tachiniererin/glasgow/hardware/boards/glasgow/revD1/glasgow.pdf

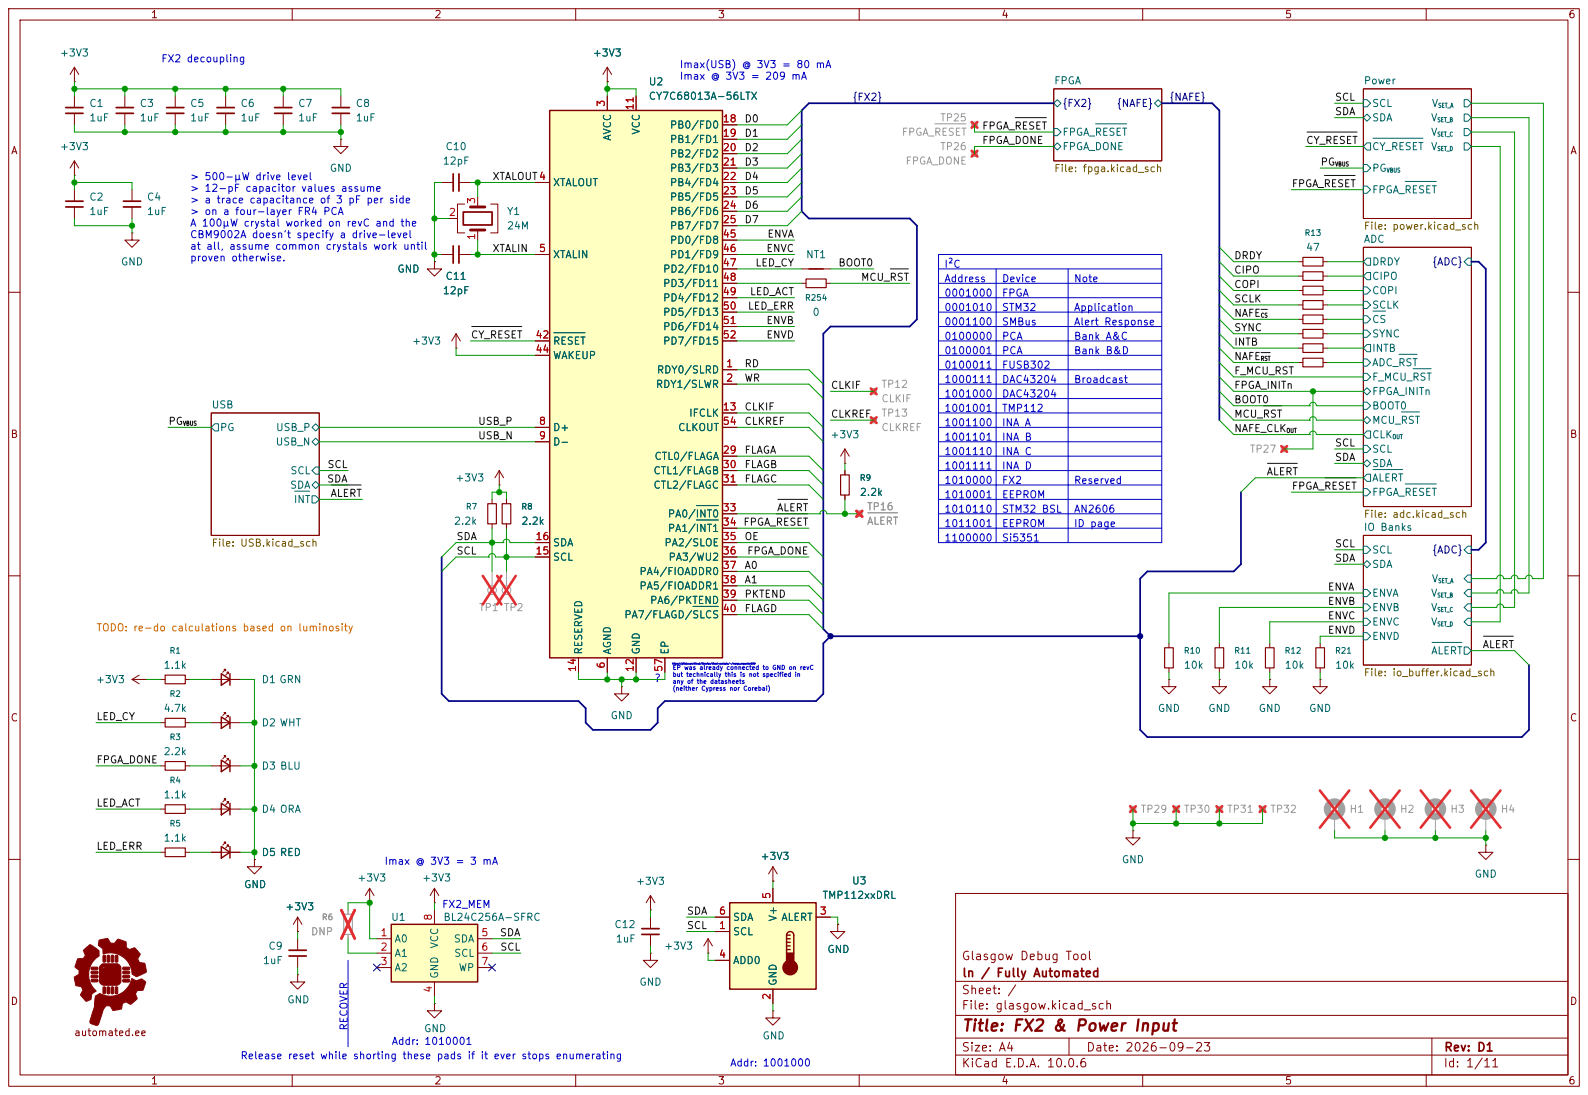
[picture p1: page 1]

FX2 decoupling > 500-µW drive level > 12-pF capacitor values assume > a trace capacitance of 3 pF per side > on a four-layer FR4 PCA

VSET_A VSET_B VSET_C CY_RESET VSET_D PGVBUS FPGA_RESET Power File: power.kicad_sch SYNC
SDA SCL CY_RESET SDA BOOT0

A 100µW crystal worked on revC and the CBM9002A doesn't specify a drive-level at all, assume common crystals work until proven otherwise.

0100011 | FUSB302
1000111 | DAC43204 | Broadcast 1001000

1001001 | TMP112

1010000 | FX2 EEPROM | Reserved 1010001

1010110 | STM32 BSL | AN2606

TODO: re-do calculations based on luminosity

https://gitlab.com/kicad/libraries/kicad-symbols/-/merge_requests/289
EP was already connected to GND on revC
but technically this is not specified in
any of the datasheets

Size: A4 | Rev: D1
KiCad E.D.A. 10.0.6 | Id: 1/11

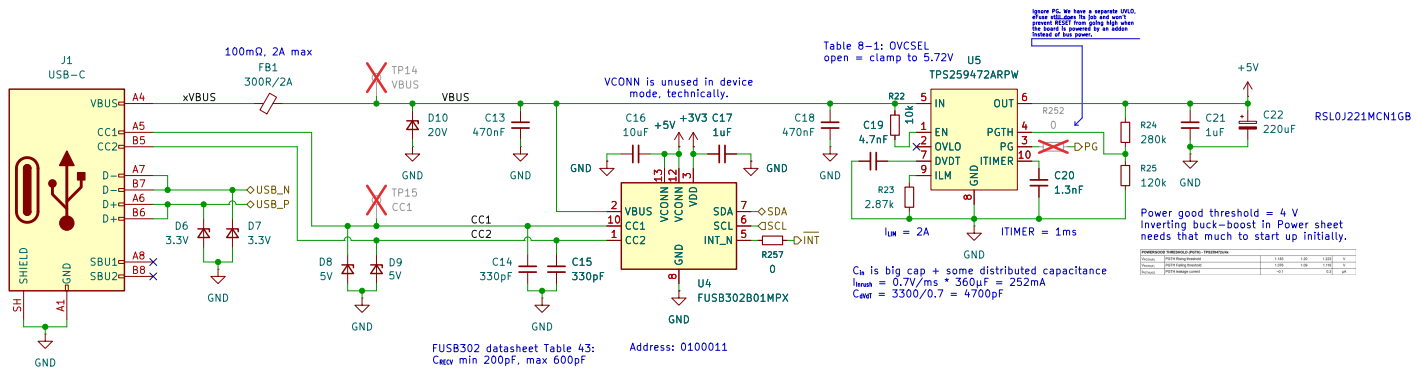
[picture p2: page 2]

Ignore PG. We have a separate UVLO, eFuse still does its job and won't prevent RESET from going high when

instead of bus power. Cin is big cap + some distributed capacitance
Table 8-1: OVCSEL open = clamp to 5.72V U5

the board is powered by an addon

Inverting buck-boost in Power sheet needs that much to start up initially. FUSB302 datasheet Table 43: CRECV min 200pF, max 600pF

Glasgow Debug Tool GND

ln / Fully Automated
Sheet: /USB/
File: USB.kicad_sch
Title: USB input protection

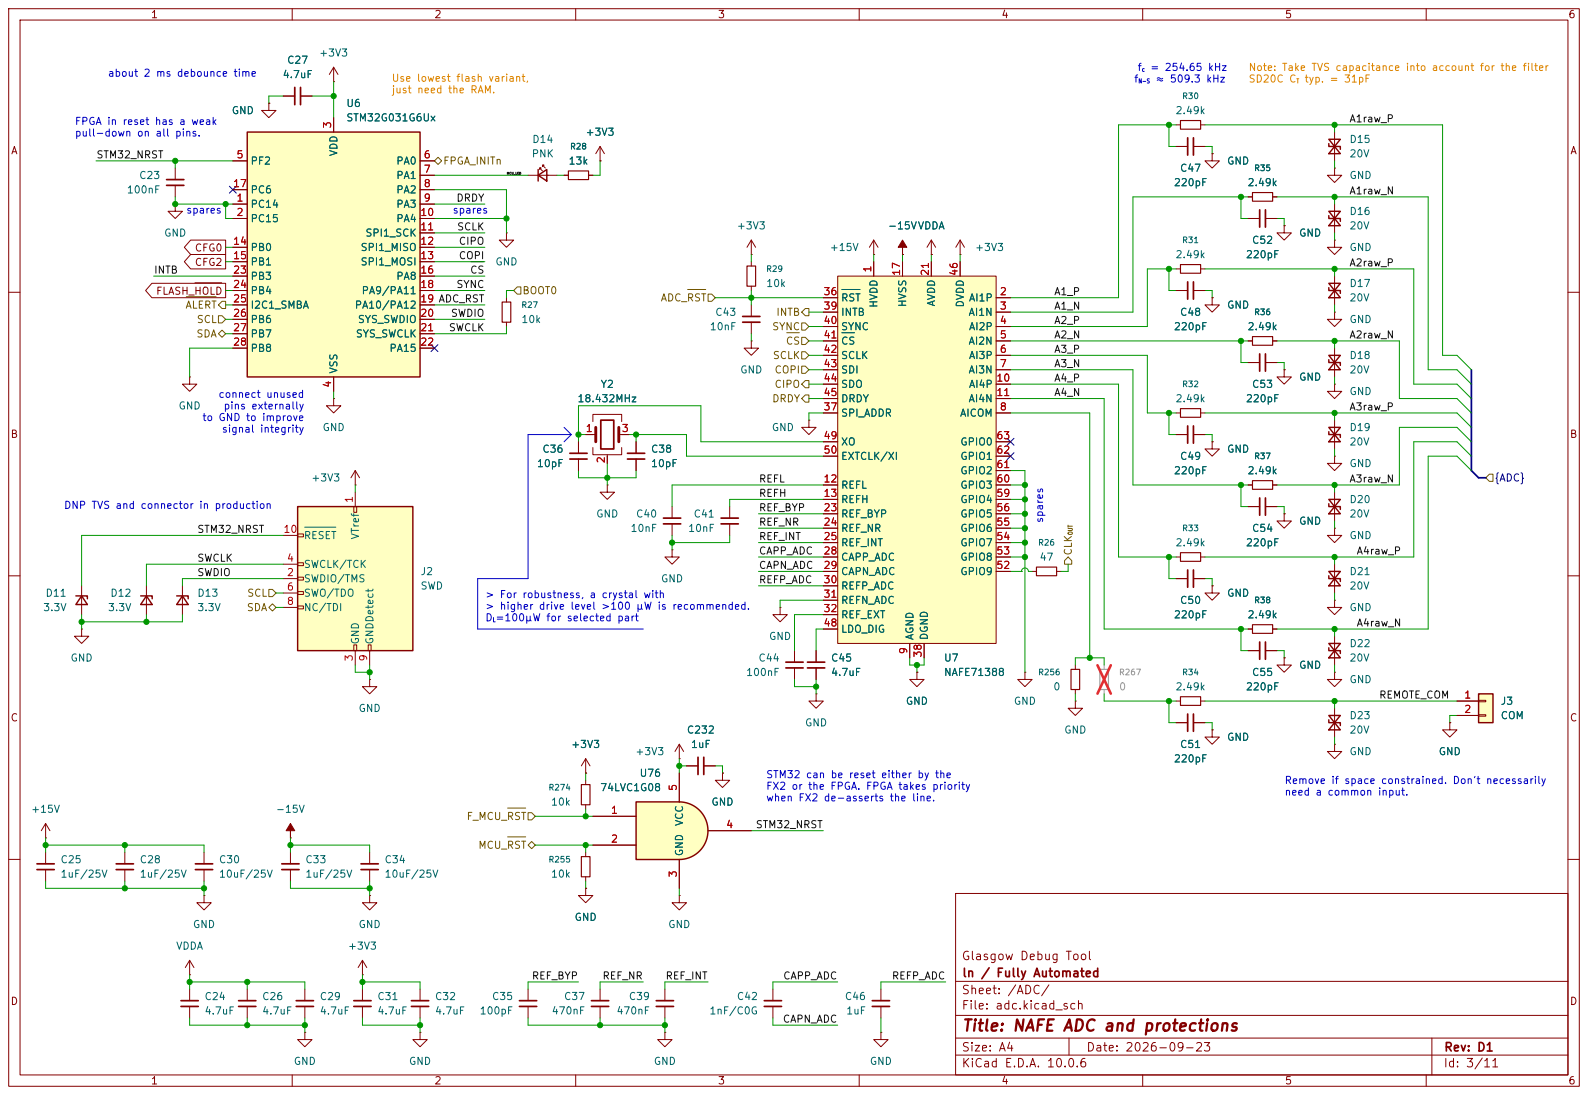
[picture p3: page 3]

just need the RAM. connect unused
GND

spares Use lowest flash variant,

pins externally
to GND to improve

FX2 or the FPGA. FPGA takes priority when FX2 de-asserts the line.

ln / Fully Automated
Sheet: /ADC/
File: adc.kicad_sch
Title: NAFE ADC and protections

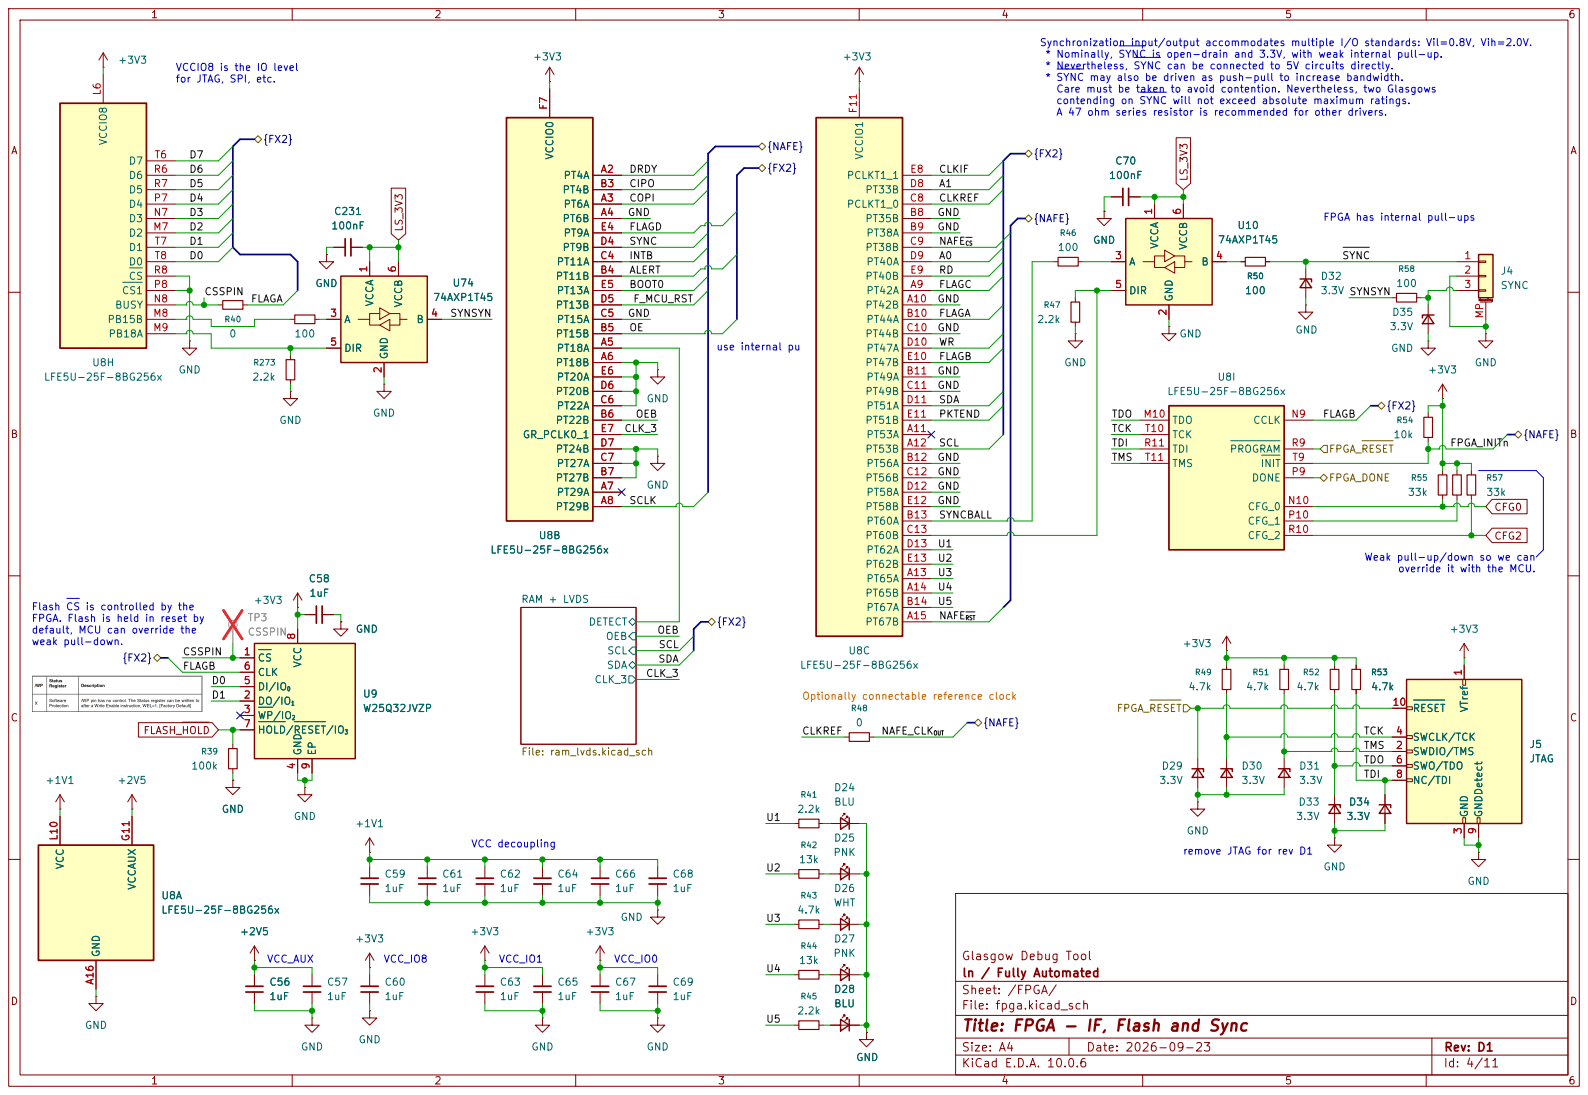
[picture p4: page 4]

Synchronization input/output accommodates multiple I/O standards: Vil=0.8V, Vih=2.0V. * Nominally, SYNC is open-drain and 3.3V, with weak internal pull-up. * Nevertheless, SYNC can be connected to 5V circuits directly. * SYNC may also be driven as push-pull to increase bandwidth. Care must be taken to avoid contention. Nevertheless, two Glasgows

VCCIO8 is the IO level for JTAG, SPI, etc.

contending on SYNC will not exceed absolute maximum ratings. A 47 ohm series resistor is recommended for other drivers.

FPGA has internal pull-ups Weak pull-up/down so we can

override it with the MCU. use internal pu

SCL SDA CLK_3 RAM + LVDS

Flash CS is controlled by the
FPGA. Flash is held in reset by

Glasgow Debug Tool DETECT OEB

4 DI/IO0 5 CLK 6 HOLD/RESET/IO3 7 VCC

remove JTAG for rev D1

ln / Fully Automated
Sheet: /FPGA/
File: fpga.kicad_sch
Title: FPGA - IF, Flash and Sync

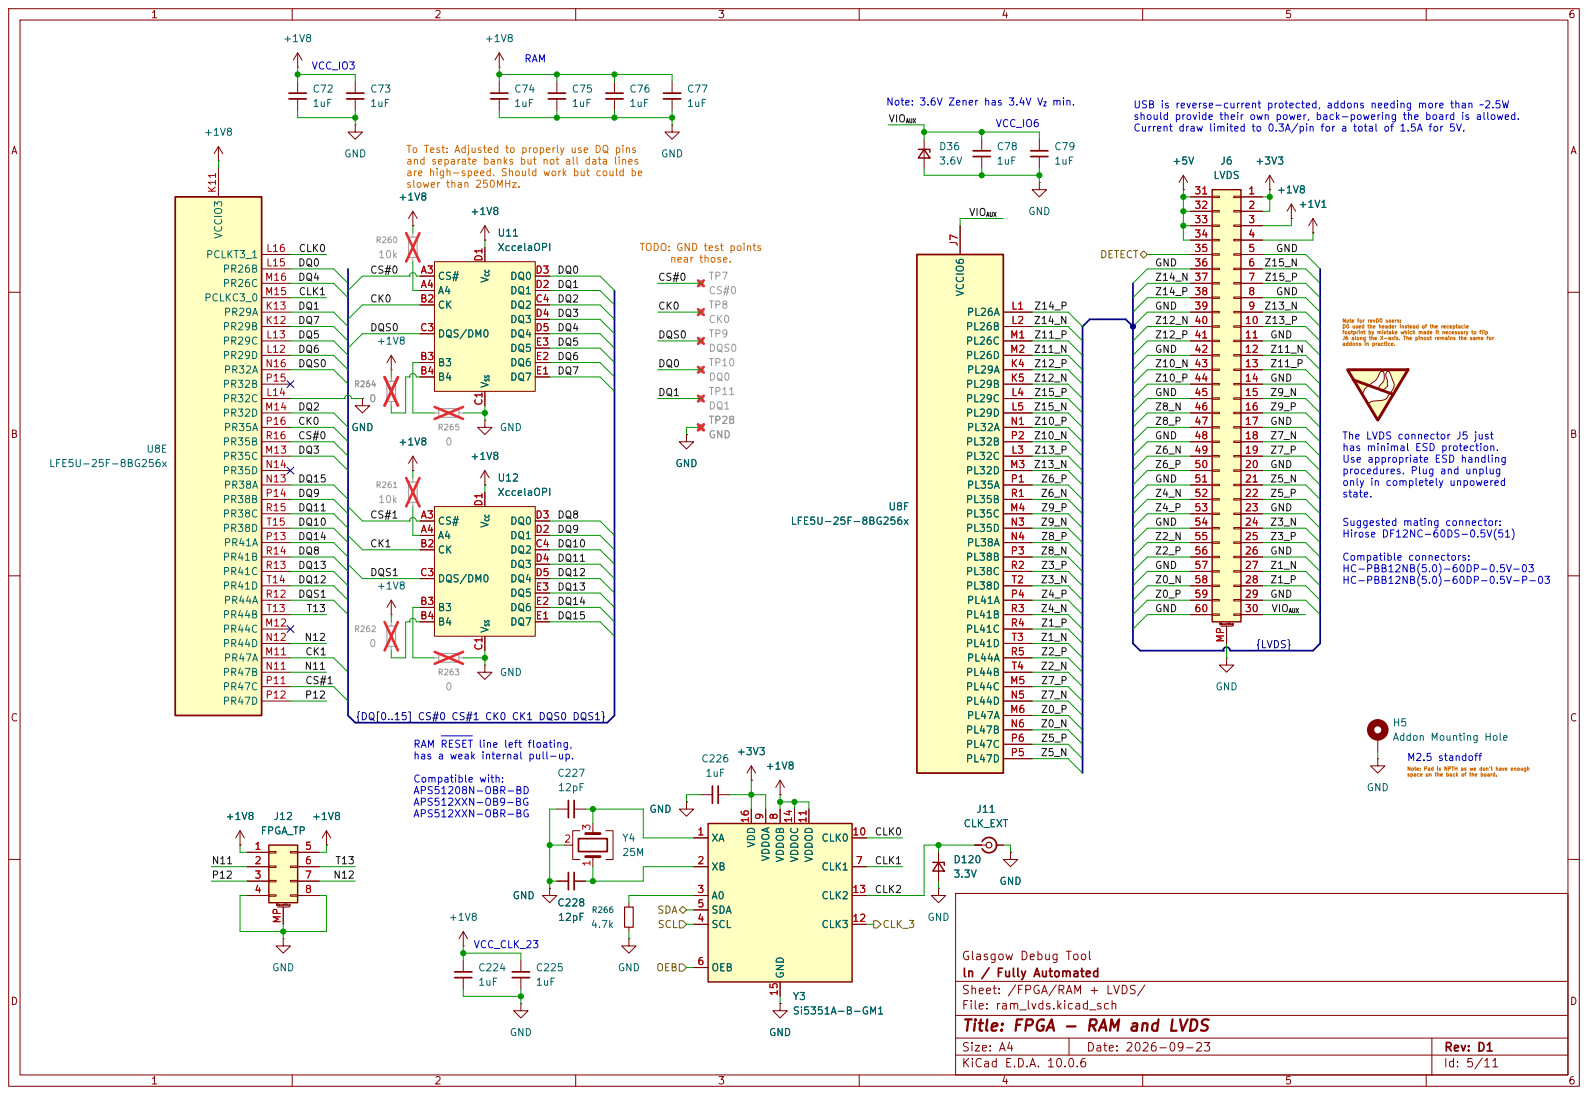
[picture p5: page 5]

J6 along the X-axis. The pinout remains the same for addons in practice. USB is reverse-current protected, addons needing more than ~2.5W

should provide their own power, back-powering the board is allowed. Current draw limited to 0.3A/pin for a total of 1.5A for 5V. VCC_IO6

To Test: Adjusted to properly use DQ pins and separate banks but not all data lines are high-speed. Should work but could be
DQS0 DQ13 DQ8 DQ10

Addon Mounting Hole GND +1V8 +1V8

DETECT SDA SCL OEB

GND
space on the back of the board. M2.5 standoff The LVDS connector J5 just has minimal ESD protection. Use appropriate ESD handling

footprint by mistake which made it necessary to flip

procedures. Plug and unplug

only in completely unpowered state. RAM RESET line left floating, has a weak internal pull-up.

Compatible connectors: HC-PBB12NB(5.0)-60DP-0.5V-03 HC-PBB12NB(5.0)-60DP-0.5V-P-03

Compatible with: APS51208N-OBR-BD

Note: Pad is NPTH as we don't have enough

8 VDDOA 9 CLK0 10 VDDOD 11 CLK3 12 CLK2 13 VDDOC 14 GND 15 VDD 16

8 VDDOA 9 CLK0 10 VDDOD 11 CLK3 12 CLK2 13 VDDOC 14 GND 15 VDD 16 GND

Glasgow Debug Tool GND

ln / Fully Automated
Sheet: /FPGA/RAM + LVDS/
File: ram_lvds.kicad_sch
Title: FPGA - RAM and LVDS

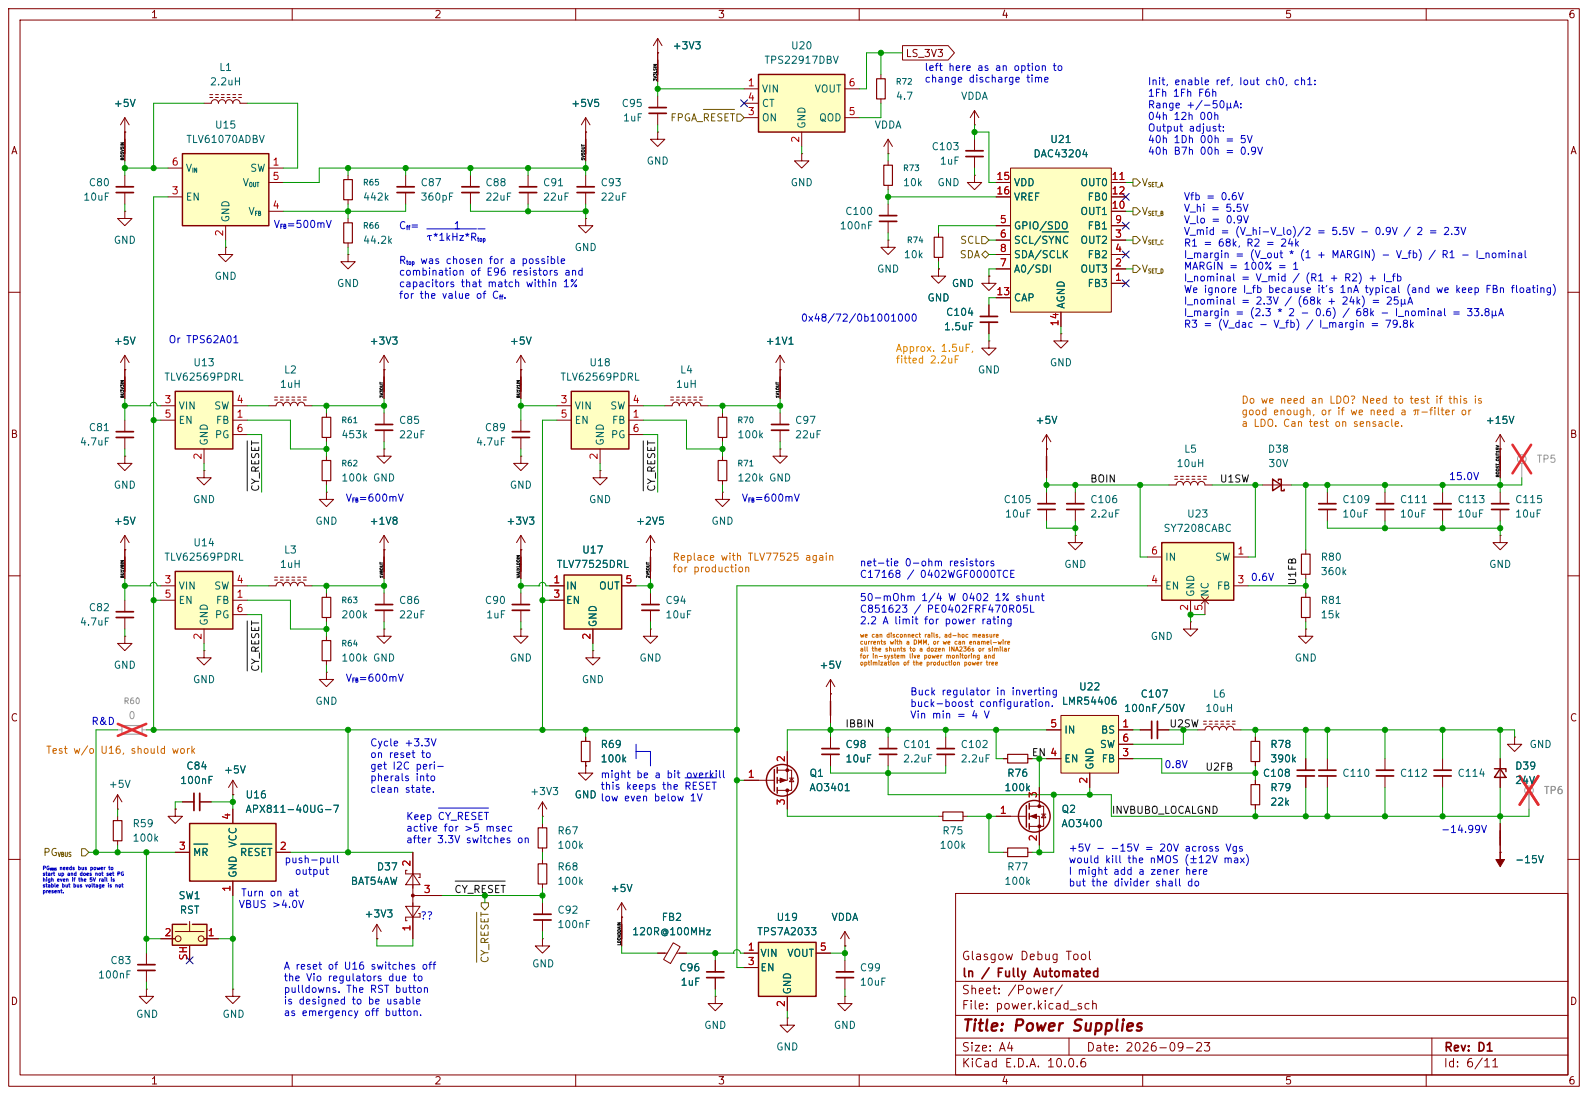
[picture p6: page 6]

left here as an option to

change discharge time Cycle +3.3V on reset to get I2C peri-

Init, enable ref, Iout ch0, ch1: 1Fh 1Fh F6h Range +/-50µA: 04h 12h 00h Output adjust: 40h 1Dh 00h = 5V 40h B7h 00h = 0.9V

τ*1kHz*Rtop Rtop was chosen for a possible

combination of E96 resistors and
capacitors that match within 1%

I_nominal = V_mid / (R1 + R2) + I_fb We ignore I_fb because it's 1nA typical (and we keep FBn floating)

we can disconnect rails, ad-hoc measure
currents with a DMM, or we can enamel-wire all the shunts to a dozen INA236s or similar

for in-system live power monitoring and
optimization of the production power tree Buck regulator in inverting

buck-boost configuration. Vin min = 4 V push-pull

pherals into clean state. ?? Keep CY_RESET active for >5 msec after 3.3V switches on

PGVBUS needs bus power to
start up and does not set PG
high even if the 5V rail is
stable but bus voltage is not present.

Turn on at VBUS >4.0V

A reset of U16 switches off
the Vio regulators due to pulldowns. The RST button

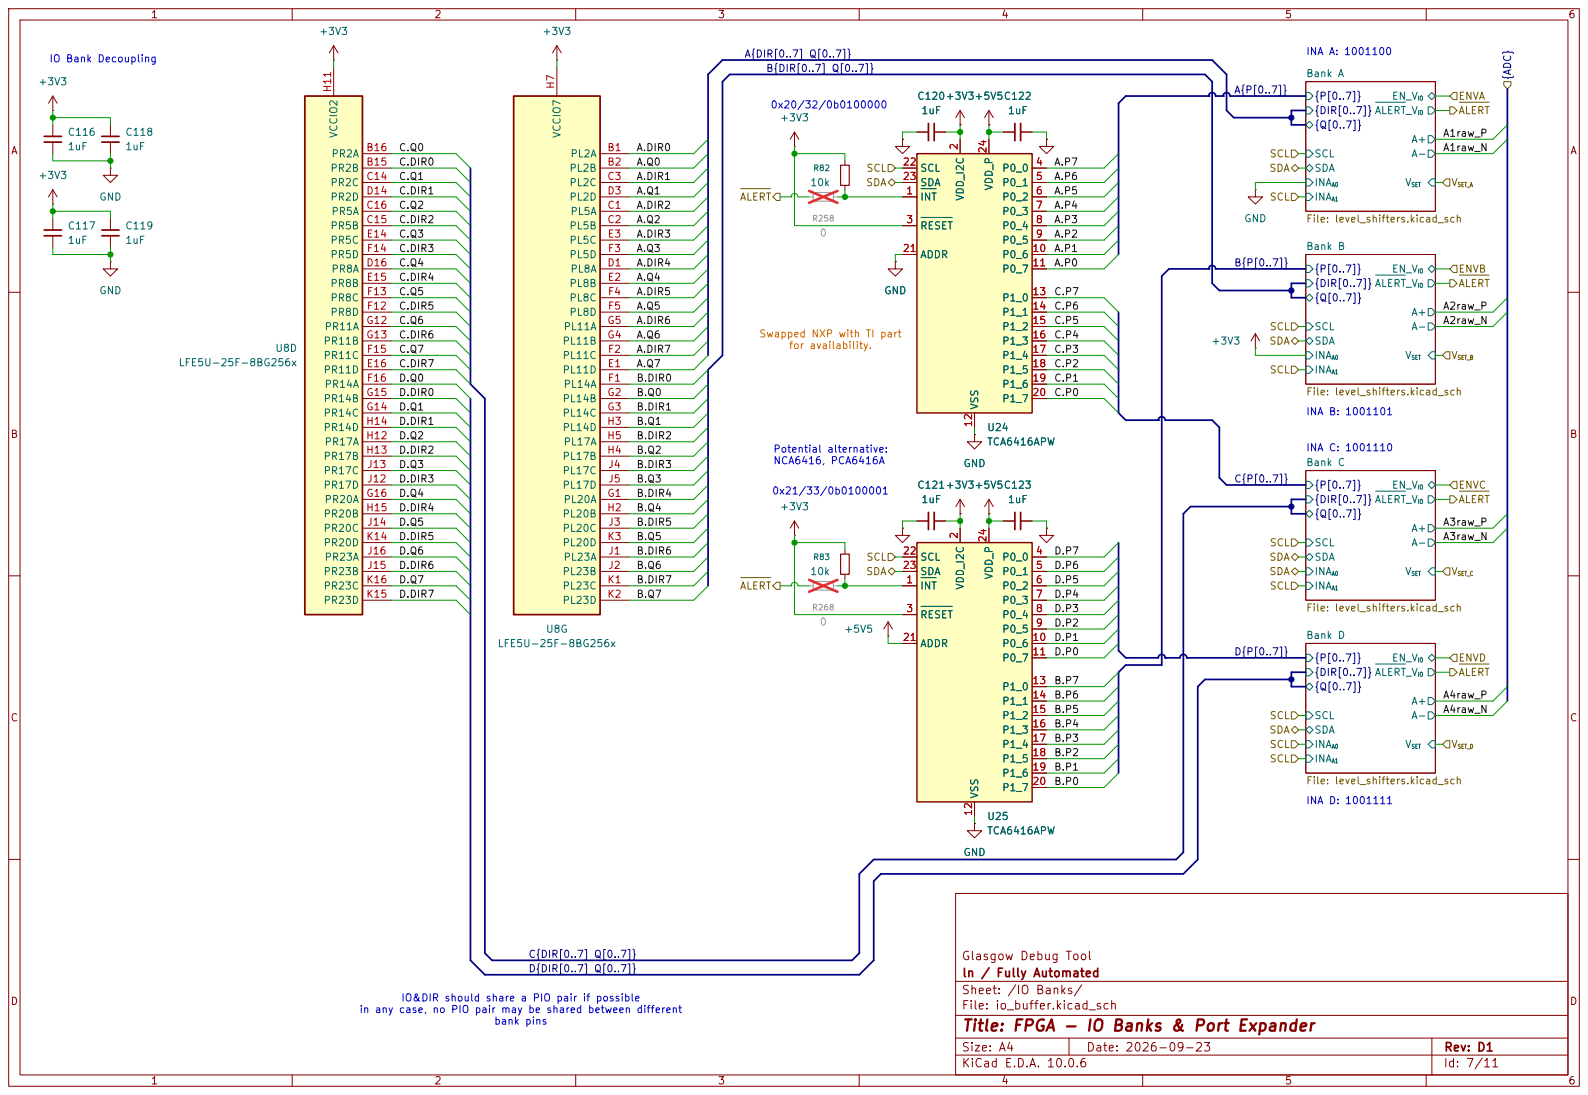
[picture p7: page 7]

Swapped NXP with TI part
for availability.
SCL 22

Glasgow Debug Tool
ln / Fully Automated
Sheet: /IO Banks/
File: io_buffer.kicad_sch
Title: FPGA - IO Banks & Port Expander

IO&DIR should share a PIO pair if possible

in any case, no PIO pair may be shared between different bank pins

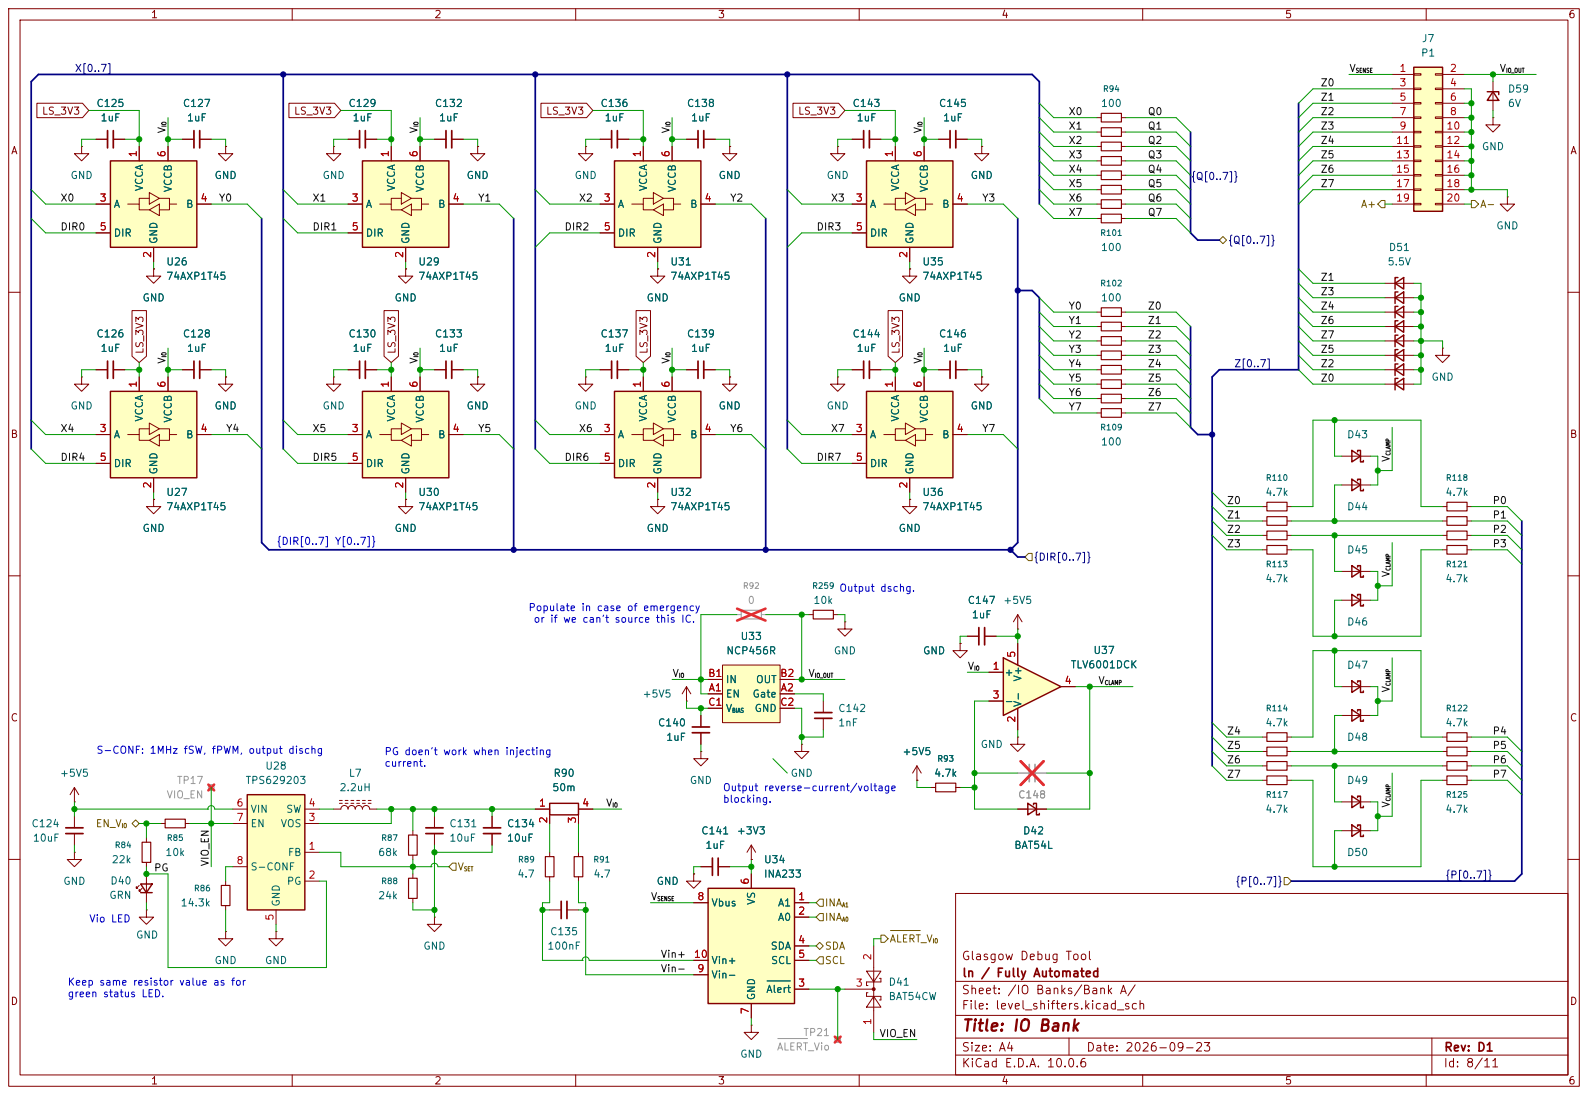
[picture p8: page 8]

{DIR[0..7] Y[0..7]} S-CONF: 1MHz fSW, fPWM, output dischg

Populate in case of emergency or if we can't source this IC. PG doen't work when injecting

Output reverse-current/voltage
blocking.

Keep same resistor value as for green status LED. Vio LED

ln / Fully Automated
Sheet: /IO Banks/Bank A/
File: level_shifters.kicad_sch
Title: IO Bank

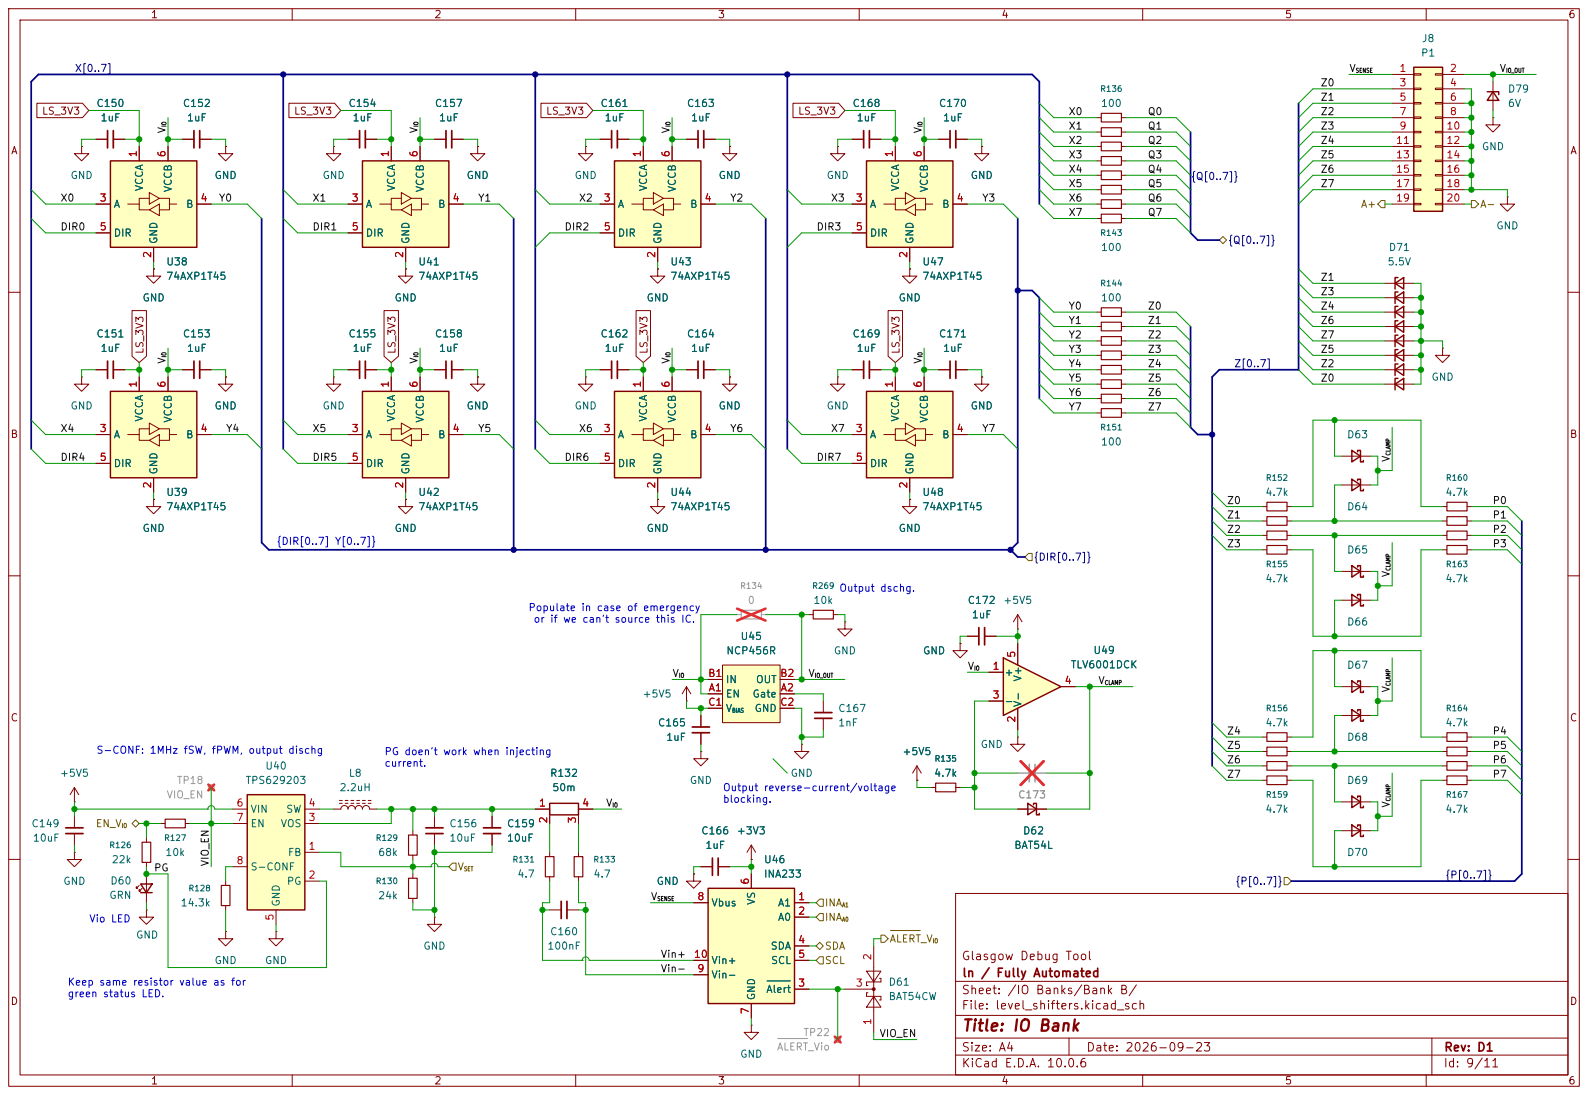
[picture p9: page 9]

{DIR[0..7] Y[0..7]} S-CONF: 1MHz fSW, fPWM, output dischg

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

Keep same resistor value as for green status LED. Vio LED

ln / Fully Automated
Sheet: /IO Banks/Bank B/
File: level_shifters.kicad_sch
Title: IO Bank

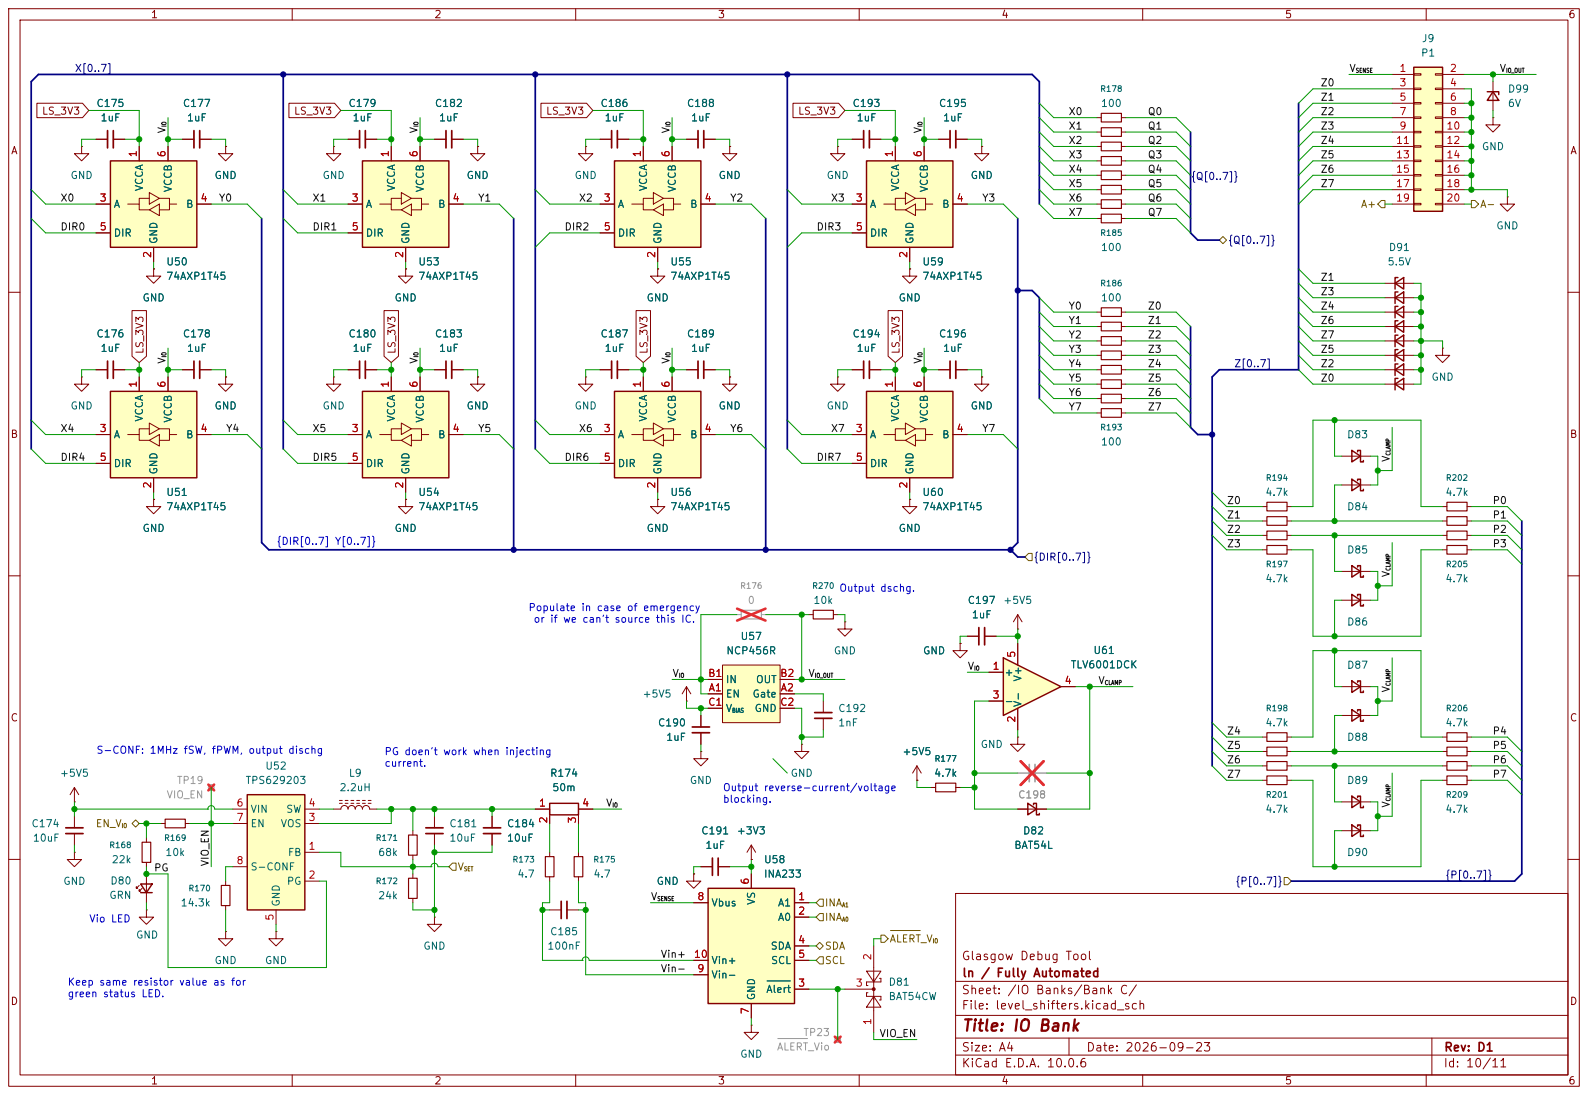
[picture p10: page 10]

{DIR[0..7] Y[0..7]} S-CONF: 1MHz fSW, fPWM, output dischg

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

Output reverse-current/voltage
blocking.

Keep same resistor value as for green status LED. Vio LED

ln / Fully Automated
Sheet: /IO Banks/Bank C/
File: level_shifters.kicad_sch
Title: IO Bank

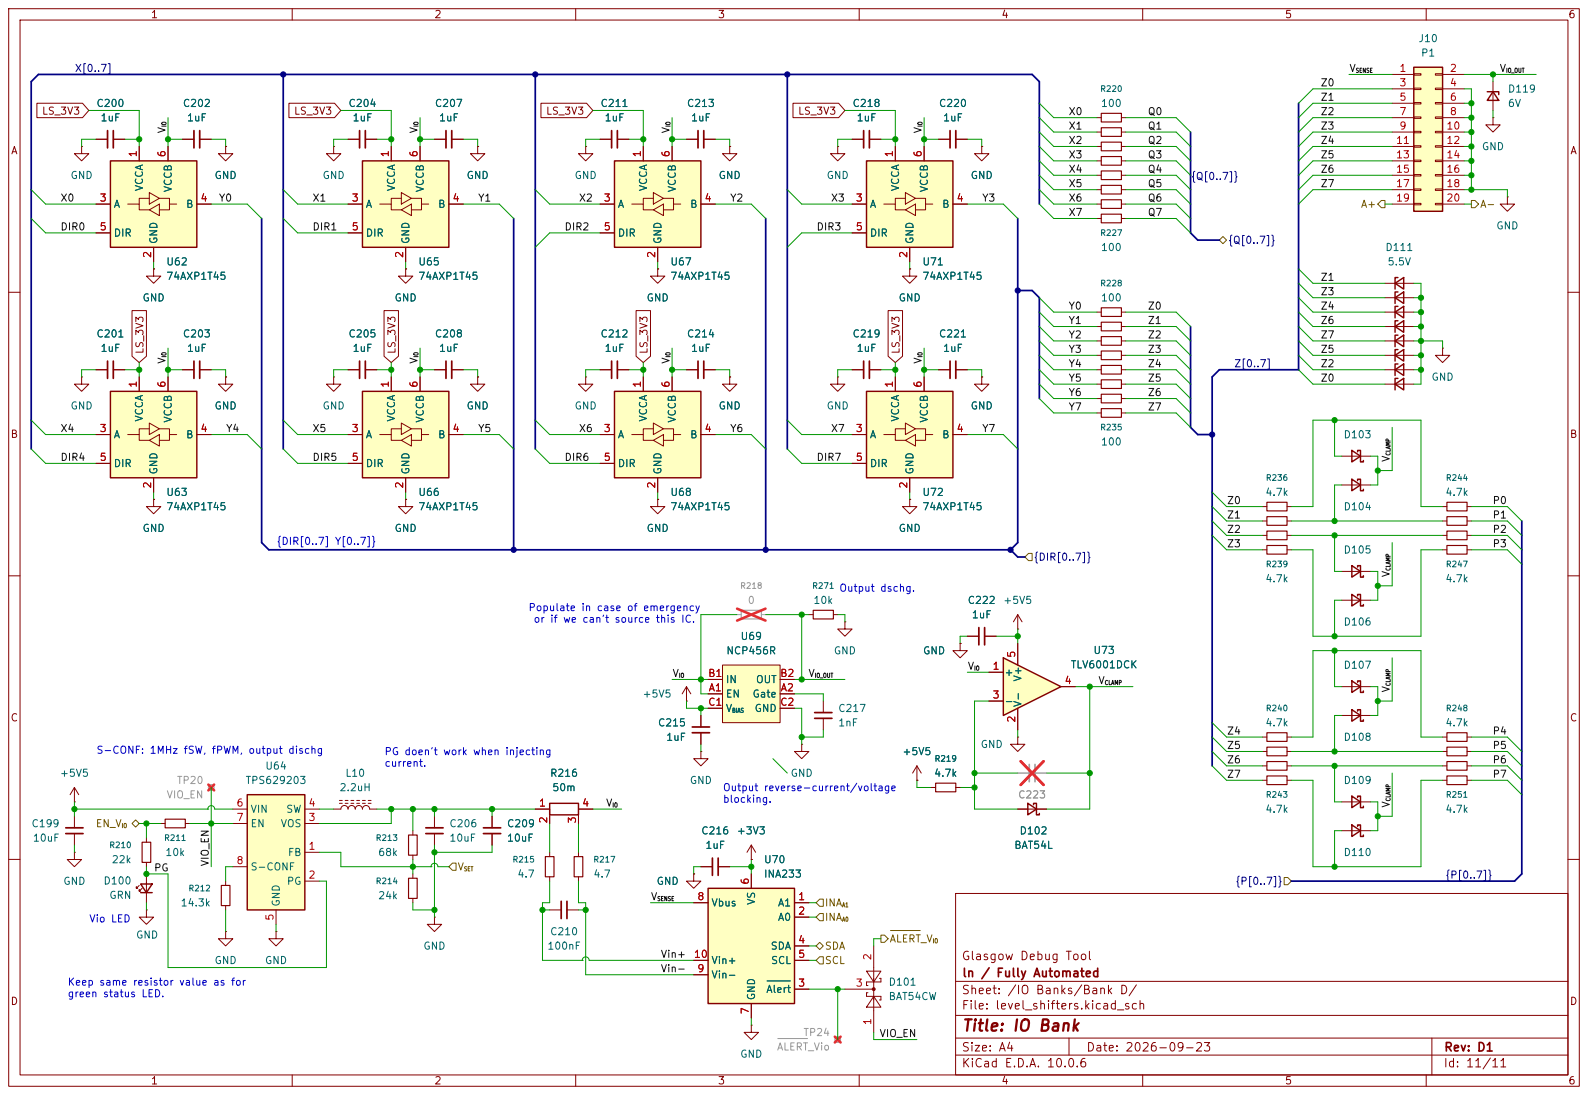
[picture p11: page 11]

{DIR[0..7] Y[0..7]} S-CONF: 1MHz fSW, fPWM, output dischg

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

Output reverse-current/voltage
blocking.

Keep same resistor value as for green status LED. Vio LED

ln / Fully Automated
Sheet: /IO Banks/Bank D/
File: level_shifters.kicad_sch
Title: IO Bank
