tachiniererin/glasgow/(commit log)

2026-06-09 wip rev_d pin mapping
2026-09-01 add wip revD1
    [USB.kicad_sch, adc.kicad_sch, fpga.kicad_sch, glasgow.kicad_pcb, glasgow.kicad_sch, io_buffer.kicad_sch, level_shifters.kicad_sch, power.kicad_sch]
2026-09-01 add clock gen
    [USB.kicad_sch, adc.kicad_sch, fpga.kicad_sch, glasgow.kicad_sch, io_buffer.kicad_sch, level_shifters.kicad_sch, power.kicad_sch, ram_lvds.kicad_sch]
2026-09-03 start from 4 V, new inv bubo, more testpoints, synsyn through LS
    [USB.kicad_sch, adc.kicad_sch, fpga.kicad_sch, glasgow.kicad_sch, io_buffer.kicad_sch, level_shifters.kicad_sch, power.kicad_sch, ram_lvds.kicad_sch]
2026-09-04 add the rest of mandatory testpoints
    [adc.kicad_sch, fpga.kicad_sch, glasgow.kicad_pcb, glasgow.kicad_sch]
2026-09-04 pop bulk for adc
    [adc.kicad_sch]
2026-09-08 make mcu reset logic more robust
    [adc.kicad_sch, fpga.kicad_sch, glasgow.kicad_pcb, glasgow.kicad_sch]
2026-09-17 get routed
    [adc.kicad_sch, fpga.kicad_sch, glasgow.kicad_pcb, glasgow.kicad_sch, io_buffer.kicad_sch, level_shifters.kicad_sch, power.kicad_sch, ram_lvds.kicad_sch]
2026-09-18 some physical changes
    replace sync connector with JST SH
    round corners of the PCB to match the mounting holes
    place io bank LEDs symmetrically and in a way that should make the case work
    [fpga.kicad_sch, glasgow.kicad_pcb]
2026-09-18 plot schematic
2026-09-21 wip pcb changes
    [glasgow.kicad_pcb, ram_lvds.kicad_sch]
2026-09-21 update bom
    [USB.kicad_sch, adc.kicad_sch, fpga.kicad_sch, glasgow.kicad_pcb, glasgow.kicad_sch, io_buffer.kicad_sch, level_shifters.kicad_sch, power.kicad_sch]
2026-09-21 fix some more silk issues
    [glasgow.kicad_pcb]
2026-09-22 improve LED clearance, add heatsink area below -15V, improve gnd connection for STM32
    [glasgow.kicad_pcb]
2026-09-22 misc review changes
    disconnect eFuse PG and add comments in schematic as to why
    add slew-rate limiting resistor to NAFE clock
    add esd diode to external clock output
    fix USB D+/D- diff-pairs
    update schematic to current date and set revision to D1
    fix RAM balls B3/B4 assignment
    [USB.kicad_sch, adc.kicad_sch, fpga.kicad_sch, glasgow.kicad_pcb, glasgow.kicad_sch, io_buffer.kicad_sch, level_shifters.kicad_sch, power.kicad_sch]
2026-09-23 update LVDS connector
    add more ground test points on the back
    [USB.kicad_sch, adc.kicad_sch, fpga.kicad_sch, glasgow.kicad_pcb, glasgow.kicad_sch, io_buffer.kicad_sch, level_shifters.kicad_sch, power.kicad_sch]
2026-09-23 add LED datasheets and re-do brightness calculations
    [fpga.kicad_sch, glasgow.kicad_sch]
2026-09-23 new artwork
    [glasgow.kicad_pcb]
