tachiniererin/glasgow/hardware/boards/glasgow/revD1/glasgow.kicad_pcb

## KiCad design hardware/boards/glasgow/revD1/glasgow.kicad_pcb (2026-09-23)

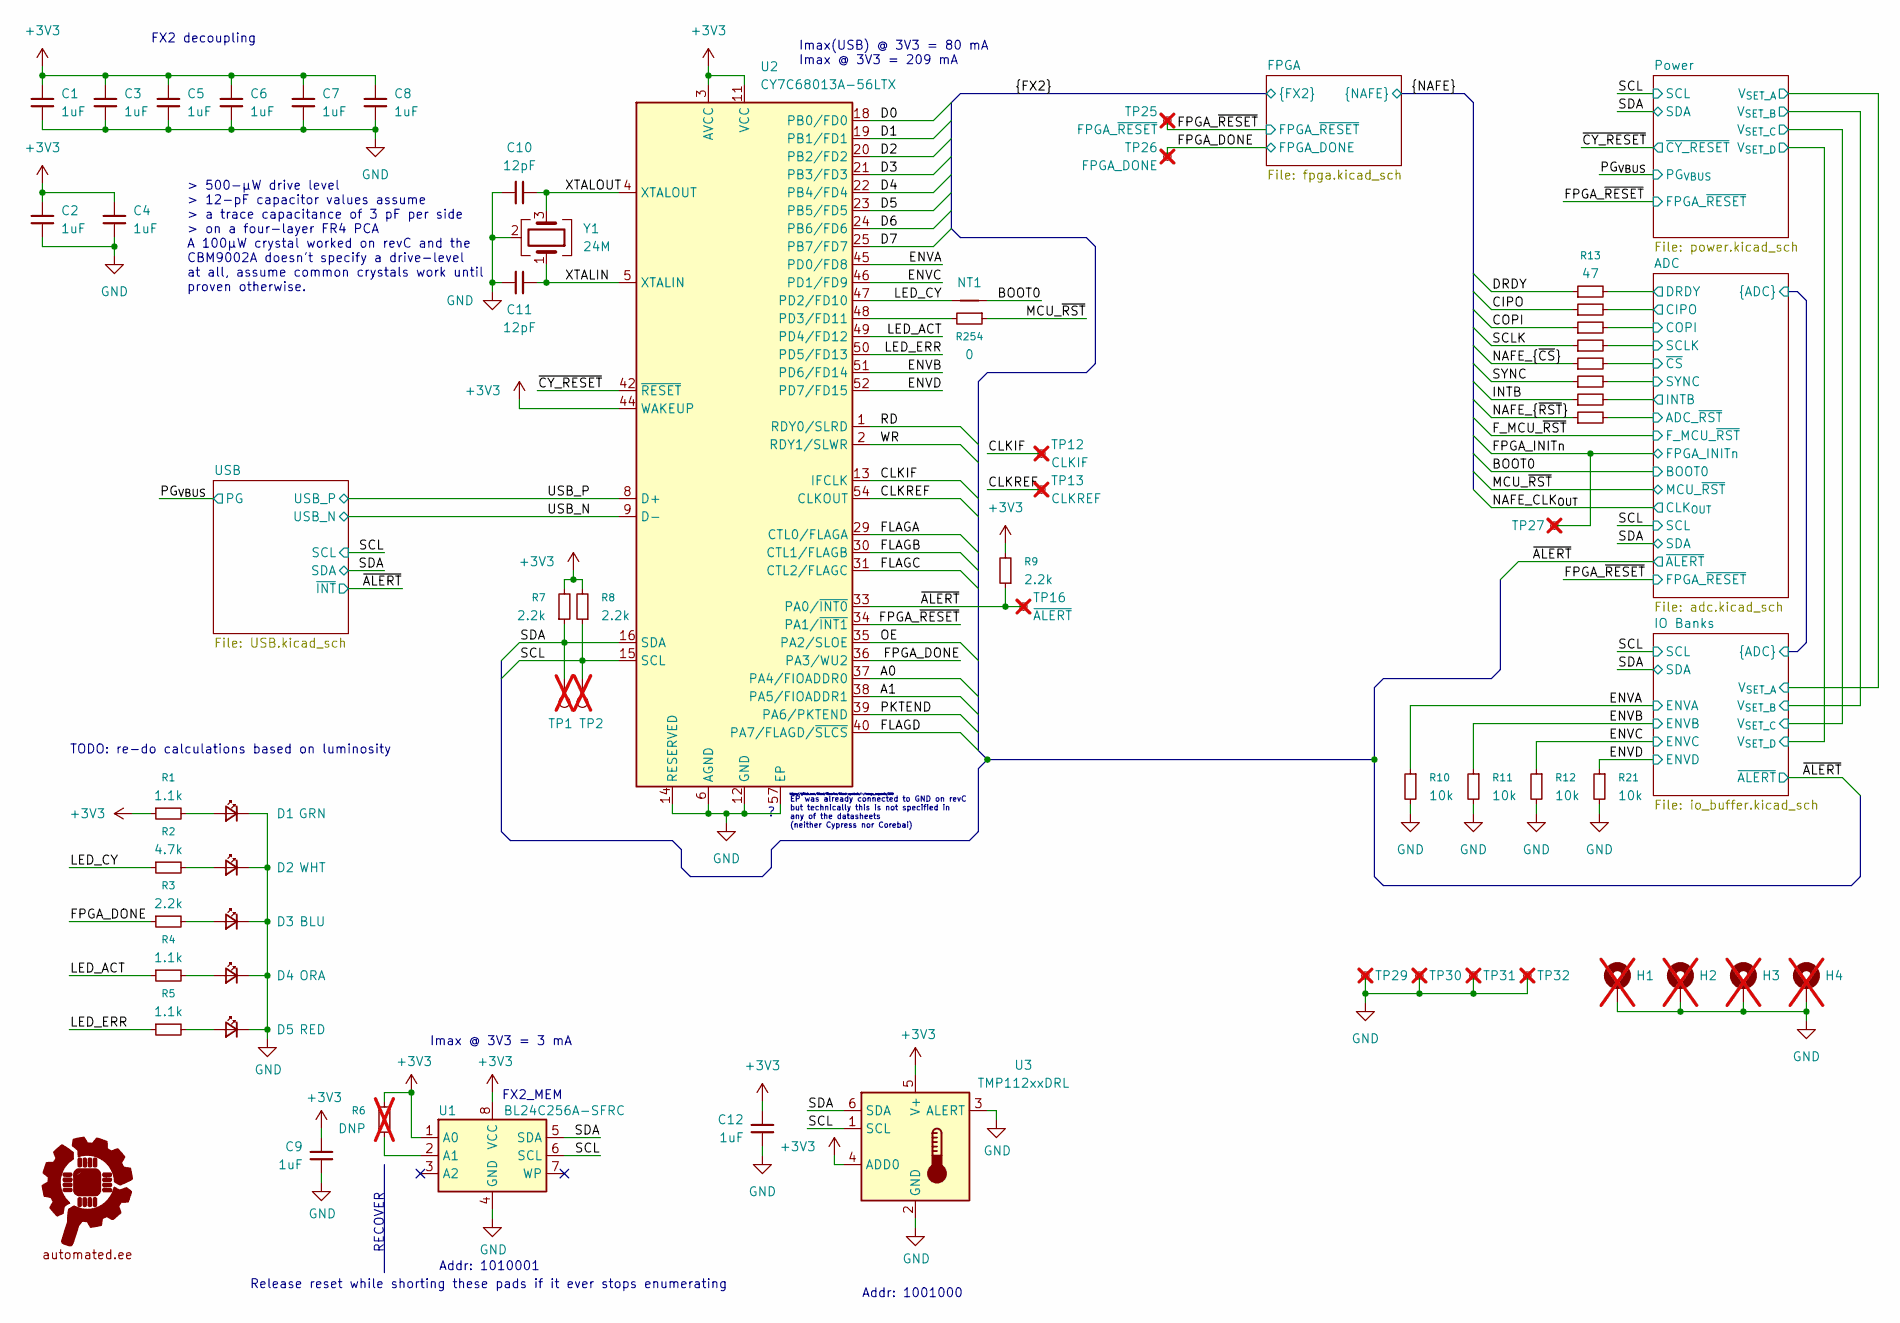
[picture p1: schematic glasgow.kicad_sch, FX2 & Power Input]

Parts:
C1, C2, C3, C4, C5, C6, C7, C8, C9, C12: 1uF; C_0402_1005Metric; MPN CL05A105KA5NQNC; LCSC C52923
C10, C11: 12pF; C_0402_1005Metric; MPN 0402CG120J500NT; LCSC C1547
D1: GRN; LED_0603_1608Metric; MPN NCD0603G1; LCSC C2986048
D2: WHT; LED_0603_1608Metric; MPN NCD0603W1; LCSC C2290
D3: BLU; LED_0603_1608Metric; MPN ORH-B36G; LCSC C2986058
D4: ORA; LED_0603_1608Metric; MPN NCD0603O1; LCSC C84269
D5: RED; LED_0603_1608Metric; MPN NCD0603R1; LCSC C2986060
G1: Fully_Automated_Logo; fully_automated_logo_silkscreen
H1, H2, H3, H4: MountingHole_Pad; MountingHole_3.2mm_M3_Pad; not fitted
NT1: ACT_BOOT; NetTie-2_SMD_Pad0.5mm
R1, R4, R5: 1.1k; R_0402_1005Metric; MPN 0402WGF1101TCE; LCSC C25860
R2: 4.7k; R_0402_1005Metric; MPN 0402WGF4701TCE; LCSC C25900
R3, R7, R8, R9: 2.2k; R_0402_1005Metric; MPN RC0402FR-132K2L; LCSC C25879
R6: DNP; R_0402_1005Metric; not fitted
R10, R11, R12, R21: 10k; R_0402_1005Metric; MPN 0402WGF1002TCE; LCSC C25744
R13, R14, R15, R16, R17, R18, R19, R20: 47; R_0201_0603Metric; MPN 0201WMF470JTEE; LCSC C620443
R254: 0; R_0402_1005Metric; MPN PE0402FRF470R05L; LCSC C851623
TP1: SDA; TestPoint_Pad_D1.0mm; not fitted
TP2: SCL; TestPoint_Pad_D1.0mm; not fitted
TP12: CLKIF; TestPoint_Pad_D0.5mm; not fitted
TP13: CLKREF; TestPoint_Pad_D0.5mm; not fitted
TP16: ~{ALERT}; TestPoint_Pad_D0.5mm; not fitted
TP25: FPGA_~{RESET}; TestPoint_Pad_D0.5mm; not fitted
TP26: FPGA_DONE; TestPoint_Pad_D0.5mm; not fitted
TP27: FPGA_INITn; TestPoint_Pad_D0.5mm; not fitted
TP29, TP30, TP31, TP32: GND; TestPoint_Pad_D0.5mm; not fitted
U1: BL24C256A-SFRC; TSSOP-8_4.4x3mm_P0.65mm; MPN BL24C256A-SFRC; LCSC C110276
U2: CY7C68013A-56LTX; QFN-56-1EP_8x8mm_P0.5mm_EP4.5x5.2mm; MPN CBM9002A-56ILG; LCSC C476253
U3: TMP112xxDRL; SOT-563; MPN TMP112AIDRLR; LCSC C28927
Y1: 24M; Crystal_SMD_3225-4Pin_3.2x2.5mm; MPN TSX-3225 24.0000MF20G-AC3; LCSC C2650460

Connections:
+3V3: C1.1, C2.1, C3.1, C4.1, C5.1, C6.1, C7.1, C8.1, C9.1, C12.1, R1.1, R6.2, R7.2, R8.2, R9.2, U1.1 (A0), U1.8 (VCC), U2.3 (AVCC), U2.7 (AVCC), U2.11 (VCC), U2.17 (VCC), U2.27 (VCC), U2.32 (VCC), U2.43 (VCC), U2.44 (WAKEUP), U2.55 (VCC), U3.4 (ADD0), U3.5 (V+); also elsewhere on the board
/A0: U2.37 (PA4/FIOADDR0); also elsewhere on the board
/A1: U2.38 (PA5/FIOADDR1); also elsewhere on the board
/ADC/ADC_~RST: R20.2; also elsewhere on the board
/ADC/CIPO: R14.2; also elsewhere on the board
/ADC/COPI: R15.2; also elsewhere on the board
/ADC/DRDY: R13.2; also elsewhere on the board
/ADC/INTB: R19.2; also elsewhere on the board
/ADC/SCLK: R16.2; also elsewhere on the board
/ADC/SYNC: R18.2; also elsewhere on the board
/ADC/~CS: R17.2; also elsewhere on the board
/BOOT0: NT1.2; also elsewhere on the board
/CIPO: R14.1; also elsewhere on the board
/CLKIF: TP12.1 (1_1), U2.13 (IFCLK); also elsewhere on the board
/CLKREF: TP13.1 (1_1), U2.54 (CLKOUT); also elsewhere on the board
/COPI: R15.1; also elsewhere on the board
/D0: U2.18 (PB0/FD0); also elsewhere on the board
/D1: U2.19 (PB1/FD1); also elsewhere on the board
/D2: U2.20 (PB2/FD2); also elsewhere on the board
/D3: U2.21 (PB3/FD3); also elsewhere on the board
/D4: U2.22 (PB4/FD4); also elsewhere on the board
/D5: U2.23 (PB5/FD5); also elsewhere on the board
/D6: U2.24 (PB6/FD6); also elsewhere on the board
/D7: U2.25 (PB7/FD7); also elsewhere on the board
/DRDY: R13.1; also elsewhere on the board
/ENVA: R10.1, U2.45 (PD0/FD8); also elsewhere on the board
/ENVB: R11.1, U2.51 (PD6/FD14); also elsewhere on the board
/ENVC: R12.1, U2.46 (PD1/FD9); also elsewhere on the board
/ENVD: R21.1, U2.52 (PD7/FD15); also elsewhere on the board
/FLAGA: U2.29 (CTL0/FLAGA); also elsewhere on the board
/FLAGB: U2.30 (CTL1/FLAGB); also elsewhere on the board
/FLAGC: U2.31 (CTL2/FLAGC); also elsewhere on the board
/FLAGD: U2.40 (PA7/FLAGD/~SLCS); also elsewhere on the board
/FPGA_DONE: R3.1, TP26.1 (1_1), U2.36 (PA3/WU2); also elsewhere on the board
/FPGA_INITn: TP27.1 (1_1); also elsewhere on the board
/FPGA_~RESET: TP25.1 (1_1), U2.34 (PA1/~INT1); also elsewhere on the board
/INTB: R19.1; also elsewhere on the board
/LED_ACT: R4.1, U2.49 (PD4/FD12)
/LED_CY: NT1.1, R2.1, U2.47 (PD2/FD10)
/LED_ERR: R5.1, U2.50 (PD5/FD13)
/MCU_~RST: R254.1; also elsewhere on the board
/NAFE_{~CS}: R17.1; also elsewhere on the board
/NAFE_{~RST}: R20.1; also elsewhere on the board
/OE: U2.35 (PA2/SLOE); also elsewhere on the board
/PKTEND: U2.39 (PA6/PKTEND); also elsewhere on the board
/RD: U2.1 (RDY0/SLRD); also elsewhere on the board
/SCL: R8.1, TP2.1 (1_1), U1.6 (SCL), U2.15 (SCL), U3.1 (SCL); also elsewhere on the board
/SCLK: R16.1; also elsewhere on the board
/SDA: R7.1, TP1.1 (1_1), U1.5 (SDA), U2.16 (SDA), U3.6 (SDA); also elsewhere on the board
/SYNC: R18.1; also elsewhere on the board
/USB_N: U2.9 (D-); also elsewhere on the board
/USB_P: U2.8 (D+); also elsewhere on the board
/WR: U2.2 (RDY1/SLWR); also elsewhere on the board
/XTALIN: C11.2, U2.5 (XTALIN), Y1.1
/XTALOUT: C10.2, U2.4 (XTALOUT), Y1.3
/~ALERT: R9.1, TP16.1 (1_1), U2.33 (PA0/~INT0); also elsewhere on the board
/~CY_RESET: U2.42 (~RESET); also elsewhere on the board
GND: C1.2, C2.2, C3.2, C4.2, C5.2, C6.2, C7.2, C8.2, C9.2, C10.1, C11.1, C12.2, D1.1 (K), D2.1 (K), D3.1 (K), D4.1 (K), D5.1 (K), H1.1 (1_1), H2.1 (1_1), H3.1 (1_1), H4.1 (1_1), R10.2, R11.2, R12.2, R21.2, TP29.1 (1_1), TP30.1 (1_1), TP31.1 (1_1), TP32.1 (1_1), U1.4 (GND), U2.6 (AGND), U2.10 (AGND), U2.12 (GND), U2.14 (RESERVED), U2.26 (GND), U2.28 (GND), U2.41 (GND), U2.53 (GND), U2.56 (GND), U2.57 (EP), U3.2 (GND), U3.3 (ALERT), Y1.2 (G), Y1.4 (G); also elsewhere on the board
unnamed: D1.2 (A), R1.2
unnamed: D2.2 (A), R2.2
unnamed: D3.2 (A), R3.2
unnamed: D4.2 (A), R4.2
unnamed: D5.2 (A), R5.2
unnamed: R6.1, U1.2 (A1)
unnamed: R254.2, U2.48 (PD3/FD11)

Notes on the sheet:
FX2_MEM
TODO: re-do calculations based on luminosity
Imax(USB) @ 3V3 = 80 mA Imax @ 3V3 = 209 mA
Addr: 1010001
> 500-µW drive level > 12-pF capacitor values assume > a trace capacitance of 3 pF per side > on a four-layer FR4 PCA A 100µW crystal worked on revC and the CBM9002A doesn't specify a drive-level at all, assume common crystals work until proven otherwise.
EP was already connected to GND on revC but technically this is not specified in any of the datasheets (neither Cypress nor Corebai)
https://gitlab.com/kicad/libraries/kicad-symbols/-/merge_requests/289
FX2 decoupling
RECOVER
Imax @ 3V3 = 3 mA
Release reset while shorting these pads if it ever stops enumerating
Addr: 1001000

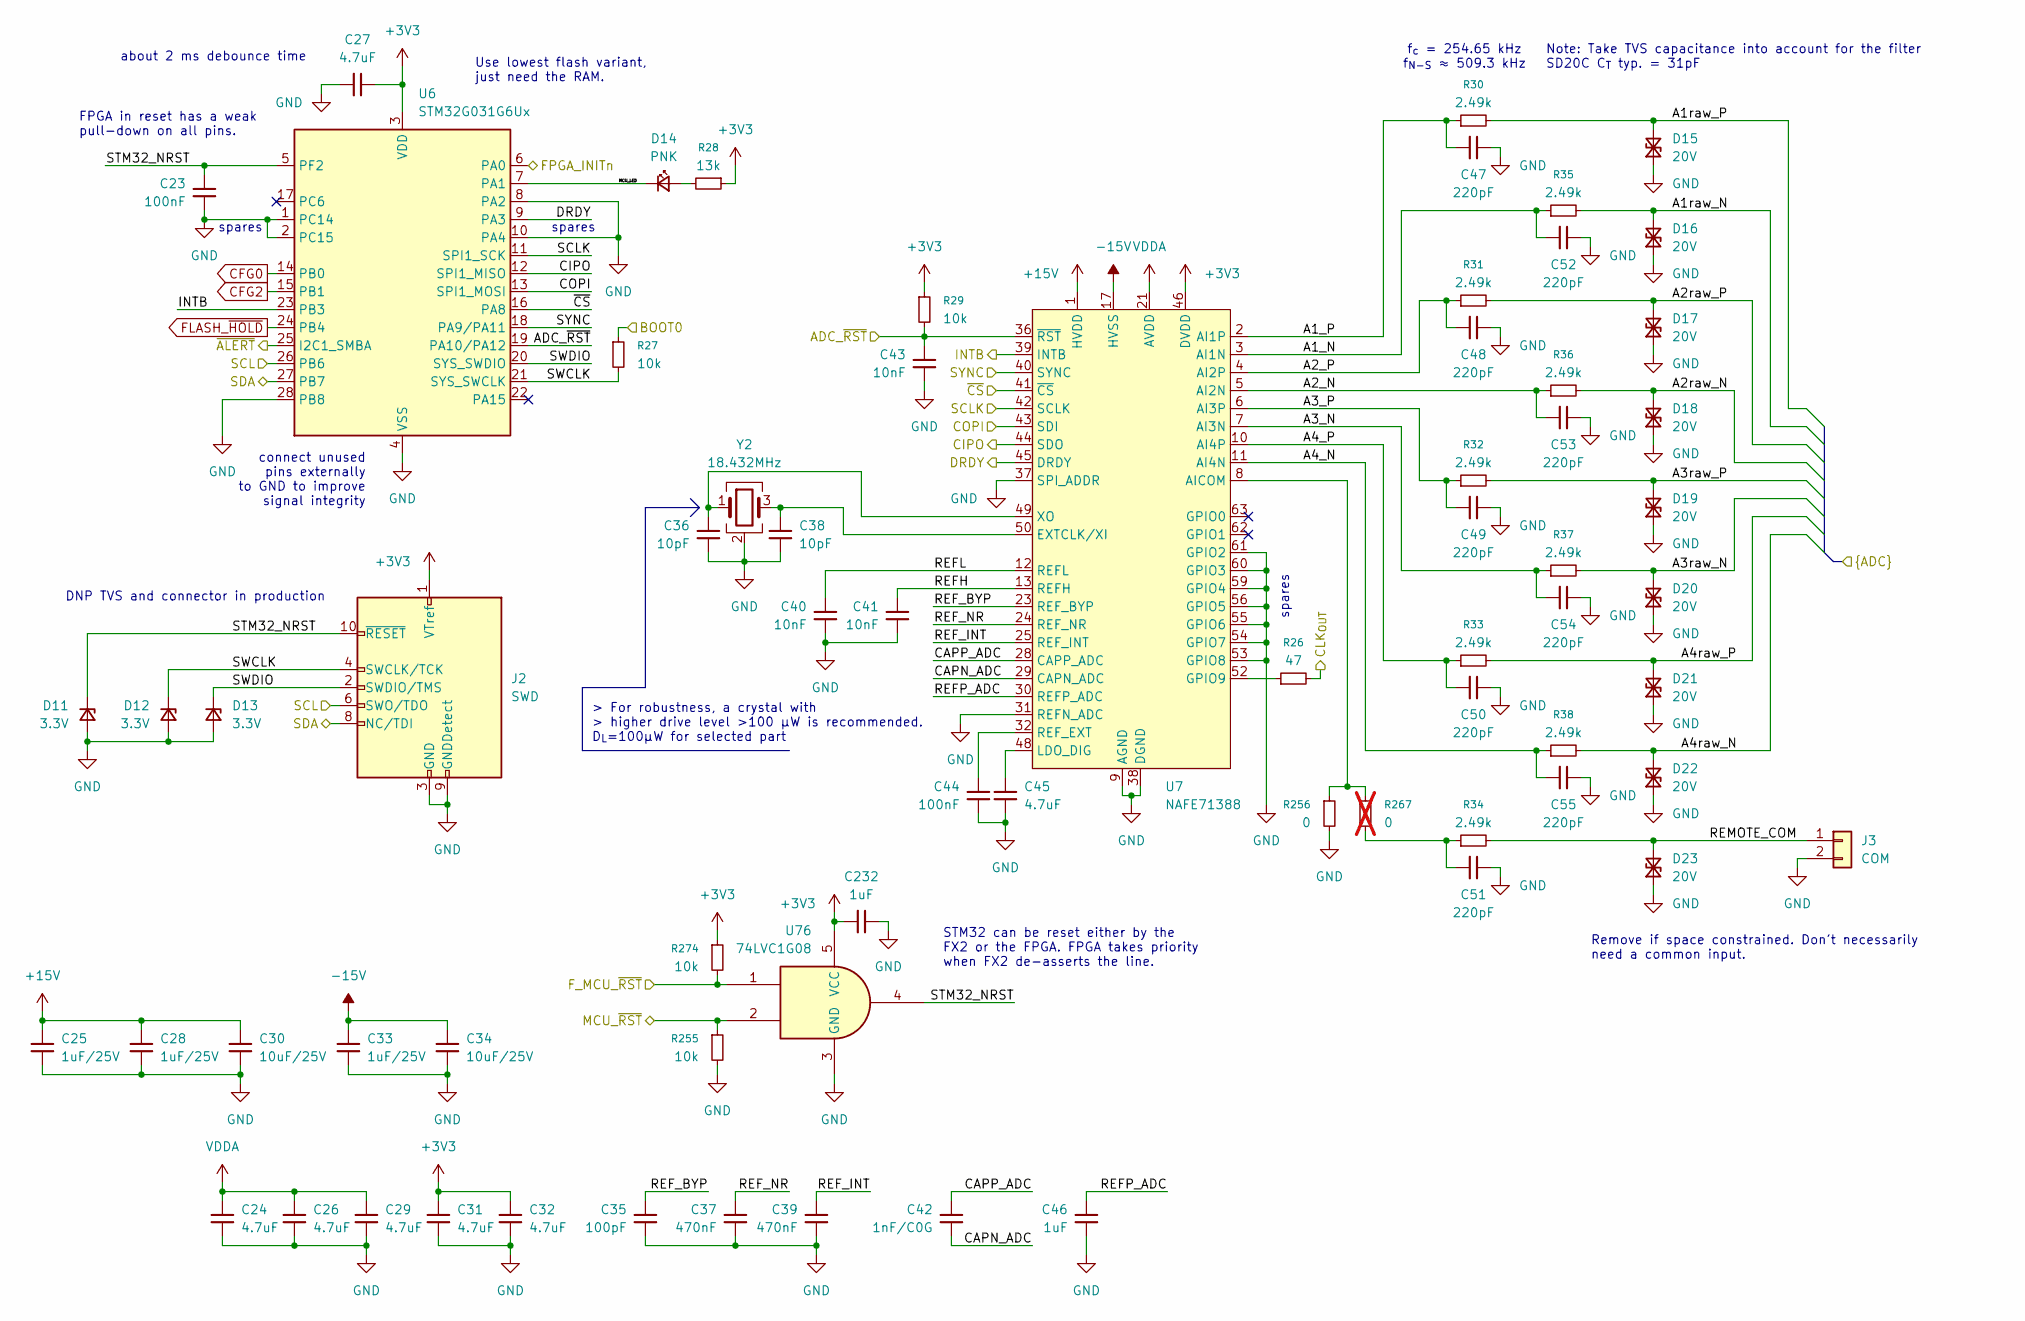
[picture p2: schematic adc.kicad_sch, NAFE ADC and protections]

Parts:
C23, C44: 100nF; C_0402_1005Metric; MPN CL05B104KB54PNC; LCSC C307331
C24, C26, C27, C29, C31, C32, C45: 4.7uF; C_0402_1005Metric; MPN CL05A475MP5NRNC; LCSC C23733
C25, C28, C33: 1uF/25V; C_0402_1005Metric; MPN CL05A105KA5NQNC; LCSC C52923
C30, C34: 10uF/25V; C_0603_1608Metric; MPN CL10A106MA8NRNC; LCSC C96446
C35: 100pF; C_0402_1005Metric; MPN 0402CG101J500NT; LCSC C1546
C36, C38: 10pF; C_0402_1005Metric; MPN CL05C100JB5NNNC; LCSC C32949
C37, C39: 470nF; C_0402_1005Metric; MPN GRM155R71C474KE01D; LCSC C471404
C40, C41, C43: 10nF; C_0402_1005Metric; MPN CL05B103KB5NNNC; LCSC C15195
C42: 1nF/C0G; C_0402_1005Metric; MPN GCM1555C1H102FA16D; LCSC C126493
C46, C232: 1uF; C_0402_1005Metric; MPN CL05A105KA5NQNC; LCSC C52923
C47, C48, C49, C50, C51, C52, C53, C54, C55: 220pF; C_0402_1005Metric; MPN GRM1555C2A221JE01D; LCSC C1518203
D11, D12, D13: 3.3V; D_0201_0603Metric; MPN TPD1E04U04DPLR-TP; LCSC C41408060
D14: PNK; LED_0603_1608Metric; MPN OSK40603C1E; LCSC C51933299
D15, D16, D17, D18, D19, D20, D21, D22, D23: 20V; D_SOD-323; MPN SD20C; LCSC C1977978
J2: SWD; PinHeader_2x05_P1.27mm_Vertical_SMD; MPN FTSH-105-01-L-DV-K-P; LCSC C2932107
J3: COM; PinHeader_1x02_P2.54mm_Vertical
R26: 47; R_0201_0603Metric; MPN 0201WMF470JTEE; LCSC C620443
R27, R29, R255, R274: 10k; R_0402_1005Metric; MPN 0402WGF1002TCE; LCSC C25744
R28: 13k; R_0402_1005Metric; MPN 0402WGF1302TCE; LCSC C25754
R30, R31, R32, R33, R34, R35, R36, R37, R38: 2.49k; R_MiniMELF_MMA-0204; MPN CSR0204FTDV2491; LCSC C316473
R256: 0; R_0402_1005Metric; MPN PE0402FRF470R05L; LCSC C851623
R267: 0; R_0402_1005Metric; MPN 0402WGF0000TCE; LCSC C17168; not fitted
U6: STM32G031G6Ux; QFN-28_4x4mm_P0.5mm; MPN STM32G031G6U6TR; LCSC C724053
U7: NAFE71388; VQFN-64-1EP_9x9mm_P0.5mm_EP7.15x7.15mm; MPN NAFE71388B40BS
U76: 74LVC1G08; SOT-553; MPN 74LVC1G08Z-7; LCSC C842517
Y2: 18.432MHz; Crystal_SMD_3225-4Pin_3.2x2.5mm; MPN TZ1572A; LCSC C501796

Connections:
+3V3: C27.2, C31.1, C32.1, C232.2, J2.1 (VTref), R28.1, R29.1, R274.1, U6.3 (VDD), U7.46 (DVDD), U7.57 (DVDD), U76.5 (VCC); also elsewhere on the board
+15V: C25.1, C28.1, C30.1, U7.1 (HVDD), U7.15 (HVDD); also elsewhere on the board
-15V: C33.1, C34.1, U7.17 (HVSS), U7.65 (EP); also elsewhere on the board
/ADC/A1_N: C52.1, R35.1, U7.3 (AI1N)
/ADC/A1_P: C47.1, R30.1, U7.2 (AI1P)
/ADC/A1raw_N: D16.2 (A2), R35.2; also elsewhere on the board
/ADC/A1raw_P: D15.2 (A2), R30.2; also elsewhere on the board
/ADC/A2_N: C53.1, R36.1, U7.5 (AI2N)
/ADC/A2_P: C48.1, R31.1, U7.4 (AI2P)
/ADC/A2raw_N: D18.2 (A2), R36.2; also elsewhere on the board
/ADC/A2raw_P: D17.2 (A2), R31.2; also elsewhere on the board
/ADC/A3_N: C54.1, R37.1, U7.7 (AI3N)
/ADC/A3_P: C49.1, R32.1, U7.6 (AI3P)
/ADC/A3raw_N: D20.2 (A2), R37.2; also elsewhere on the board
/ADC/A3raw_P: D19.2 (A2), R32.2; also elsewhere on the board
/ADC/A4_N: C55.1, R38.1, U7.11 (AI4N)
/ADC/A4_P: C50.1, R33.1, U7.10 (AI4P)
/ADC/A4raw_N: D22.2 (A2), R38.2; also elsewhere on the board
/ADC/A4raw_P: D21.2 (A2), R33.2; also elsewhere on the board
/ADC/ADC_~RST: C43.1, R29.2, U6.19 (PA10/PA12), U7.36 (~RST); also elsewhere on the board
/ADC/CAPN_ADC: C42.1, U7.29 (CAPN_ADC)
/ADC/CAPP_ADC: C42.2, U7.28 (CAPP_ADC)
/ADC/CIPO: U6.12 (SPI1_MISO), U7.44 (SDO); also elsewhere on the board
/ADC/COPI: U6.13 (SPI1_MOSI), U7.43 (SDI); also elsewhere on the board
/ADC/DRDY: U6.9 (PA3), U7.45 (DRDY); also elsewhere on the board
/ADC/INTB: U6.23 (PB3), U7.39 (INTB); also elsewhere on the board
/ADC/MCU_LED: D14.1 (K), U6.7 (PA1)
/ADC/REFH: C41.1, U7.13 (REFH)
/ADC/REFL: C40.1, U7.12 (REFL)
/ADC/REFP_ADC: C46.2, U7.30 (REFP_ADC)
/ADC/REF_BYP: C35.2, U7.23 (REF_BYP)
/ADC/REF_INT: C39.2, U7.25 (REF_INT)
/ADC/REF_NR: C37.2, U7.24 (REF_NR)
/ADC/REMOTE_COM: D23.2 (A2), J3.1, R34.2
/ADC/SCLK: U6.11 (SPI1_SCK), U7.42 (SCLK); also elsewhere on the board
/ADC/STM32_NRST: C23.1, D11.1 (K), J2.10 (~RESET), U6.5 (PF2), U76.4
/ADC/SWCLK: D12.1 (K), J2.4 (SWCLK/TCK), R27.2, U6.21 (SYS_SWCLK)
/ADC/SWDIO: D13.1 (K), J2.2 (SWDIO/TMS), U6.20 (SYS_SWDIO)
/ADC/SYNC: U6.18 (PA9/PA11), U7.40 (SYNC); also elsewhere on the board
/ADC/~CS: U6.16 (PA8), U7.41 (~CS); also elsewhere on the board
/BOOT0: R27.1; also elsewhere on the board
/FPGA_INITn: U6.6 (PA0); also elsewhere on the board
/F_MCU_~RST: R274.2, U76.1; also elsewhere on the board
/MCU_~RST: R255.1, U76.2; also elsewhere on the board
/NAFE_CLK_{OUT}: R26.2; also elsewhere on the board
/SCL: J2.6 (SWO/TDO), U6.26 (PB6); also elsewhere on the board
/SDA: J2.8 (NC/TDI), U6.27 (PB7); also elsewhere on the board
/~ALERT: U6.25 (I2C1_SMBA); also elsewhere on the board
CFG0: U6.14 (PB0); also elsewhere on the board
CFG2: U6.15 (PB1); also elsewhere on the board
FLASH_~HOLD: U6.24 (PB4); also elsewhere on the board
GND: C23.2, C24.2, C25.2, C26.2, C27.1, C28.2, C29.2, C30.2, C31.2, C32.2, C33.2, C34.2, C35.1, C36.2, C37.1, C38.2, C39.1, C40.2, C41.2, C43.2, C44.2, C45.2, C46.1, C47.2, C48.2, C49.2, C50.2, C51.2, C52.2, C53.2, C54.2, C55.2, C232.1, D11.2 (A), D12.2 (A), D13.2 (A), D15.1 (A1), D16.1 (A1), D17.1 (A1), D18.1 (A1), D19.1 (A1), D20.1 (A1), D21.1 (A1), D22.1 (A1), D23.1 (A1), J2.3 (GND), J2.5 (GND), J2.9 (GNDDetect), J3.2, R255.2, R256.2, U6.1 (PC14), U6.2 (PC15), U6.4 (VSS), U6.8 (PA2), U6.10 (PA4), U6.28 (PB8), U7.9 (AGND), U7.14 (AGND), U7.16 (AGND), U7.18 (AGND), U7.19 (AGND), U7.20 (AGND), U7.22 (AGND), U7.27 (AGND), U7.31 (REFN_ADC), U7.33 (AGND), U7.34 (AGND), U7.37 (SPI_ADDR), U7.38 (DGND), U7.47 (DGND), U7.51 (DGND), U7.53 (GPIO8), U7.54 (GPIO7), U7.55 (GPIO6), U7.56 (GPIO5), U7.58 (DGND), U7.59 (GPIO4), U7.60 (GPIO3), U7.61 (GPIO2), U7.64 (AGND), U76.3 (GND), Y2.2 (G), Y2.4 (G); also elsewhere on the board
unnamed: C51.1, R34.1, R267.2
unnamed: D14.2 (A), R28.2
unnamed: R256.1, R267.1, U7.8 (AICOM)
unnamed: C38.1, U7.50 (EXTCLK/XI), Y2.3
unnamed: R26.1, U7.52 (GPIO9)
unnamed: C45.1, U7.48 (LDO_DIG)
unnamed: C44.1, U7.32 (REF_EXT)
unnamed: C36.1, U7.49 (XO), Y2.1
VDDA: C24.1, C26.1, C29.1, U7.21 (AVDD), U7.26 (AVDD), U7.35 (AVDD); also elsewhere on the board

Notes on the sheet:
spares
Note: Take TVS capacitance into account for the filter SD20C C_{T} typ. = 31pF
Use lowest flash variant, just need the RAM.
connect unused pins externally to GND to improve signal integrity
Remove if space constrained. Don't necessarily need a common input.
FPGA in reset has a weak pull-down on all pins.
> For robustness, a crystal with > higher drive level >100 μW is recommended. D_{L}=100µW for selected part
DNP TVS and connector in production
f_{c} = 254.65 kHz f_{N-S} ≈ 509.3 kHz
STM32 can be reset either by the FX2 or the FPGA. FPGA takes priority when FX2 de-asserts the line.
about 2 ms debounce time

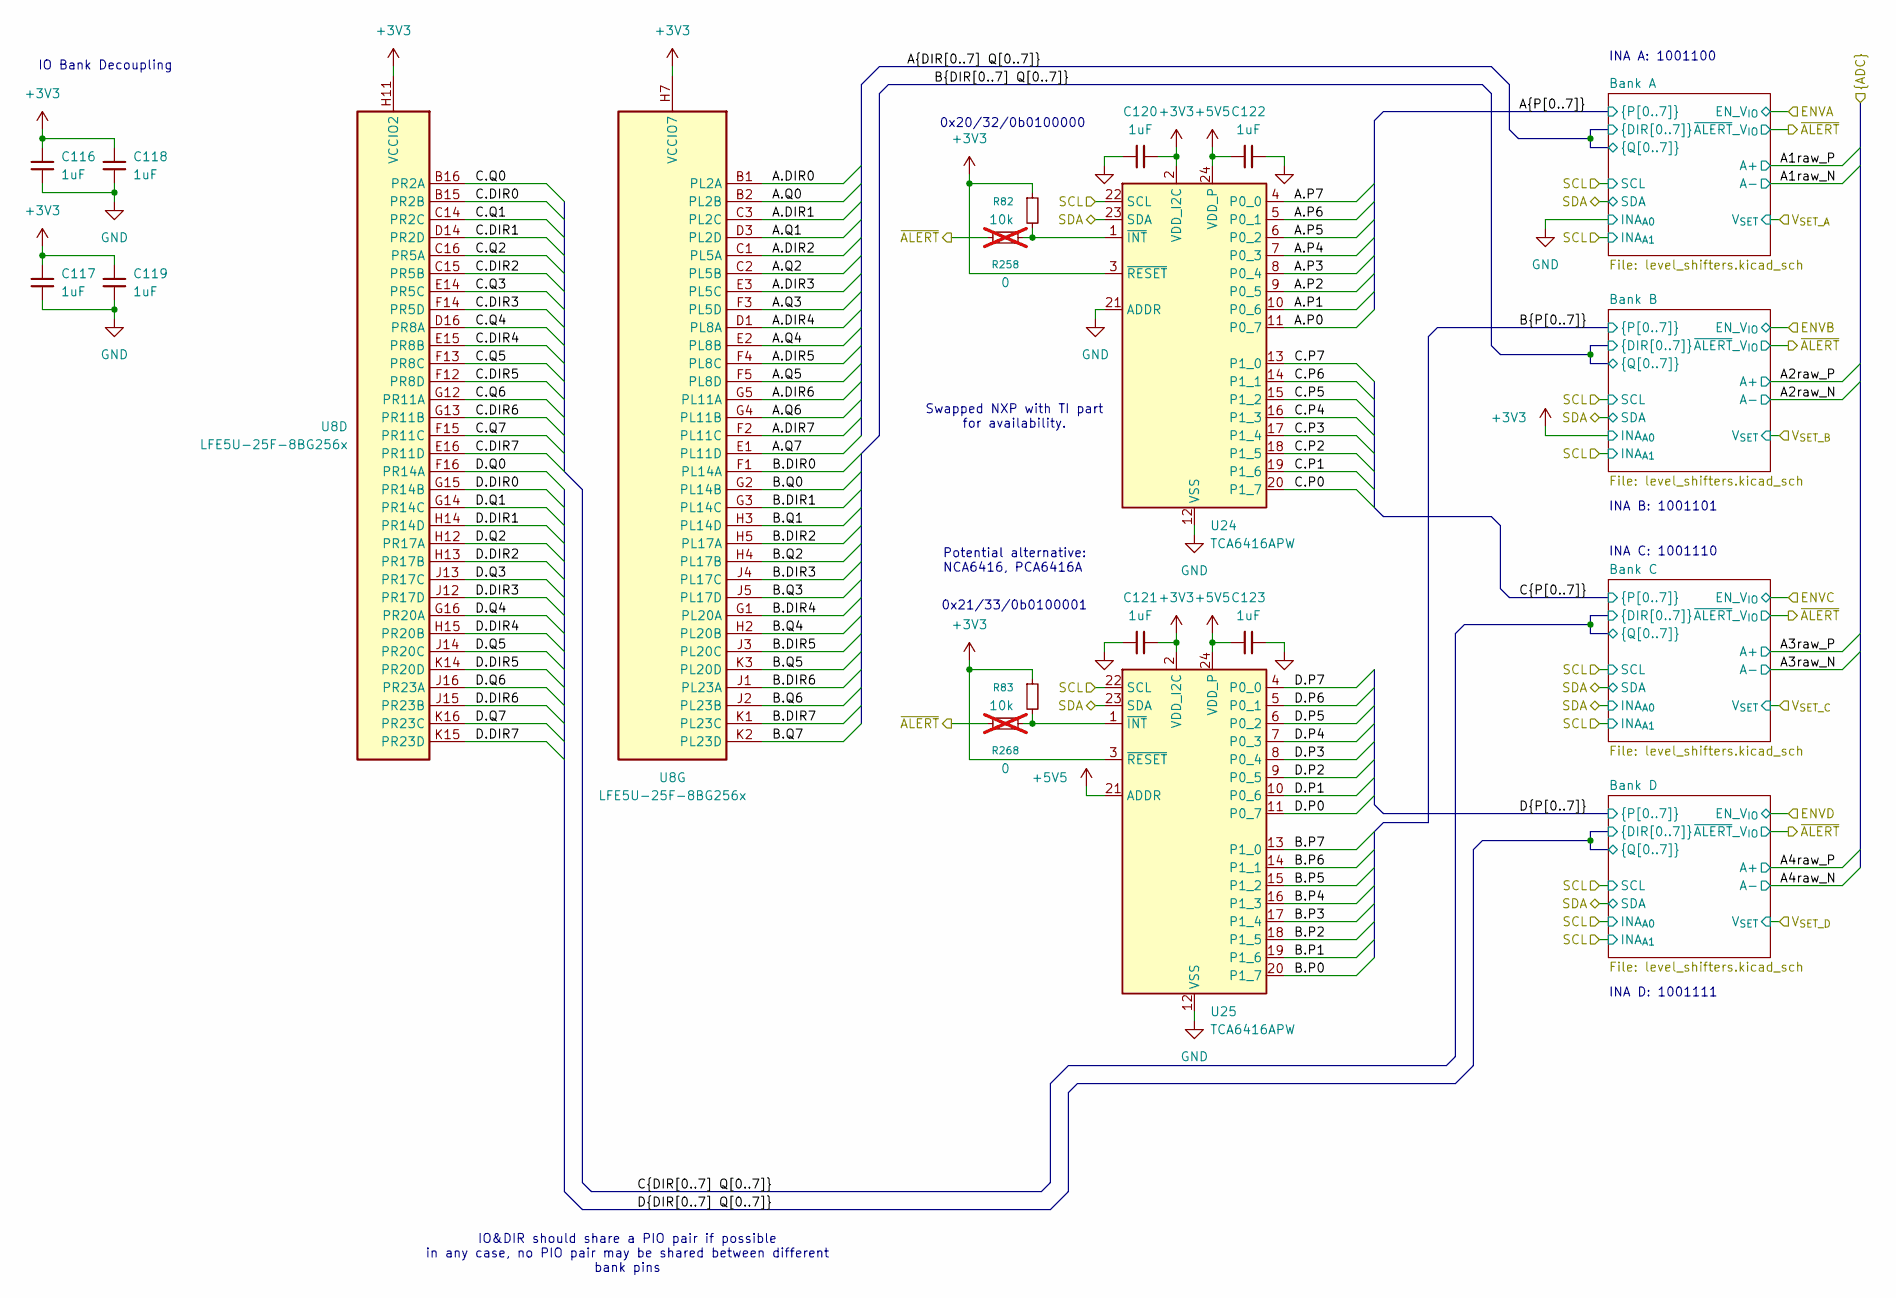
[picture p3: schematic io_buffer.kicad_sch, FPGA - IO Banks & Port Expander]

Parts:
C116, C117, C118, C119: 1uF; C_0201_0603Metric; MPN CL03A105MO3NRNH; LCSC C307385
C120, C121, C122, C123: 1uF; C_0402_1005Metric; MPN CL05A105KA5NQNC; LCSC C52923
R82, R83: 10k; R_0402_1005Metric; MPN 0402WGF1002TCE; LCSC C25744
R258, R268: 0; R_0402_1005Metric; MPN 0402WGF0000TCE; LCSC C17168; not fitted
U8: LFE5U-25F-8BG256x; BGA-256_14.0x14.0mm_Layout16x16_P0.8mm_Ball0.45mm_Pad0.32mm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; MPN LFE5U-25F-6BG256C; LCSC C1521614
U24, U25: TCA6416APW; TSSOP-24_4.4x7.8mm_P0.65mm; MPN TCA6416APWR; LCSC C130203

Connections:
+3V3: C116.1, C117.1, C118.1, C119.1, C120.1, C121.1, R82.1, R83.1, U8.H6 (VCCIO7), U8.H7 (VCCIO7), U8.H11 (VCCIO2), U8.J11 (VCCIO2), U24.2 (VDD_I2C), U24.3 (~RESET), U25.2 (VDD_I2C), U25.3 (~RESET); also elsewhere on the board
+5V5: C122.1, C123.1, U24.24 (VDD_P), U25.21 (ADDR), U25.24 (VDD_P); also elsewhere on the board
/IO Banks/A.DIR0: U8.B1 (PL2A); also elsewhere on the board
/IO Banks/A.DIR1: U8.C3 (PL2C); also elsewhere on the board
/IO Banks/A.DIR2: U8.C1 (PL5A); also elsewhere on the board
/IO Banks/A.DIR3: U8.E3 (PL5C); also elsewhere on the board
/IO Banks/A.DIR4: U8.D1 (PL8A); also elsewhere on the board
/IO Banks/A.DIR5: U8.F4 (PL8C); also elsewhere on the board
/IO Banks/A.DIR6: U8.G5 (PL11A); also elsewhere on the board
/IO Banks/A.DIR7: U8.F2 (PL11C); also elsewhere on the board
/IO Banks/A.P0: U24.11 (P0_7); also elsewhere on the board
/IO Banks/A.P1: U24.10 (P0_6); also elsewhere on the board
/IO Banks/A.P2: U24.9 (P0_5); also elsewhere on the board
/IO Banks/A.P3: U24.8 (P0_4); also elsewhere on the board
/IO Banks/A.P4: U24.7 (P0_3); also elsewhere on the board
/IO Banks/A.P5: U24.6 (P0_2); also elsewhere on the board
/IO Banks/A.P6: U24.5 (P0_1); also elsewhere on the board
/IO Banks/A.P7: U24.4 (P0_0); also elsewhere on the board
/IO Banks/A.Q0: U8.B2 (PL2B); also elsewhere on the board
/IO Banks/A.Q1: U8.D3 (PL2D); also elsewhere on the board
/IO Banks/A.Q2: U8.C2 (PL5B); also elsewhere on the board
/IO Banks/A.Q3: U8.F3 (PL5D); also elsewhere on the board
/IO Banks/A.Q4: U8.E2 (PL8B); also elsewhere on the board
/IO Banks/A.Q5: U8.F5 (PL8D); also elsewhere on the board
/IO Banks/A.Q6: U8.G4 (PL11B); also elsewhere on the board
/IO Banks/A.Q7: U8.E1 (PL11D); also elsewhere on the board
/IO Banks/B.DIR0: U8.F1 (PL14A); also elsewhere on the board
/IO Banks/B.DIR1: U8.G3 (PL14C); also elsewhere on the board
/IO Banks/B.DIR2: U8.H5 (PL17A); also elsewhere on the board
/IO Banks/B.DIR3: U8.J4 (PL17C); also elsewhere on the board
/IO Banks/B.DIR4: U8.G1 (PL20A); also elsewhere on the board
/IO Banks/B.DIR5: U8.J3 (PL20C); also elsewhere on the board
/IO Banks/B.DIR6: U8.J1 (PL23A); also elsewhere on the board
/IO Banks/B.DIR7: U8.K1 (PL23C); also elsewhere on the board
/IO Banks/B.P0: U25.20 (P1_7); also elsewhere on the board
/IO Banks/B.P1: U25.19 (P1_6); also elsewhere on the board
/IO Banks/B.P2: U25.18 (P1_5); also elsewhere on the board
/IO Banks/B.P3: U25.17 (P1_4); also elsewhere on the board
/IO Banks/B.P4: U25.16 (P1_3); also elsewhere on the board
/IO Banks/B.P5: U25.15 (P1_2); also elsewhere on the board
/IO Banks/B.P6: U25.14 (P1_1); also elsewhere on the board
/IO Banks/B.P7: U25.13 (P1_0); also elsewhere on the board
/IO Banks/B.Q0: U8.G2 (PL14B); also elsewhere on the board
/IO Banks/B.Q1: U8.H3 (PL14D); also elsewhere on the board
/IO Banks/B.Q2: U8.H4 (PL17B); also elsewhere on the board
/IO Banks/B.Q3: U8.J5 (PL17D); also elsewhere on the board
/IO Banks/B.Q4: U8.H2 (PL20B); also elsewhere on the board
/IO Banks/B.Q5: U8.K3 (PL20D); also elsewhere on the board
/IO Banks/B.Q6: U8.J2 (PL23B); also elsewhere on the board
/IO Banks/B.Q7: U8.K2 (PL23D); also elsewhere on the board
/IO Banks/C.DIR0: U8.B15 (PR2B); also elsewhere on the board
/IO Banks/C.DIR1: U8.D14 (PR2D); also elsewhere on the board
/IO Banks/C.DIR2: U8.C15 (PR5B); also elsewhere on the board
/IO Banks/C.DIR3: U8.F14 (PR5D); also elsewhere on the board
/IO Banks/C.DIR4: U8.E15 (PR8B); also elsewhere on the board
/IO Banks/C.DIR5: U8.F12 (PR8D); also elsewhere on the board
/IO Banks/C.DIR6: U8.G13 (PR11B); also elsewhere on the board
/IO Banks/C.DIR7: U8.E16 (PR11D); also elsewhere on the board
/IO Banks/C.P0: U24.20 (P1_7); also elsewhere on the board
/IO Banks/C.P1: U24.19 (P1_6); also elsewhere on the board
/IO Banks/C.P2: U24.18 (P1_5); also elsewhere on the board
/IO Banks/C.P3: U24.17 (P1_4); also elsewhere on the board
/IO Banks/C.P4: U24.16 (P1_3); also elsewhere on the board
/IO Banks/C.P5: U24.15 (P1_2); also elsewhere on the board
/IO Banks/C.P6: U24.14 (P1_1); also elsewhere on the board
/IO Banks/C.P7: U24.13 (P1_0); also elsewhere on the board
/IO Banks/C.Q0: U8.B16 (PR2A); also elsewhere on the board
/IO Banks/C.Q1: U8.C14 (PR2C); also elsewhere on the board
/IO Banks/C.Q2: U8.C16 (PR5A); also elsewhere on the board
/IO Banks/C.Q3: U8.E14 (PR5C); also elsewhere on the board
/IO Banks/C.Q4: U8.D16 (PR8A); also elsewhere on the board
/IO Banks/C.Q5: U8.F13 (PR8C); also elsewhere on the board
/IO Banks/C.Q6: U8.G12 (PR11A); also elsewhere on the board
/IO Banks/C.Q7: U8.F15 (PR11C); also elsewhere on the board
/IO Banks/D.DIR0: U8.G15 (PR14B); also elsewhere on the board
/IO Banks/D.DIR1: U8.H14 (PR14D); also elsewhere on the board
/IO Banks/D.DIR2: U8.H13 (PR17B); also elsewhere on the board
/IO Banks/D.DIR3: U8.J12 (PR17D); also elsewhere on the board
/IO Banks/D.DIR4: U8.H15 (PR20B); also elsewhere on the board
/IO Banks/D.DIR5: U8.K14 (PR20D); also elsewhere on the board
/IO Banks/D.DIR6: U8.J15 (PR23B); also elsewhere on the board
/IO Banks/D.DIR7: U8.K15 (PR23D); also elsewhere on the board
/IO Banks/D.P0: U25.11 (P0_7); also elsewhere on the board
/IO Banks/D.P1: U25.10 (P0_6); also elsewhere on the board
/IO Banks/D.P2: U25.9 (P0_5); also elsewhere on the board
/IO Banks/D.P3: U25.8 (P0_4); also elsewhere on the board
/IO Banks/D.P4: U25.7 (P0_3); also elsewhere on the board
/IO Banks/D.P5: U25.6 (P0_2); also elsewhere on the board
/IO Banks/D.P6: U25.5 (P0_1); also elsewhere on the board
/IO Banks/D.P7: U25.4 (P0_0); also elsewhere on the board
/IO Banks/D.Q0: U8.F16 (PR14A); also elsewhere on the board
/IO Banks/D.Q1: U8.G14 (PR14C); also elsewhere on the board
/IO Banks/D.Q2: U8.H12 (PR17A); also elsewhere on the board
/IO Banks/D.Q3: U8.J13 (PR17C); also elsewhere on the board
/IO Banks/D.Q4: U8.G16 (PR20A); also elsewhere on the board
/IO Banks/D.Q5: U8.J14 (PR20C); also elsewhere on the board
/IO Banks/D.Q6: U8.J16 (PR23A); also elsewhere on the board
/IO Banks/D.Q7: U8.K16 (PR23C); also elsewhere on the board
/SCL: U24.22 (SCL), U25.22 (SCL); also elsewhere on the board
/SDA: U24.23 (SDA), U25.23 (SDA); also elsewhere on the board
/~ALERT: R258.1, R268.2; also elsewhere on the board
GND: C116.2, C117.2, C118.2, C119.2, C120.2, C121.2, C122.2, C123.2, U24.12 (VSS), U24.21 (ADDR), U25.12 (VSS); also elsewhere on the board
unnamed: R82.2, R258.2, U24.1 (~INT)
unnamed: R83.2, R268.1, U25.1 (~INT)

Notes on the sheet:
0x21/33/0b0100001
INA A: 1001100
INA B: 1001101
IO Bank Decoupling
Potential alternative: NCA6416, PCA6416A
Swapped NXP with TI part for availability.
INA D: 1001111
INA C: 1001110
IO&DIR should share a PIO pair if possible in any case, no PIO pair may be shared between different bank pins
0x20/32/0b0100000
