tachiniererin/glasgow/hardware/boards/glasgow/revD1/glasgow.kicad_pcb

## KiCad design hardware/boards/glasgow/revD1/glasgow.kicad_pcb (continued)

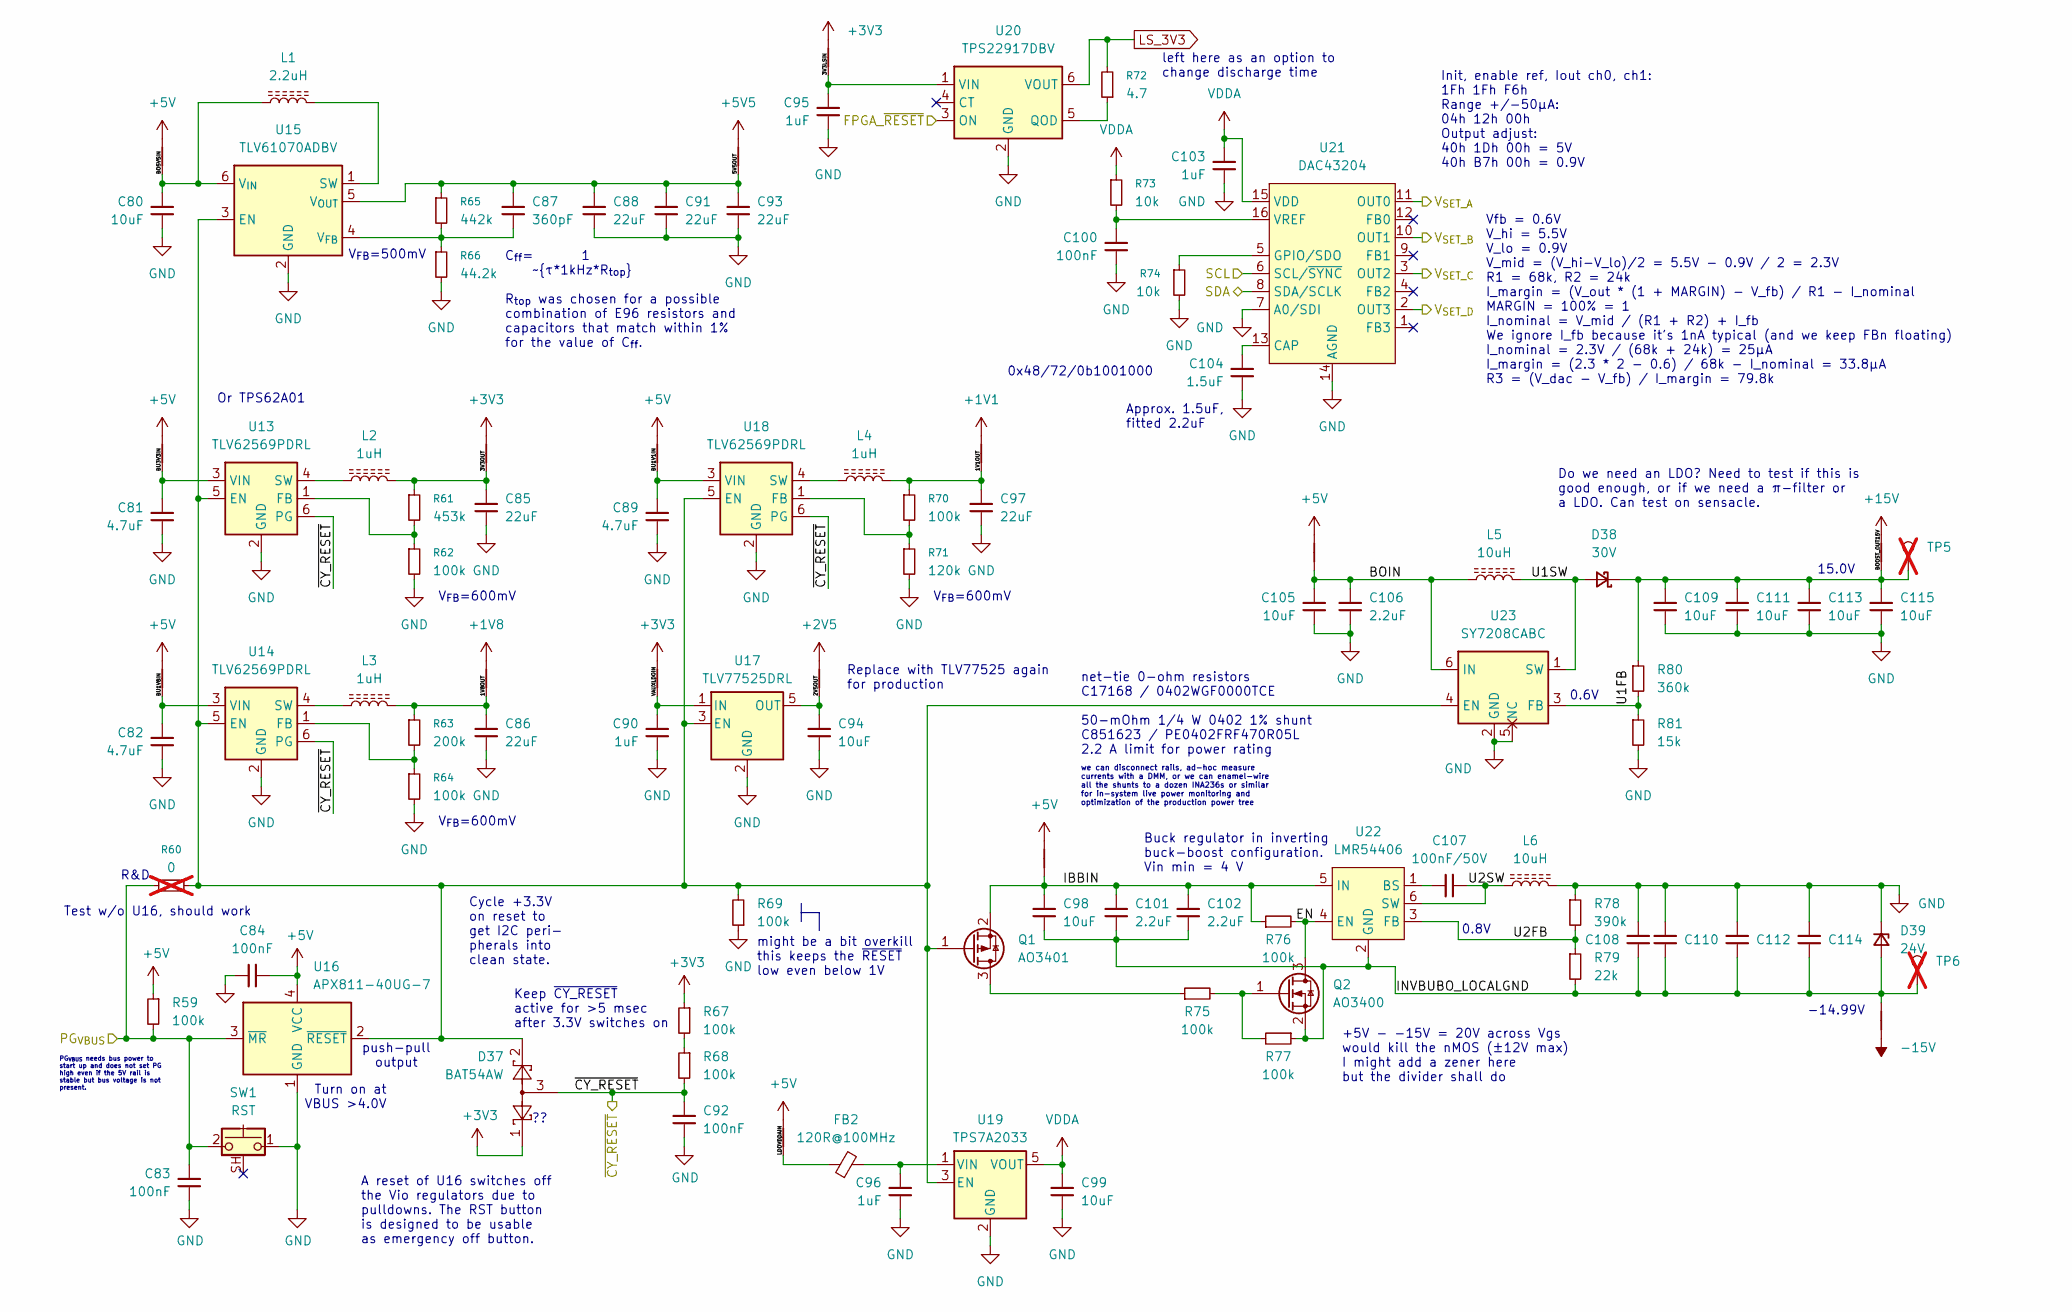
[picture p4: schematic power.kicad_sch, Power Supplies]

Parts:
C80: 10uF; C_0805_2012Metric; MPN CL21A106KAYNNNE; LCSC C15850
C81, C82, C89: 4.7uF; C_0603_1608Metric; MPN GRM188Z71C475KE21D; LCSC C389010
C83, C84, C92, C100: 100nF; C_0402_1005Metric; MPN CL05B104KB54PNC; LCSC C307331
C85, C86, C88, C91, C93, C97: 22uF; C_0805_2012Metric; MPN CL21A226MAQNNNE; LCSC C45783
C87: 360pF; C_0402_1005Metric; MPN 0402B361K500NT; LCSC C2939813
C90, C95, C96, C103: 1uF; C_0402_1005Metric; MPN CL05A105KA5NQNC; LCSC C52923
C94, C99: 10uF; C_0402_1005Metric; MPN CL05A106MQ5NUNC; LCSC C15525
C98, C105, C109, C111, C113, C115: 10uF; C_0603_1608Metric; MPN CGA0603X5R106M350JT; LCSC C6119878
C101, C102, C106: 2.2uF; C_0402_1005Metric; MPN GRM155R61E225KE11D; LCSC C385032
C104: 1.5uF; C_0402_1005Metric; MPN GRM155R61E225KE11D; LCSC C385032
C107: 100nF/50V; C_0402_1005Metric; MPN CL05B104KB54PNC; LCSC C307331
C108, C110, C112, C114: 10uF/35V; C_0603_1608Metric; MPN CGA0603X5R106M350JT; LCSC C6119878
D37: BAT54AW; SOT-323_SC-70; MPN BAT54AW-7-F; LCSC C18207544
D38: 30V; D_SOD-123HE; MPN SBA330AH; LCSC C313468
D39: 24V; D_SOD-123; MPN MM1Z24; LCSC C22379465
FB2: 120R@100MHz; L_0603_1608Metric; MPN BLM18PG121SN1D; LCSC C14709
L1: 2.2uH; L_Changjiang_FTC201612S; MPN FTC201612S2R2MBCA; LCSC C18724414
L2, L3, L4: 1uH; L_Changjiang_FTC201612S; MPN FTC201612S1R0MBCA; LCSC C18724413
L5, L6: 10uH; L_Changjiang_FTC201212S; MPN FTC201212S100MBCA; LCSC C53436344
NT2, NT3, NT4, NT5, NT6, NT7, NT8, NT9, NT10, NT11, NT12, NT13, NT14, NT15, NT16, NT17: 0; R_0402_1005Metric; MPN PE0402FRF470R05L; LCSC C851623
Q1: AO3401; SOT-23; MPN AO3401A; LCSC C15127
Q2: AO3400; SOT-23; MPN AO3400A; LCSC C20917
R59, R62, R64, R67, R68, R69, R70, R75, R76, R77: 100k; R_0402_1005Metric; MPN 0402WGF1003TCE; LCSC C25741
R60: 0; R_0402_1005Metric; MPN 0402WGF0000TCE; LCSC C17168; not fitted
R61: 453k; R_0402_1005Metric; MPN 0402WGF4533TCE; LCSC C27009
R63: 200k; R_0402_1005Metric; MPN 0402WGF2003TCE; LCSC C25764
R65: 442k; R_0402_1005Metric; MPN 0402WGF4423TCE; LCSC C5101
R66: 44.2k; R_0402_1005Metric; MPN 0402WGF4422TCE; LCSC C25895
R71: 120k; R_0402_1005Metric; MPN 0402WGF1203TCE; LCSC C25750
R72: 4.7; R_0402_1005Metric; MPN 0402WGJ047JTCE; LCSC C25169
R73, R74: 10k; R_0402_1005Metric; MPN 0402WGF1002TCE; LCSC C25744
R78: 390k; R_0402_1005Metric; MPN FRC0402F3903TS; LCSC C2909352
R79: 22k; R_0402_1005Metric; MPN 0402WGF2202TCE; LCSC C25768
R80: 360k; R_0402_1005Metric; MPN CLT0402D360KQ105; LCSC C5250845
R81: 15k; R_0402_1005Metric; MPN 0402WGF1502TCE; LCSC C25756
SW1: RST; SW_Tactile_SPST_Angled_TC-1109DE; MPN TC-1109DE-B-F; LCSC C400325
TP5: +15V; TestPoint_Pad_D1.0mm; not fitted
TP6: -15V; TestPoint_Pad_D1.0mm; not fitted
U13, U14, U18: TLV62569PDRL; SOT-563; MPN TLV62569PDRLR; LCSC C398364
U15: TLV61070ADBV; SOT-23-6; MPN TLV61070ADBVR; LCSC C6881375
U16: APX811-40UG-7; SOT-143; MPN APX811-40UG-7; LCSC C155533
U17: TLV77525DRL; SOT-23-5; MPN SPX3819M5-L-2-5; LCSC C23380893
U19: TPS7A2033; SOT-23-5; MPN TPS7A2033PDBVR; LCSC C2862740
U20: TPS22917DBV; SOT-23-6; MPN TPS22917DBVR; LCSC C2681320
U21: DAC43204; WQFN-16-1EP_3x3mm_P0.5mm_EP1.68x1.68mm; MPN DAC43204RTER; LCSC C5215475
U22: LMR54406; SOT-23-6; MPN LMR54406DBVR; LCSC C5219316
U23: SY7208CABC; SOT-23-6; MPN SY7208CABC; LCSC C178234

Connections:
+1V1: NT13.2; also elsewhere on the board
+1V8: NT6.2; also elsewhere on the board
+2V5: NT11.2; also elsewhere on the board
+3V3: D37.1, NT5.2, NT8.2, NT12.2, R67.1; also elsewhere on the board
+5V: C84.2, NT2.2, NT3.2, NT4.2, NT7.2, NT10.2, NT14.2, NT15.2, R59.1, U16.4 (VCC); also elsewhere on the board
+5V5: NT9.2; also elsewhere on the board
+15V: NT16.2; also elsewhere on the board
-15V: NT17.1; also elsewhere on the board
/FPGA_~RESET: U20.3 (ON); also elsewhere on the board
/IO Banks/V_{SET_A}: U21.11 (OUT0); also elsewhere on the board
/IO Banks/V_{SET_B}: U21.10 (OUT1); also elsewhere on the board
/IO Banks/V_{SET_C}: U21.3 (OUT2); also elsewhere on the board
/IO Banks/V_{SET_D}: U21.2 (OUT3); also elsewhere on the board
/PG_{VBUS}: C83.1, R59.2, R60.1, SW1.2, U16.3 (~MR); also elsewhere on the board
/Power/1V1OUT: C97.1, L4.2, NT13.1, R70.1
/Power/1V8OUT: C86.1, L3.2, NT6.1, R63.1
/Power/2V5OUT: C94.1, NT11.1, U17.5 (OUT)
/Power/3V3LSIN: C95.1, NT12.1, U20.1 (VIN)
/Power/3V3OUT: C85.1, L2.2, NT5.1, R61.1
/Power/5V5OUT: C87.1, C88.1, C91.1, C93.1, NT9.1, R65.1, U15.5 (V_{OUT})
/Power/BO5V5IN: C80.1, L1.1, NT2.1, U15.6 (V_{IN})
/Power/BOIN: C105.1, C106.1, L5.1, NT15.1, U23.6 (IN)
/Power/BOOST_OUT15V: C109.1, C111.1, C113.1, C115.1, D38.1 (K), NT16.1, R80.1, TP5.1 (1_1)
/Power/BU1V1IN: C89.1, NT7.1, U18.3 (VIN)
/Power/BU1V8IN: C82.1, NT4.1, U14.3 (VIN)
/Power/BU3V3IN: C81.1, NT3.1, U13.3 (VIN)
/Power/EN: Q2.3 (D), R76.2, U22.4 (EN)
/Power/IBBIN: C98.1, C101.1, C102.1, NT14.1, Q1.2 (S), R76.1, U22.5 (IN)
/Power/INVBUBO_LOCALGND: C98.2, C101.2, C102.2, C108.2, C110.2, C112.2, C114.2, D39.2 (A), NT17.2, Q2.2 (S), R77.1, R79.2, TP6.1 (1_1), U22.2 (GND)
/Power/LDOVDDAIN: FB2.1, NT10.1
/Power/U1FB: R80.2, R81.1, U23.3 (FB)
/Power/U1SW: D38.2 (A), L5.2, U23.1 (SW)
/Power/U2FB: R78.2, R79.1, U22.3 (FB)
/Power/U2SW: C107.2, L6.1, U22.6 (SW)
/Power/VAUXLDOIN: C90.1, NT8.1, U17.1 (IN)
/SCL: U21.6 (SCL/~SYNC); also elsewhere on the board
/SDA: U21.8 (SDA/SCLK); also elsewhere on the board
/~CY_RESET: C92.1, D37.3, R68.2, U13.6 (PG), U14.6 (PG), U18.6 (PG); also elsewhere on the board
GND: C80.2, C81.2, C82.2, C83.2, C84.1, C85.2, C86.2, C88.2, C89.2, C90.2, C91.2, C92.2, C93.2, C94.2, C95.2, C96.2, C97.2, C99.2, C100.1, C103.2, C104.2, C105.2, C106.2, C108.1, C109.2, C110.1, C111.2, C112.1, C113.2, C114.1, C115.2, D39.1 (K), L6.2, R62.2, R64.2, R66.2, R69.1, R71.2, R74.2, R78.1, R81.2, SW1.1, U13.2 (GND), U14.2 (GND), U15.2 (GND), U16.1 (GND), U17.2 (GND), U18.2 (GND), U19.2 (GND), U20.2 (GND), U21.7 (A0/SDI), U21.14 (AGND), U21.17 (AGND), U23.2 (GND), U23.5 (NC); also elsewhere on the board
LS_3V3: R72.2, U20.6 (VOUT); also elsewhere on the board
unnamed: Q1.3 (D), R75.1
unnamed: D37.2, Q1.1 (G), R60.2, R69.2, U13.5 (EN), U14.5 (EN), U15.3 (EN), U16.2 (~RESET), U17.3 (EN), U18.5 (EN), U19.3 (EN), U23.4 (EN)
unnamed: Q2.1 (G), R75.2, R77.2
unnamed: R67.2, R68.1
unnamed: R61.2, R62.1, U13.1 (FB)
unnamed: L2.1, U13.4 (SW)
unnamed: R63.2, R64.1, U14.1 (FB)
unnamed: L3.1, U14.4 (SW)
unnamed: L1.2, U15.1 (SW)
unnamed: C87.2, R65.2, R66.1, U15.4 (V_{FB})
unnamed: R70.2, R71.1, U18.1 (FB)
unnamed: L4.1, U18.4 (SW)
unnamed: C96.1, FB2.2, U19.1 (VIN)
unnamed: R72.1, U20.5 (QOD)
unnamed: C104.1, U21.13 (CAP)
unnamed: R74.1, U21.5 (GPIO/SDO)
unnamed: C100.2, R73.2, U21.16 (VREF)
unnamed: C107.1, U22.1 (BS)
VDDA: C99.1, C103.1, R73.1, U19.5 (VOUT), U21.15 (VDD); also elsewhere on the board

Notes on the sheet:
Cycle +3.3V on reset to get I2C peri- pherals into clean state.
Vfb = 0.6V V_hi = 5.5V V_lo = 0.9V V_mid = (V_hi-V_lo)/2 = 5.5V - 0.9V / 2 = 2.3V R1 = 68k, R2 = 24k I_margin = (V_out * (1 + MARGIN) - V_fb) / R1 - I_nominal MARGIN = 100% = 1 I_nominal = V_mid / (R1 + R2) + I_fb We ignore I_fb because it's 1nA typical (and we keep FBn floating) I_nominal = 2.3V /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
might be a bit overkill this keeps the ~{RESET} low even below 1V
Or TPS62A01
V_{FB}=600mV
PG_{VBUS} needs bus power to start up and does not set PG high even if the 5V rail is stable but bus voltage is not present.
Test w/o U16, should work
0.6V
Do we need an LDO? Need to test if this is good enough, or if we need a π-filter or a LDO. Can test on sensacle.
net-tie 0-ohm resistors C17168 / 0402WGF0000TCE 50-mOhm 1/4 W 0402 1% shunt C851623 / PE0402FRF470R05L 2.2 A limit for power rating
-14.99V
Buck regulator in inverting buck-boost configuration. Vin min = 4 V
left here as an option to change discharge time
Keep ~{CY_RESET} active for >5 msec after 3.3V switches on
0.8V
C_{ff}= 1 ~{τ*1kHz*R_{top}} R_{top} was chosen for a possible combination of E96 resistors and capacitors that match within 1% for the value of C_{ff}.
push-pull output
+5V - -15V = 20V across Vgs would kill the nMOS (±12V max) I might add a zener here but the divider shall do
A reset of U16 switches off the Vio regulators due to pulldowns. The RST button is designed to be usable as emergency off button.
15.0V
we can disconnect rails, ad-hoc measure currents with a DMM, or we can enamel-wire all the shunts to a dozen INA236s or similar for in-system live power monitoring and optimization of the production power tree
Approx. 1.5uF, fitted 2.2uF
R&D
V_{FB}=500mV
Turn on at VBUS >4.0V
Init, enable ref, Iout ch0, ch1: 1Fh 1Fh F6h Range +/-50µA: 04h 12h 00h Output adjust: 40h 1Dh 00h = 5V 40h B7h 00h = 0.9V
Replace with TLV77525 again for production
0x48/72/0b1001000

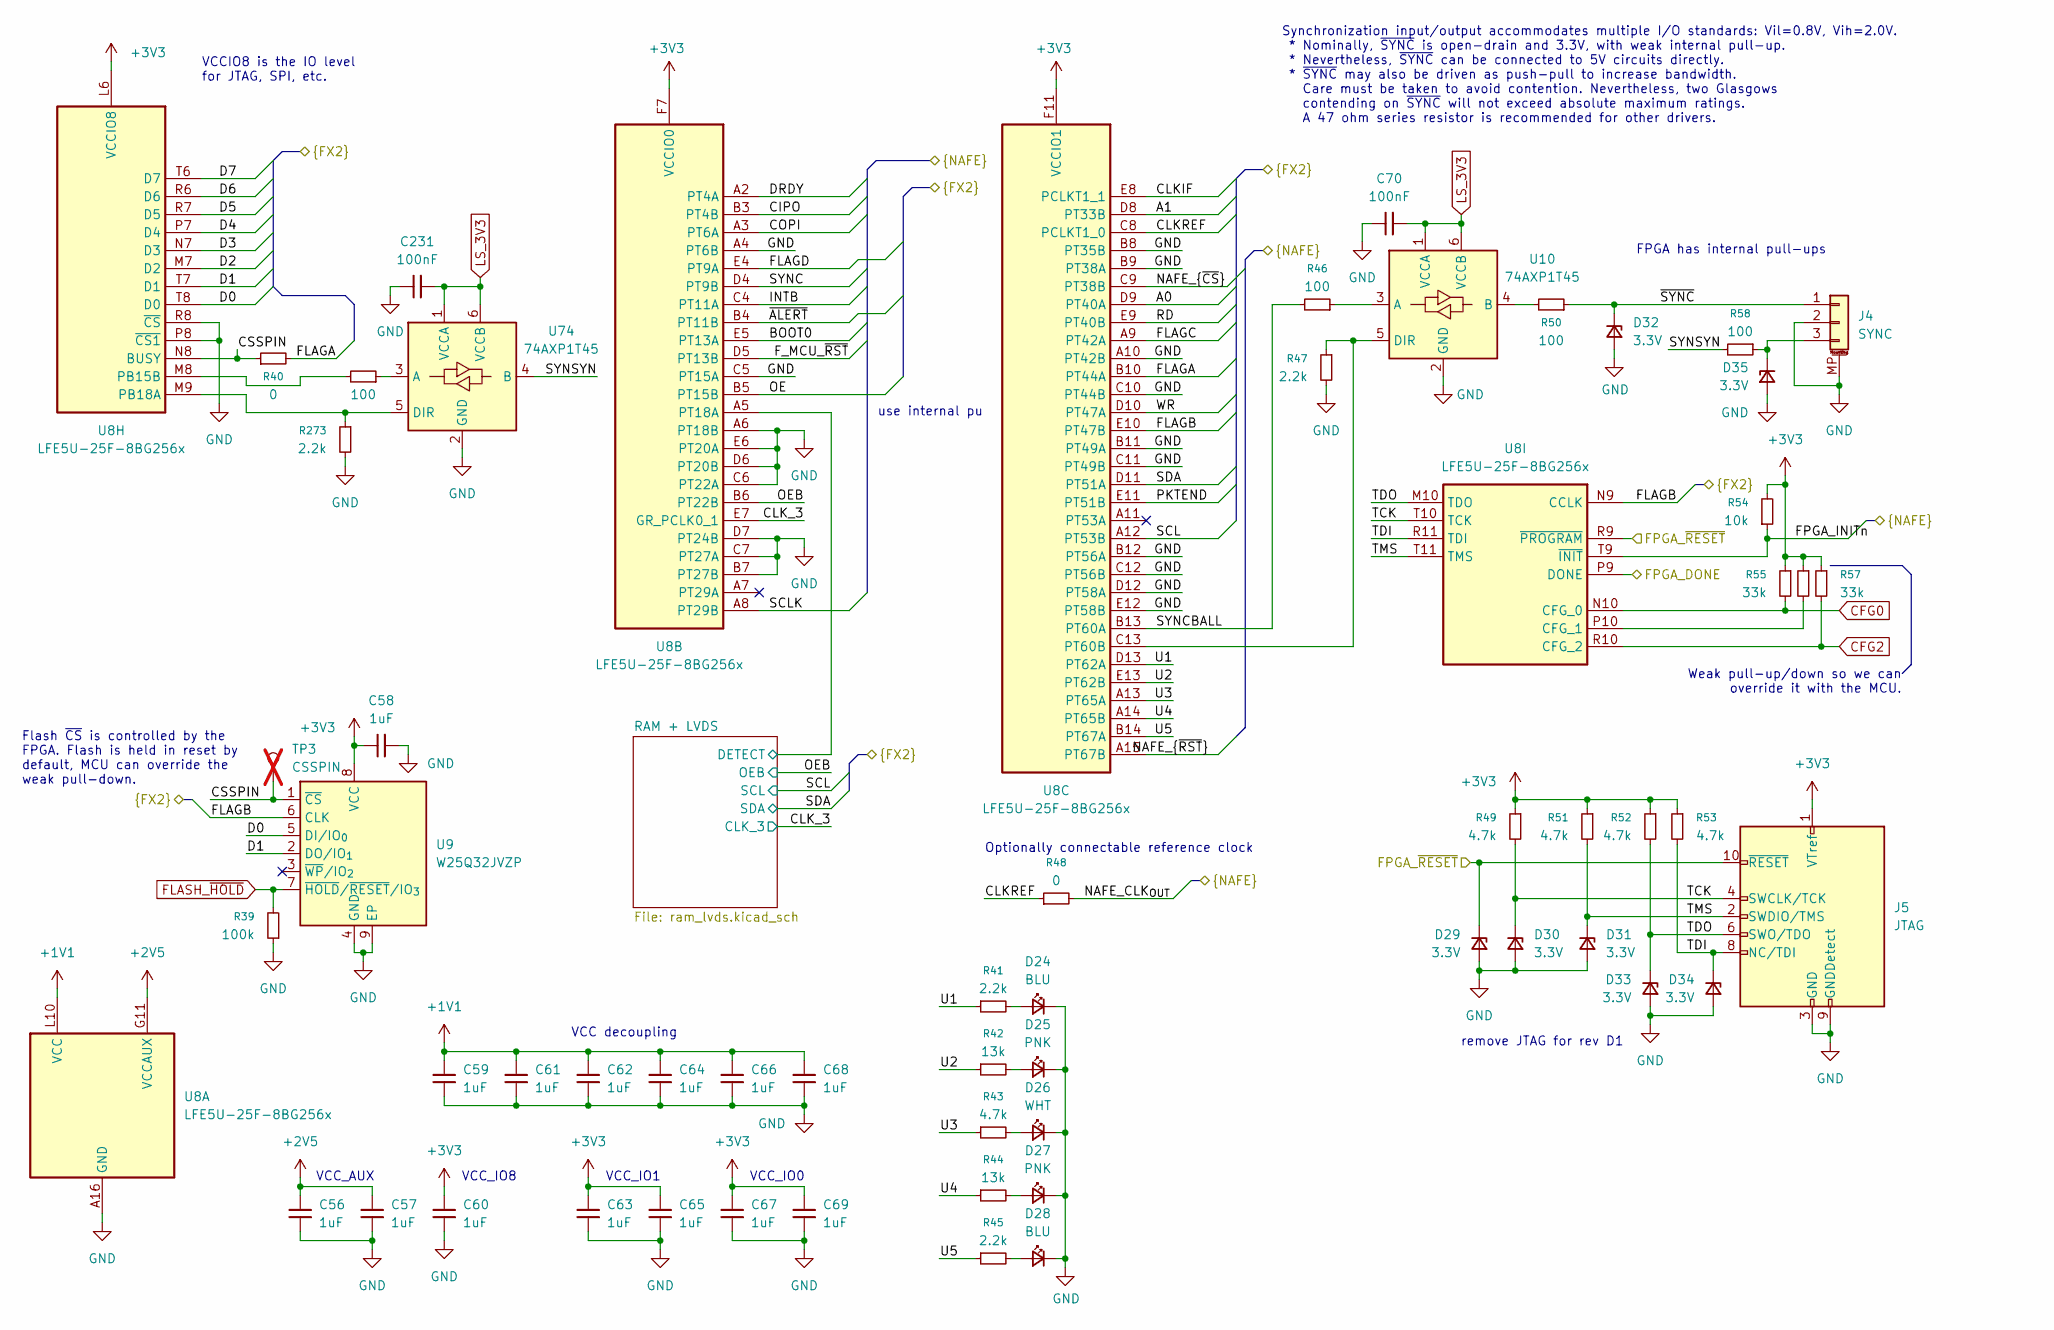
[picture p5: schematic fpga.kicad_sch, FPGA - IF, Flash and Sync]

Parts:
C56, C57, C59, C60, C61, C62, C63, C64, C65, C66, C67, C68, C69: 1uF; C_0201_0603Metric; MPN CL03A105MO3NRNH; LCSC C307385
C58: 1uF; C_0402_1005Metric; MPN CL05A105KA5NQNC; LCSC C52923
C70, C231: 100nF; C_0402_1005Metric; MPN CL05B104KB54PNC; LCSC C307331
D24, D28: BLU; LED_0603_1608Metric; MPN ORH-B36G; LCSC C2986058
D25, D27: PNK; LED_0603_1608Metric; MPN OSK40603C1E; LCSC C51933299
D26: WHT; LED_0603_1608Metric; MPN NCD0603W1; LCSC C2290
D29, D30, D31, D32, D33, D34, D35: 3.3V; D_0201_0603Metric; MPN TPD1E04U04DPLR-TP; LCSC C41408060
J4: SYNC; JST_SH_SM03B-SRSS-TB_1x03-1MP_P1.00mm_Horizontal; MPN_Alt ZX-SH1.0-3PWT; LCSC C7430445
J5: JTAG; PinHeader_2x05_P1.27mm_Vertical_SMD; MPN FTSH-105-01-L-DV-K-P; LCSC C2932107
R39: 100k; R_0402_1005Metric; MPN 0402WGF1003TCE; LCSC C25741
R40: 0; R_0402_1005Metric; MPN PE0402FRF470R05L; LCSC C851623
R41, R45, R47, R273: 2.2k; R_0402_1005Metric; MPN RC0402FR-132K2L; LCSC C25879
R42, R44: 13k; R_0402_1005Metric; MPN 0402WGF1302TCE; LCSC C25754
R43, R49, R51, R52, R53: 4.7k; R_0402_1005Metric; MPN 0402WGF4701TCE; LCSC C25900
R46, R50, R58, R272: 100; R_0402_1005Metric; MPN 0402WGF1000TCE; LCSC C25076
R48: 0; R_0201_0603Metric; MPN RC0201FR-070RL; LCSC C106227
R54: 10k; R_0402_1005Metric; MPN 0402WGF1002TCE; LCSC C25744
R55, R56, R57: 33k; R_0402_1005Metric; MPN 0402WGF3302TCE; LCSC C25779
TP3: CSSPIN; TestPoint_Pad_D1.0mm; not fitted
U8: LFE5U-25F-8BG256x; BGA-256_14.0x14.0mm_Layout16x16_P0.8mm_Ball0.45mm_Pad0.32mm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; MPN LFE5U-25F-6BG256C; LCSC C1521614
U9: W25Q32JVZP; WSON-8-1EP_6x5mm_P1.27mm_EP3.4x4.3mm; MPN W25Q32JVZPIQ; LCSC C571260
U10, U74: 74AXP1T45; SOT-363_SC-70-6; MPN 74AXP1T45GWH; LCSC C5280957

Connections:
+1V1: C59.1, C61.1, C62.1, C64.1, C66.1, C68.1, U8.G6 (VCC), U8.G7 (VCC), U8.G9 (VCC), U8.L8 (VCC), U8.L9 (VCC), U8.L10 (VCC); also elsewhere on the board
+2V5: C56.1, C57.1, U8.G11 (VCCAUX), U8.L7 (VCCAUX); also elsewhere on the board
+3V3: C58.1, C60.1, C63.1, C65.1, C67.1, C69.1, J5.1 (VTref), R49.1, R51.1, R52.1, R53.1, R54.2, R55.1, R56.1, R57.1, U8.F6 (VCCIO0), U8.F7 (VCCIO0), U8.F10 (VCCIO1), U8.F11 (VCCIO1), U8.L6 (VCCIO8), U9.8 (VCC); also elsewhere on the board
/A0: U8.D9 (PT40A); also elsewhere on the board
/A1: U8.D8 (PT33B); also elsewhere on the board
/BOOT0: U8.E5 (PT13A); also elsewhere on the board
/CIPO: U8.B3 (PT4B); also elsewhere on the board
/CLKIF: U8.E8 (PCLKT1_1); also elsewhere on the board
/CLKREF: R48.1, U8.C8 (PCLKT1_0); also elsewhere on the board
/COPI: U8.A3 (PT6A); also elsewhere on the board
/D0: U8.T8 (D0), U9.5 (DI/IO_{0}); also elsewhere on the board
/D1: U8.T7 (D1), U9.2 (DO/IO_{1}); also elsewhere on the board
/D2: U8.M7 (D2); also elsewhere on the board
/D3: U8.N7 (D3); also elsewhere on the board
/D4: U8.P7 (D4); also elsewhere on the board
/D5: U8.R7 (D5); also elsewhere on the board
/D6: U8.R6 (D6); also elsewhere on the board
/D7: U8.T6 (D7); also elsewhere on the board
/DRDY: U8.A2 (PT4A); also elsewhere on the board
/FLAGA: R40.2, U8.B10 (PT44A); also elsewhere on the board
/FLAGB: U8.E10 (PT47B), U8.N9 (CCLK), U9.6 (CLK); also elsewhere on the board
/FLAGC: U8.A9 (PT42A); also elsewhere on the board
/FLAGD: U8.E4 (PT9A); also elsewhere on the board
/FPGA/CLK_3: U8.E7 (GR_PCLK0_1); also elsewhere on the board
/FPGA/CSSPIN: R40.1, TP3.1 (1_1), U8.N8 (BUSY), U9.1 (~CS)
/FPGA/OEB: U8.B6 (PT22B); also elsewhere on the board
/FPGA/RAM + LVDS/DETECT: U8.A5 (PT18A); also elsewhere on the board
/FPGA/SYNCBALL: R46.2, U8.B13 (PT60A)
/FPGA/SYNSYN: R58.2, U74.4 (B)
/FPGA/TCK: D30.1 (K), J5.4 (SWCLK/TCK), R49.2, U8.T10 (TCK)
/FPGA/TDI: D34.1 (K), J5.8 (NC/TDI), R53.2, U8.R11 (TDI)
/FPGA/TDO: D33.1 (K), J5.6 (SWO/TDO), R52.2, U8.M10 (TDO)
/FPGA/TMS: D31.1 (K), J5.2 (SWDIO/TMS), R51.2, U8.T11 (TMS)
/FPGA/U1: R41.1, U8.D13 (PT62A)
/FPGA/U2: R42.1, U8.E13 (PT62B)
/FPGA/U3: R43.1, U8.A13 (PT65A)
/FPGA/U4: R44.1, U8.A14 (PT65B)
/FPGA/U5: R45.1, U8.B14 (PT67A)
/FPGA/~SYNC: D32.1 (K), J4.1, R50.1
/FPGA_DONE: U8.P9 (DONE); also elsewhere on the board
/FPGA_INITn: R54.1, U8.T9 (~INIT); also elsewhere on the board
/FPGA_~RESET: D29.1 (K), J5.10 (~RESET), U8.R9 (~PROGRAM); also elsewhere on the board
/F_MCU_~RST: U8.D5 (PT13B); also elsewhere on the board
/INTB: U8.C4 (PT11A); also elsewhere on the board
/NAFE_CLK_{OUT}: R48.2; also elsewhere on the board
/NAFE_{~CS}: U8.C9 (PT38B); also elsewhere on the board
/NAFE_{~RST}: U8.A15 (PT67B); also elsewhere on the board
/OE: U8.B5 (PT15B); also elsewhere on the board
/PKTEND: U8.E11 (PT51B); also elsewhere on the board
/RD: U8.E9 (PT40B); also elsewhere on the board
/SCL: U8.A12 (PT53B); also elsewhere on the board
/SCLK: U8.A8 (PT29B); also elsewhere on the board
/SDA: U8.D11 (PT51A); also elsewhere on the board
/SYNC: U8.D4 (PT9B); also elsewhere on the board
/WR: U8.D10 (PT47A); also elsewhere on the board
/~ALERT: U8.B4 (PT11B); also elsewhere on the board
CFG0: R55.2, U8.N10 (CFG_0); also elsewhere on the board
CFG2: R57.2, U8.R10 (CFG_2); also elsewhere on the board
FLASH_~HOLD: R39.2, U9.7 (~HOLD/~RESET/IO_{3}); also elsewhere on the board
GND: C56.2, C57.2, C58.2, C59.2, C60.2, C61.2, C62.2, C63.2, C64.2, C65.2, C66.2, C67.2, C68.2, C69.2, C70.1, C231.2, D24.1 (K), D25.1 (K), D26.1 (K), D27.1 (K), D28.1 (K), D29.2 (A), D30.2 (A), D31.2 (A), D32.2 (A), D33.2 (A), D34.2 (A), D35.2 (A), J4.2, J4.MP (MountPin), J5.3 (GND), J5.5 (GND), J5.9 (GNDDetect), R39.1, R47.2, R273.2, U8.A1 (GND), U8.A4 (PT6B), U8.A6 (PT18B), U8.A10 (PT42B), U8.A16 (GND), U8.B7 (PT27B), U8.B8 (PT35B), U8.B9 (PT38A), U8.B11 (PT49A), U8.B12 (PT56A), U8.C5 (PT15A), U8.C6 (PT22A), U8.C7 (PT27A), U8.C10 (PT44B), U8.C11 (PT49B), U8.C12 (PT56B), U8.D2 (GND), U8.D6 (PT20B), U8.D7 (PT24B), U8.D12 (PT58A), U8.D15 (GND), U8.E6 (PT20A), U8.E12 (PT58B), U8.F8 (GND), U8.F9 (GND), U8.G8 (GND), U8.G10 (GND), U8.H1 (GND), U8.H8 (GND), U8.H9 (GND), U8.H10 (GND), U8.H16 (GND), U8.J8 (GND), U8.J9 (GND), U8.J10 (GND), U8.K6 (GND), U8.K7 (GND), U8.K8 (GND), U8.K9 (GND), U8.K10 (GND), U8.N2 (GND), U8.N15 (GND), U8.P8 (~CS1), U8.R8 (~CS), U8.T1 (GND), U8.T5 (GND), U8.T12 (GND), U8.T16 (GND), U9.4 (GND), U9.9 (EP), U10.2 (GND), U74.2 (GND); also elsewhere on the board
LS_3V3: C70.2, C231.1, U10.1 (VCCA), U10.6 (VCCB), U74.1 (VCCA), U74.6 (VCCB); also elsewhere on the board
unnamed: D24.2 (A), R41.2
unnamed: D25.2 (A), R42.2
unnamed: D26.2 (A), R43.2
unnamed: D27.2 (A), R44.2
unnamed: D28.2 (A), R45.2
unnamed: D35.1 (K), J4.3, R58.1
unnamed: R272.2, U8.M8 (PB15B)
unnamed: R56.2, U8.P10 (CFG_1)
unnamed: R46.1, U10.3 (A)
unnamed: R50.2, U10.4 (B)
unnamed: R47.1, U8.C13 (PT60B), U10.5 (DIR)
unnamed: R272.1, U74.3 (A)
unnamed: R273.1, U8.M9 (PB18A), U74.5 (DIR)

Notes on the sheet:
FPGA has internal pull-ups
use internal pu
Flash ~{CS} is controlled by the FPGA. Flash is held in reset by default, MCU can override the weak pull-down.
Optionally connectable reference clock
Synchronization input/output accommodates multiple I/O standards: Vil=0.8V, Vih=2.0V. * Nominally, ~{SYNC} is open-drain and 3.3V, with weak internal pull-up. * Nevertheless, ~{SYNC} can be connected to 5V circuits directly. * ~{SYNC} may also be driven as push-pull to increase bandwidth. Care must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
VCC_IO1
VCCIO8 is the IO level for JTAG, SPI, etc.
Weak pull-up/down so we can override it with the MCU.
VCC_AUX
VCC_IO8
remove JTAG for rev D1
VCC decoupling
VCC_IO0

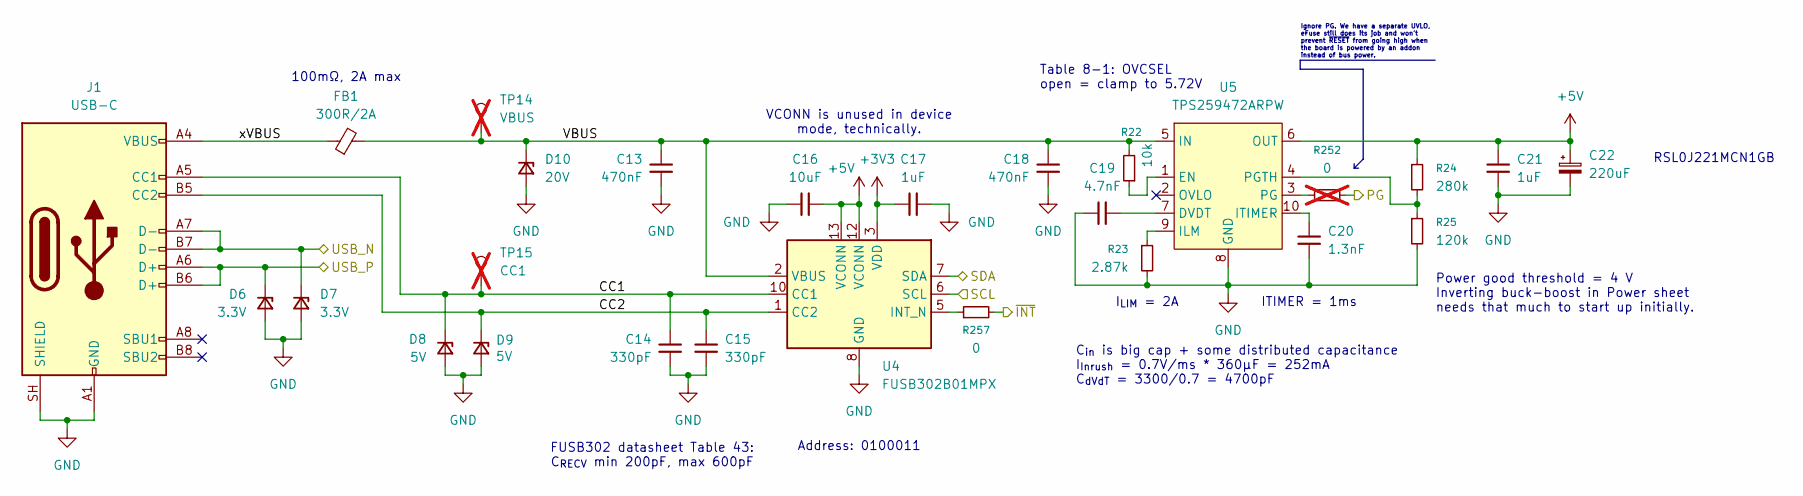
[picture p6: schematic USB.kicad_sch, USB input protection]

Parts:
C13, C18: 470nF; C_0603_1608Metric; MPN UMK107B7474KA-TR; LCSC C92847
C14, C15: 330pF; C_0402_1005Metric; MPN CL05C331JB5NNNC; LCSC C13533
C16: 10uF; C_0603_1608Metric; MPN CGA0603X5R106M350JT; LCSC C6119878
C17, C21: 1uF; C_0402_1005Metric; MPN CL05A105KA5NQNC; LCSC C52923
C19: 4.7nF; C_0402_1005Metric; MPN GRM1555C1H472JE01D; LCSC C1518204
C20: 1.3nF; C_0402_1005Metric; MPN C0402C132J5GACTU; LCSC C19170936
C22: 220uF; CP_Elec_6.3x4.5; MPN RSL0J221MCN1GB; LCSC C2161512
D6, D7: 3.3V; D_0402_1005Metric; MPN ESD321DPYR; LCSC C19829523
D8, D9: 5V; D_SOD-523; MPN ESD5Z5.0T1G; LCSC C5199848
D10: 20V; D_SOD-123; MPN MMSZ5250B; LCSC C19077431
FB1: 300R/2A; L_0603_1608Metric; MPN HCB1608KF-601T20; LCSC C304319
J1: USB-C; USB_C_Receptacle_HRO_TYPE-C-31-M-12; LCSC C165948
R22: 10k; R_0402_1005Metric; MPN 0402WGF1002TCE; LCSC C25744
R23: 2.87k; R_0402_1005Metric; MPN 0402WGF2871TCE; LCSC C113479
R24: 280k; R_0402_1005Metric; MPN FRC0402F2803TS; LCSC C2929997
R25: 120k; R_0402_1005Metric; MPN 0402WGF1203TCE; LCSC C25750
R252: 0; R_0402_1005Metric; MPN 0402WGF0000TCE; LCSC C17168; not fitted
R257: 0; R_0402_1005Metric; MPN PE0402FRF470R05L; LCSC C851623
TP14: VBUS; TestPoint_Pad_D1.0mm; not fitted
TP15: CC1; TestPoint_Pad_D1.0mm; not fitted
U4: FUSB302B01MPX; WQFN-14-1EP_2.5x2.5mm_P0.5mm_EP1.45x1.45mm; MPN FUSB302B01MPX; LCSC C488155
U5: TPS259472ARPW; Texas_RPW0010A_VQFN-HR10_2x2x1mm; MPN TPS259472ARPW; LCSC C3662789

Connections:
+3V3: C17.1, U4.3 (VDD), U4.4 (VDD); also elsewhere on the board
+5V: C16.2, C21.1, C22.1, R24.1, U4.12 (VCONN), U4.13 (VCONN), U5.6 (OUT); also elsewhere on the board
/PG_{VBUS}: R252.2; also elsewhere on the board
/SCL: U4.6 (SCL); also elsewhere on the board
/SDA: U4.7 (SDA); also elsewhere on the board
/USB/CC1: C14.1, D8.1 (K), J1.A5 (CC1), TP15.1 (1_1), U4.10 (CC1), U4.11 (CC1)
/USB/CC2: C15.1, D9.1 (K), J1.B5 (CC2), U4.1 (CC2), U4.14 (CC2)
/USB/VBUS: C13.2, C18.2, D10.1 (K), FB1.2, R22.2, TP14.1 (1_1), U4.2 (VBUS), U5.5 (IN)
/USB/xVBUS: FB1.1, J1.A4 (VBUS), J1.A9 (VBUS), J1.B4 (VBUS), J1.B9 (VBUS)
/USB_N: D7.1 (K), J1.A7 (D-), J1.B7 (D-); also elsewhere on the board
/USB_P: D6.1 (K), J1.A6 (D+), J1.B6 (D+); also elsewhere on the board
/~ALERT: R257.2; also elsewhere on the board
GND: C13.1, C14.2, C15.2, C16.1, C17.2, C18.1, C19.1, C20.1, C21.2, C22.2, D6.2 (A), D7.2 (A), D8.2 (A), D9.2 (A), D10.2 (A), J1.A1 (GND), J1.A12 (GND), J1.B1 (GND), J1.B12 (GND), J1.SH (SHIELD), R23.2, R25.2, U4.8 (GND), U4.9 (GND), U4.15 (GND), U5.8 (GND); also elsewhere on the board
unnamed: R257.1, U4.5 (INT_N)
unnamed: C19.2, U5.7 (DVDT)
unnamed: R22.1, U5.1 (EN)
unnamed: R23.1, U5.9 (ILM)
unnamed: C20.2, U5.10 (ITIMER)
unnamed: R252.1, U5.3 (PG)
unnamed: R24.2, R25.1, U5.4 (PGTH)

Notes on the sheet:
C_{in} is big cap + some distributed capacitance I_{Inrush} = 0.7V/ms * 360µF = 252mA C_{dVdT} = 3300/0.7 = 4700pF
Table 8-1: OVCSEL open = clamp to 5.72V
I_{LIM} = 2A
100mΩ, 2A max
Power good threshold = 4 V Inverting buck-boost in Power sheet needs that much to start up initially.
Address: 0100011
FUSB302 datasheet Table 43: C_{RECV} min 200pF, max 600pF
ITIMER = 1ms
VCONN is unused in device mode, technically.
Ignore PG. We have a separate UVLO, eFuse still does its job and won't prevent ~{RESET} from going high when the board is powered by an addon instead of bus power.
RSL0J221MCN1GB
