tachiniererin/glasgow/hardware/boards/glasgow/revD1/glasgow.kicad_pcb

## KiCad design hardware/boards/glasgow/revD1/glasgow.kicad_pcb (continued)

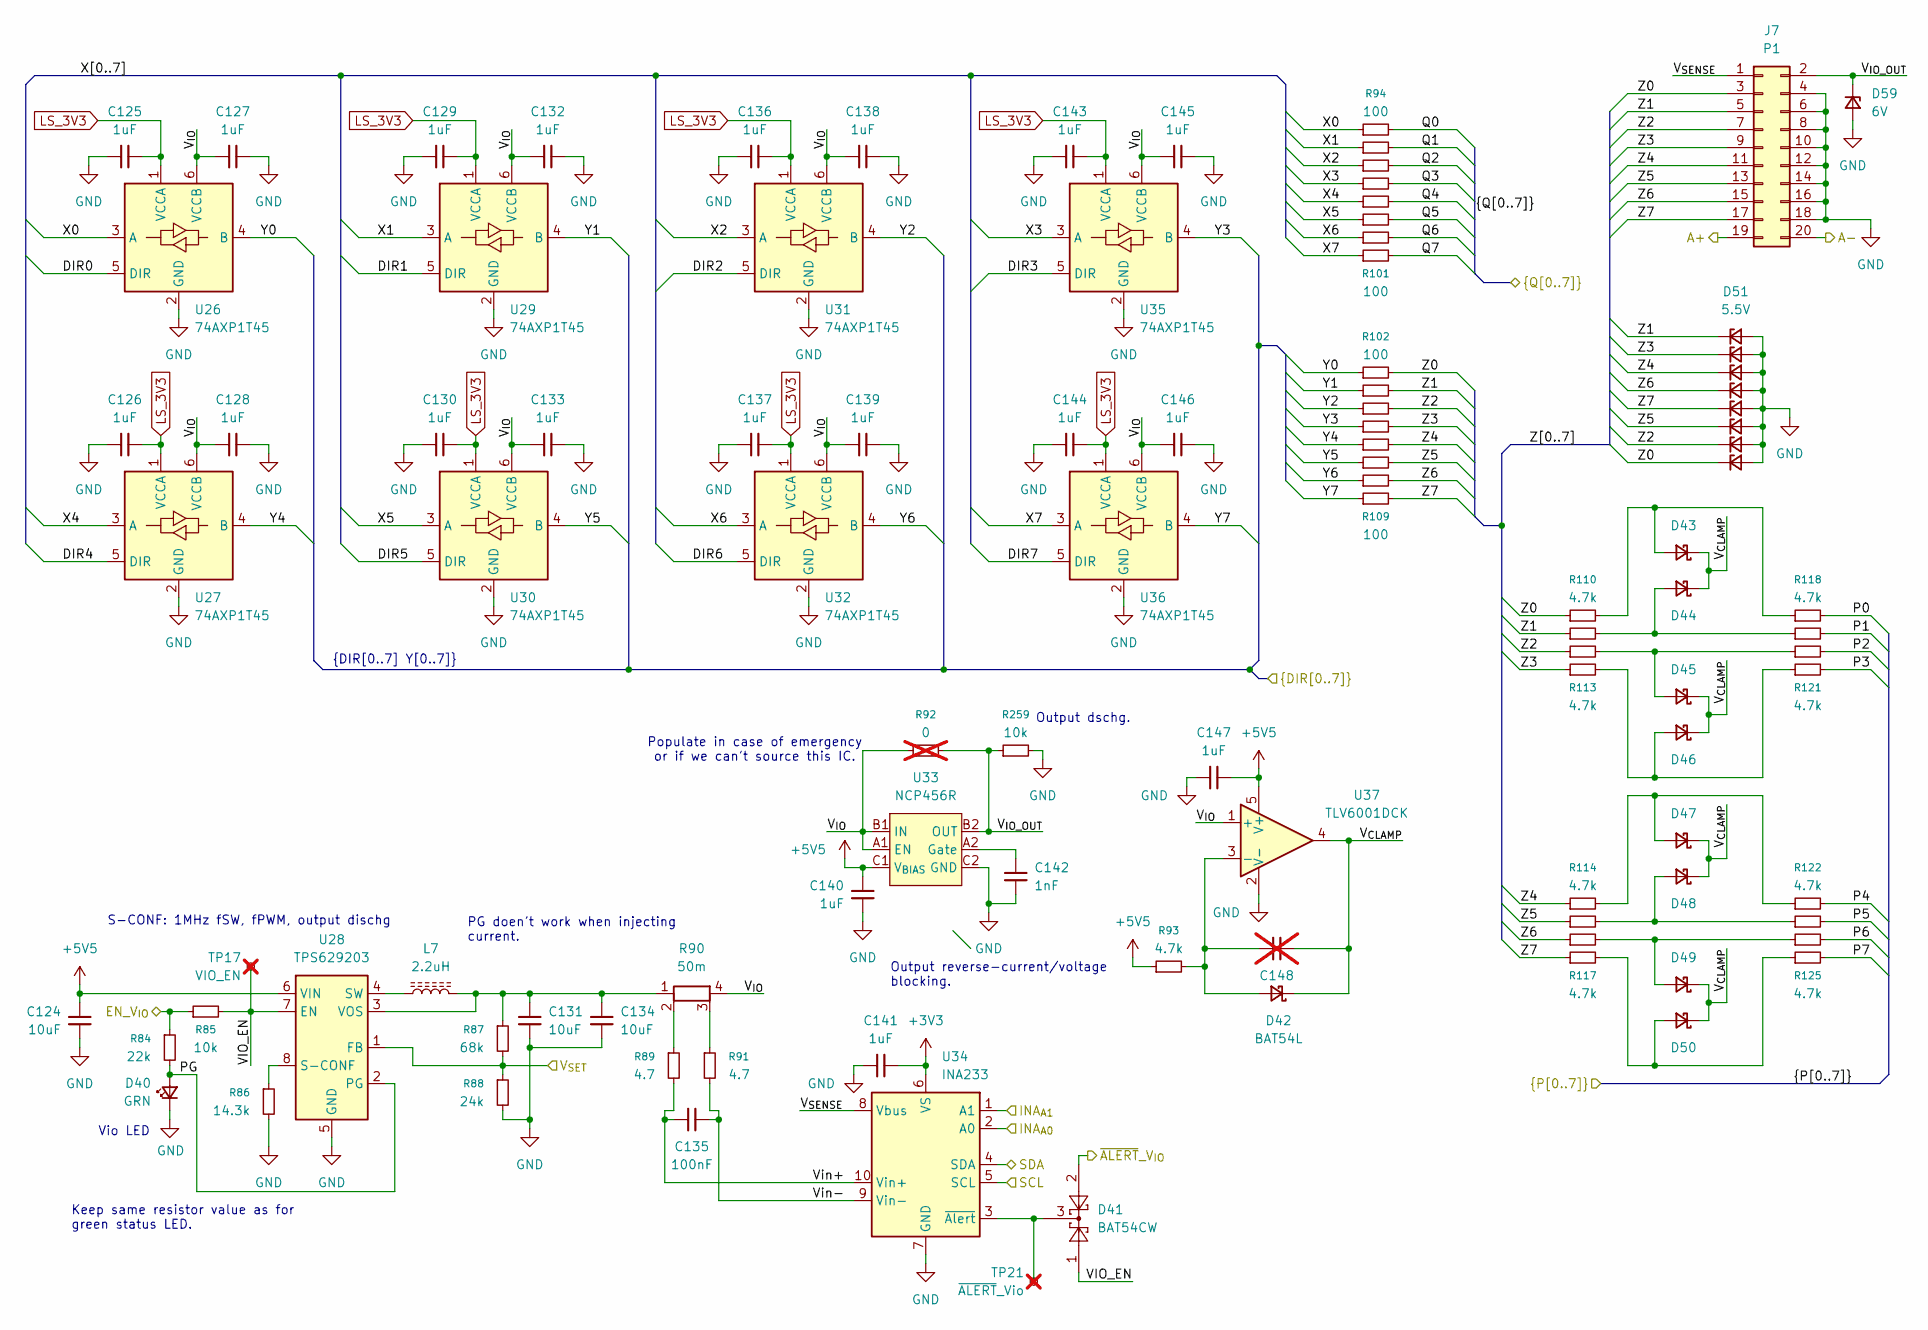
[picture p7: schematic level_shifters.kicad_sch, IO Bank]

Parts:
C124, C131, C134: 10uF; C_0402_1005Metric; MPN CL05A106MQ5NUNC; LCSC C15525
C125, C126, C127, C128, C129, C130, C132, C133, C136, C137, C138, C139, C140, C141, C143, C144, C145, C146, C147: 1uF; C_0402_1005Metric; MPN CL05A105KA5NQNC; LCSC C52923
C135: 100nF; C_0402_1005Metric; MPN CL05B104KB54PNC; LCSC C307331
C142: 1nF; C_0201_0603Metric; MPN CC0201KRX7R9BB102; LCSC C505464
C148: C_0402_1005Metric; not fitted
D40: GRN; LED_0603_1608Metric; MPN NCD0603G1; LCSC C2986048
D41: BAT54CW; SOT-323_SC-70; MPN BAT54CW; LCSC C22392482
D42, D43, D44, D45, D46, D47, D48, D49, D50: BAT54L; D_SOD-882; MPN BAT54L; LCSC C587155
D51, D52, D53, D54, D55, D56, D57, D58: 5.5V; D_0201_0603Metric; MPN ESD441DPLR; LCSC C46472760
D59: 6V; D_SOD-123; MPN MMSZ5233BT1G; LCSC C145506
J7: P1; IDC-Header_2x10_P2.54mm_Vertical_SMD; MPN BH-00019; LCSC C2829930
L7: 2.2uH; L_Changjiang_FTC201612S; MPN FTC201612S2R2MBCA; LCSC C18724414
R84: 22k; R_0402_1005Metric; MPN 0402WGF2202TCE; LCSC C25768
R85: 10k; R_0402_1005Metric; MPN 0402WGF1002TCE; LCSC C25744
R86: 14.3k; R_0402_1005Metric; MPN 0402WGF1432TCE; LCSC C25855
R87: 68k; R_0402_1005Metric; MPN 0402WGF6802TCE; LCSC C36871
R88: 24k; R_0402_1005Metric; MPN RC-02K243JT; LCSC C1152
R89, R91: 4.7; R_0402_1005Metric; MPN 0402WGJ047JTCE; LCSC C25169
R90: 50m; R_Shunt_Alt_1206_3216Metric; MPN RLM12FTCMR050; LCSC C912768
R92: 0; R_0402_1005Metric; MPN 0402WGF0000TCE; LCSC C17168; not fitted
R93: 4.7k; R_0402_1005Metric; MPN 0402WGF4701TCE; LCSC C25900
R94, R95, R96, R97, R98, R99, R100, R101, R102, R103, R104, R105, R106, R107, R108, R109: 100; R_0201_0603Metric; MPN 0201WMF1000TEE; LCSC C270366
R110, R111, R112, R113, R114, R115, R116, R117, R118, R119, R120, R121, R122, R123, R124, R125: 4.7k; R_0201_0603Metric; MPN 0201WMF4701TEE; LCSC C270346
R259: 10k; R_0201_0603Metric; MPN RC0201FR-0710KL; LCSC C106225
TP17: VIO_EN; TestPoint_Pad_D0.5mm; not fitted
TP21: ~{ALERT}_Vio; TestPoint_Pad_D0.5mm; not fitted
U26, U27, U29, U30, U31, U32, U35, U36: 74AXP1T45; SOT-363_SC-70-6; MPN 74AXP1T45GWH; LCSC C5280957
U28: TPS629203; SOT-583-8; MPN TPS629203DRLR; LCSC C5219295
U33: NCP456R; WLCSP-6_1.4x1.0mm_P0.4mm; MPN NCP456R; LCSC C603742
U34: INA233; TSSOP-10_3x3mm_P0.5mm; MPN INA233AIDGSR; LCSC C486316
U37: TLV6001DCK; SOT-353_SC-70-5; MPN TLV6001IDCKR; LCSC C2057455

Connections:
+3V3: C141.1, U34.6 (VS); also elsewhere on the board
+5V5: C124.1, C140.1, C147.1, R93.1, U28.6 (VIN), U33.C1 (V_{BIAS}), U37.5 (V+); also elsewhere on the board
/ADC/A1raw_N: J7.20; also elsewhere on the board
/ADC/A1raw_P: J7.19; also elsewhere on the board
/ENVA: R84.1, R85.1; also elsewhere on the board
/IO Banks/A.DIR0: U26.5 (DIR); also elsewhere on the board
/IO Banks/A.DIR1: U29.5 (DIR); also elsewhere on the board
/IO Banks/A.DIR2: U31.5 (DIR); also elsewhere on the board
/IO Banks/A.DIR3: U35.5 (DIR); also elsewhere on the board
/IO Banks/A.DIR4: U27.5 (DIR); also elsewhere on the board
/IO Banks/A.DIR5: U30.5 (DIR); also elsewhere on the board
/IO Banks/A.DIR6: U32.5 (DIR); also elsewhere on the board
/IO Banks/A.DIR7: U36.5 (DIR); also elsewhere on the board
/IO Banks/A.P0: R118.2; also elsewhere on the board
/IO Banks/A.P1: R119.2; also elsewhere on the board
/IO Banks/A.P2: R120.2; also elsewhere on the board
/IO Banks/A.P3: R121.2; also elsewhere on the board
/IO Banks/A.P4: R122.2; also elsewhere on the board
/IO Banks/A.P5: R123.2; also elsewhere on the board
/IO Banks/A.P6: R124.2; also elsewhere on the board
/IO Banks/A.P7: R125.2; also elsewhere on the board
/IO Banks/A.Q0: R94.2; also elsewhere on the board
/IO Banks/A.Q1: R95.2; also elsewhere on the board
/IO Banks/A.Q2: R96.2; also elsewhere on the board
/IO Banks/A.Q3: R97.2; also elsewhere on the board
/IO Banks/A.Q4: R98.2; also elsewhere on the board
/IO Banks/A.Q5: R99.2; also elsewhere on the board
/IO Banks/A.Q6: R100.2; also elsewhere on the board
/IO Banks/A.Q7: R101.2; also elsewhere on the board
/IO Banks/Bank A/PG: D40.2 (A), R84.2, U28.2 (PG)
/IO Banks/Bank A/VIO_EN: D41.1, R85.2, TP17.1 (1_1), U28.7 (EN)
/IO Banks/Bank A/V_{CLAMP}: C148.1, D42.1 (K), D43.1 (K), D44.1 (K), D45.1 (K), D46.1 (K), D47.1 (K), D48.1 (K), D49.1 (K), D50.1 (K), U37.4
/IO Banks/Bank A/V_{IO_OUT}: D59.1 (K), J7.2, R92.2, R259.1, U33.B2 (OUT)
/IO Banks/Bank A/V_{IO}: C127.1, C128.1, C132.1, C133.1, C138.1, C139.1, C145.1, C146.1, R90.4, R92.1, U26.6 (VCCB), U27.6 (VCCB), U29.6 (VCCB), U30.6 (VCCB), U31.6 (VCCB), U32.6 (VCCB), U33.A1 (EN), U33.B1 (IN), U35.6 (VCCB), U36.6 (VCCB), U37.1 (+)
/IO Banks/Bank A/V_{SENSE}: J7.1, U34.8 (Vbus)
/IO Banks/Bank A/Vin+: C135.1, R89.2, U34.10 (Vin+)
/IO Banks/Bank A/Vin-: C135.2, R91.2, U34.9 (Vin-)
/IO Banks/Bank A/X0: R94.1, U26.3 (A)
/IO Banks/Bank A/X1: R95.1, U29.3 (A)
/IO Banks/Bank A/X2: R96.1, U31.3 (A)
/IO Banks/Bank A/X3: R97.1, U35.3 (A)
/IO Banks/Bank A/X4: R98.1, U27.3 (A)
/IO Banks/Bank A/X5: R99.1, U30.3 (A)
/IO Banks/Bank A/X6: R100.1, U32.3 (A)
/IO Banks/Bank A/X7: R101.1, U36.3 (A)
/IO Banks/Bank A/Y0: R102.1, U26.4 (B)
/IO Banks/Bank A/Y1: R103.1, U29.4 (B)
/IO Banks/Bank A/Y2: R104.1, U31.4 (B)
/IO Banks/Bank A/Y3: R105.1, U35.4 (B)
/IO Banks/Bank A/Y4: R106.1, U27.4 (B)
/IO Banks/Bank A/Y5: R107.1, U30.4 (B)
/IO Banks/Bank A/Y6: R108.1, U32.4 (B)
/IO Banks/Bank A/Y7: R109.1, U36.4 (B)
/IO Banks/Bank A/Z0: D58.1 (K), J7.3, R102.2, R110.1
/IO Banks/Bank A/Z1: D51.1 (K), J7.5, R103.2, R111.1
/IO Banks/Bank A/Z2: D57.1 (K), J7.7, R104.2, R112.1
/IO Banks/Bank A/Z3: D52.1 (K), J7.9, R105.2, R113.1
/IO Banks/Bank A/Z4: D53.1 (K), J7.11, R106.2, R114.1
/IO Banks/Bank A/Z5: D56.1 (K), J7.13, R107.2, R115.1
/IO Banks/Bank A/Z6: D54.1 (K), J7.15, R108.2, R116.1
/IO Banks/Bank A/Z7: D55.1 (K), J7.17, R109.2, R117.1
/IO Banks/V_{SET_A}: R87.2, R88.1, U28.1 (FB); also elsewhere on the board
/SCL: U34.1 (A1), U34.5 (SCL); also elsewhere on the board
/SDA: U34.4 (SDA); also elsewhere on the board
/~ALERT: D41.2; also elsewhere on the board
GND: C124.2, C125.1, C126.1, C127.2, C128.2, C129.1, C130.1, C131.2, C132.2, C133.2, C134.2, C136.1, C137.1, C138.2, C139.2, C140.2, C141.2, C142.2, C143.1, C144.1, C145.2, C146.2, C147.2, D40.1 (K), D51.2 (A), D52.2 (A), D53.2 (A), D54.2 (A), D55.2 (A), D56.2 (A), D57.2 (A), D58.2 (A), D59.2 (A), J7.4, J7.6, J7.8, J7.10, J7.12, J7.14, J7.16, J7.18, R86.2, R88.2, R259.2, U26.2 (GND), U27.2 (GND), U28.5 (GND), U29.2 (GND), U30.2 (GND), U31.2 (GND), U32.2 (GND), U33.C2 (GND), U34.2 (A0), U34.7 (GND), U35.2 (GND), U36.2 (GND), U37.2 (V-); also elsewhere on the board
LS_3V3: C125.2, C126.2, C129.2, C130.2, C136.2, C137.2, C143.2, C144.2, U26.1 (VCCA), U27.1 (VCCA), U29.1 (VCCA), U30.1 (VCCA), U31.1 (VCCA), U32.1 (VCCA), U35.1 (VCCA), U36.1 (VCCA); also elsewhere on the board
unnamed: C148.2, D42.2 (A), R93.2, U37.3 (-)
unnamed: D43.2 (A), R110.2, R118.1
unnamed: D44.2 (A), R111.2, R119.1
unnamed: D45.2 (A), R112.2, R120.1
unnamed: D46.2 (A), R113.2, R121.1
unnamed: D47.2 (A), R114.2, R122.1
unnamed: D48.2 (A), R115.2, R123.1
unnamed: D49.2 (A), R116.2, R124.1
unnamed: D50.2 (A), R117.2, R125.1
unnamed: R89.1, R90.2
unnamed: R90.3, R91.1
unnamed: R86.1, U28.8 (S-CONF)
unnamed: L7.1, U28.4 (SW)
unnamed: C131.1, C134.1, L7.2, R87.1, R90.1, U28.3 (VOS)
unnamed: C142.1, U33.A2 (Gate)
unnamed: D41.3, TP21.1 (1_1), U34.3 (~Alert)

Parts of its further copies:
C149, C156, C159, C174, C181, C184, C199, C206, C209: 10uF; C_0402_1005Metric; MPN CL05A106MQ5NUNC; LCSC C15525
C150, C151, C152, C153, C154, C155, C157, C158, C161, C162, C163, C164, C165, C166, C168, C169, C170, C171, C172, C175, C176, C177, C178, C179, C180, C182, C183, C186, C187, C188, C189, C190, C191, C193, C194, C195, C196, C197, C200, C201, C202, C203, C204, C205, C207, C208, C211, C212, C213, C214, C215, C216, C218, C219, C220, C221, C222: 1uF; C_0402_1005Metric; MPN CL05A105KA5NQNC; LCSC C52923
C160, C185, C210: 100nF; C_0402_1005Metric; MPN CL05B104KB54PNC; LCSC C307331
C167, C192, C217: 1nF; C_0201_0603Metric; MPN CC0201KRX7R9BB102; LCSC C505464
D60, D80, D100: GRN; LED_0603_1608Metric; MPN NCD0603G1; LCSC C2986048
D61, D81, D101: BAT54CW; SOT-323_SC-70; MPN BAT54CW; LCSC C22392482
D62, D63, D64, D65, D66, D67, D68, D69, D70, D82, D83, D84, D85, D86, D87, D88, D89, D90, D102, D103, D104, D105, D106, D107, D108, D109, D110: BAT54L; D_SOD-882; MPN BAT54L; LCSC C587155
D71, D72, D73, D74, D75, D76, D77, D78, D91, D92, D93, D94, D95, D96, D97, D98, D111, D112, D113, D114, D115, D116, D117, D118: 5.5V; D_0201_0603Metric; MPN ESD441DPLR; LCSC C46472760
D79, D99, D119: 6V; D_SOD-123; MPN MMSZ5233BT1G; LCSC C145506
J8, J9, J10: P1; IDC-Header_2x10_P2.54mm_Vertical_SMD; MPN BH-00019; LCSC C2829930
L8, L9, L10: 2.2uH; L_Changjiang_FTC201612S; MPN FTC201612S2R2MBCA; LCSC C18724414
R126, R168, R210: 22k; R_0402_1005Metric; MPN 0402WGF2202TCE; LCSC C25768
R127, R169, R211: 10k; R_0402_1005Metric; MPN 0402WGF1002TCE; LCSC C25744
R128, R170, R212: 14.3k; R_0402_1005Metric; MPN 0402WGF1432TCE; LCSC C25855
R129, R171, R213: 68k; R_0402_1005Metric; MPN 0402WGF6802TCE; LCSC C36871
R130, R172, R214: 24k; R_0402_1005Metric; MPN RC-02K243JT; LCSC C1152
R131, R133, R173, R175, R215, R217: 4.7; R_0402_1005Metric; MPN 0402WGJ047JTCE; LCSC C25169
R132, R174, R216: 50m; R_Shunt_Alt_1206_3216Metric; MPN RLM12FTCMR050; LCSC C912768
R134, R176, R218: 0; R_0402_1005Metric; MPN 0402WGF0000TCE; LCSC C17168; not fitted
R135, R177, R219: 4.7k; R_0402_1005Metric; MPN 0402WGF4701TCE; LCSC C25900
R136, R137, R138, R139, R140, R141, R142, R143, R144, R145, R146, R147, R148, R149, R150, R151, R178, R179, R180, R181, R182, R183, R184, R185, R186, R187, R188, R189, R190, R191, R192, R193, R220, R221, R222, R223, R224, R225, R226, R227, R228, R229, R230, R231, R232, R233, R234, R235: 100; R_0201_0603Metric; MPN 0201WMF1000TEE; LCSC C270366
R152, R153, R154, R155, R156, R157, R158, R159, R160, R161, R162, R163, R164, R165, R166, R167, R194, R195, R196, R197, R198, R199, R200, R201, R202, R203, R204, R205, R206, R207, R208, R209, R236, R237, R238, R239, R240, R241, R242, R243, R244, R245, R246, R247, R248, R249, R250, R251: 4.7k; R_0201_0603Metric; MPN 0201WMF4701TEE; LCSC C270346
R269, R270, R271: 10k; R_0201_0603Metric; MPN RC0201FR-0710KL; LCSC C106225
TP18, TP19, TP20: VIO_EN; TestPoint_Pad_D0.5mm; not fitted
TP22, TP23, TP24: ~{ALERT}_Vio; TestPoint_Pad_D0.5mm; not fitted
U38, U39, U41, U42, U43, U44, U47, U48, U50, U51, U53, U54, U55, U56, U59, U60, U62, U63, U65, U66, U67, U68, U71, U72: 74AXP1T45; SOT-363_SC-70-6; MPN 74AXP1T45GWH; LCSC C5280957
U40, U52, U64: TPS629203; SOT-583-8; MPN TPS629203DRLR; LCSC C5219295
U45, U57, U69: NCP456R; WLCSP-6_1.4x1.0mm_P0.4mm; MPN NCP456R; LCSC C603742
U46, U58, U70: INA233; TSSOP-10_3x3mm_P0.5mm; MPN INA233AIDGSR; LCSC C486316
U49, U61, U73: TLV6001DCK; SOT-353_SC-70-5; MPN TLV6001IDCKR; LCSC C2057455

Connections of its further copies:
+3V3: C166.1, C191.1, C216.1, U46.2 (A0), U46.6 (VS), U58.6 (VS), U70.6 (VS); also elsewhere on the board
+5V5: C149.1, C165.1, C172.1, C174.1, C190.1, C197.1, C199.1, C215.1, C222.1, R135.1, R177.1, R219.1, U40.6 (VIN), U45.C1 (V_{BIAS}), U49.5 (V+), U52.6 (VIN), U57.C1 (V_{BIAS}), U61.5 (V+), U64.6 (VIN), U69.C1 (V_{BIAS}), U73.5 (V+); also elsewhere on the board
/ADC/A2raw_N: J8.20; also elsewhere on the board
/ADC/A2raw_P: J8.19; also elsewhere on the board
/ADC/A3raw_N: J9.20; also elsewhere on the board
/ADC/A3raw_P: J9.19; also elsewhere on the board
/ADC/A4raw_N: J10.20; also elsewhere on the board
/ADC/A4raw_P: J10.19; also elsewhere on the board
/ENVB: R126.1, R127.1; also elsewhere on the board
/ENVC: R168.1, R169.1; also elsewhere on the board
/ENVD: R210.1, R211.1; also elsewhere on the board
/IO Banks/B.DIR0: U38.5 (DIR); also elsewhere on the board
/IO Banks/B.DIR1: U41.5 (DIR); also elsewhere on the board
/IO Banks/B.DIR2: U43.5 (DIR); also elsewhere on the board
/IO Banks/B.DIR3: U47.5 (DIR); also elsewhere on the board
/IO Banks/B.DIR4: U39.5 (DIR); also elsewhere on the board
/IO Banks/B.DIR5: U42.5 (DIR); also elsewhere on the board
/IO Banks/B.DIR6: U44.5 (DIR); also elsewhere on the board
/IO Banks/B.DIR7: U48.5 (DIR); also elsewhere on the board
/IO Banks/B.P0: R160.2; also elsewhere on the board
/IO Banks/B.P1: R161.2; also elsewhere on the board
/IO Banks/B.P2: R162.2; also elsewhere on the board
/IO Banks/B.P3: R163.2; also elsewhere on the board
/IO Banks/B.P4: R164.2; also elsewhere on the board
/IO Banks/B.P5: R165.2; also elsewhere on the board
/IO Banks/B.P6: R166.2; also elsewhere on the board
/IO Banks/B.P7: R167.2; also elsewhere on the board
/IO Banks/B.Q0: R136.2; also elsewhere on the board
/IO Banks/B.Q1: R137.2; also elsewhere on the board
/IO Banks/B.Q2: R138.2; also elsewhere on the board
/IO Banks/B.Q3: R139.2; also elsewhere on the board
/IO Banks/B.Q4: R140.2; also elsewhere on the board
/IO Banks/B.Q5: R141.2; also elsewhere on the board
/IO Banks/B.Q6: R142.2; also elsewhere on the board
/IO Banks/B.Q7: R143.2; also elsewhere on the board
/IO Banks/Bank B/PG: D60.2 (A), R126.2, U40.2 (PG)
/IO Banks/Bank B/VIO_EN: D61.1, R127.2, TP18.1 (1_1), U40.7 (EN)
/IO Banks/Bank B/V_{CLAMP}: D62.1 (K), D63.1 (K), D64.1 (K), D65.1 (K), D66.1 (K), D67.1 (K), D68.1 (K), D69.1 (K), D70.1 (K), U49.4; also elsewhere on the board
/IO Banks/Bank B/V_{IO_OUT}: D79.1 (K), J8.2, R134.2, R269.1, U45.B2 (OUT)
/IO Banks/Bank B/V_{IO}: C152.1, C153.1, C157.1, C158.1, C163.1, C164.1, C170.1, C171.1, R132.4, R134.1, U38.6 (VCCB), U39.6 (VCCB), U41.6 (VCCB), U42.6 (VCCB), U43.6 (VCCB), U44.6 (VCCB), U45.A1 (EN), U45.B1 (IN), U47.6 (VCCB), U48.6 (VCCB), U49.1 (+)
/IO Banks/Bank B/V_{SENSE}: J8.1, U46.8 (Vbus)
/IO Banks/Bank B/Vin+: C160.1, R131.2, U46.10 (Vin+)
/IO Banks/Bank B/Vin-: C160.2, R133.2, U46.9 (Vin-)
/IO Banks/Bank B/X0: R136.1, U38.3 (A)
/IO Banks/Bank B/X1: R137.1, U41.3 (A)
/IO Banks/Bank B/X2: R138.1, U43.3 (A)
/IO Banks/Bank B/X3: R139.1, U47.3 (A)
/IO Banks/Bank B/X4: R140.1, U39.3 (A)
/IO Banks/Bank B/X5: R141.1, U42.3 (A)
/IO Banks/Bank B/X6: R142.1, U44.3 (A)
/IO Banks/Bank B/X7: R143.1, U48.3 (A)
/IO Banks/Bank B/Y0: R144.1, U38.4 (B)
/IO Banks/Bank B/Y1: R145.1, U41.4 (B)
/IO Banks/Bank B/Y2: R146.1, U43.4 (B)
/IO Banks/Bank B/Y3: R147.1, U47.4 (B)
/IO Banks/Bank B/Y4: R148.1, U39.4 (B)
/IO Banks/Bank B/Y5: R149.1, U42.4 (B)
/IO Banks/Bank B/Y6: R150.1, U44.4 (B)
/IO Banks/Bank B/Y7: R151.1, U48.4 (B)
/IO Banks/Bank B/Z0: D78.1 (K), J8.3, R144.2, R152.1
/IO Banks/Bank B/Z1: D71.1 (K), J8.5, R145.2, R153.1
/IO Banks/Bank B/Z2: D77.1 (K), J8.7, R146.2, R154.1
/IO Banks/Bank B/Z3: D72.1 (K), J8.9, R147.2, R155.1
/IO Banks/Bank B/Z4: D73.1 (K), J8.11, R148.2, R156.1
/IO Banks/Bank B/Z5: D76.1 (K), J8.13, R149.2, R157.1
/IO Banks/Bank B/Z6: D74.1 (K), J8.15, R150.2, R158.1
/IO Banks/Bank B/Z7: D75.1 (K), J8.17, R151.2, R159.1
/IO Banks/Bank C/PG: D80.2 (A), R168.2, U52.2 (PG)
/IO Banks/Bank C/VIO_EN: D81.1, R169.2, TP19.1 (1_1), U52.7 (EN)
/IO Banks/Bank C/V_{CLAMP}: D82.1 (K), D83.1 (K), D84.1 (K), D85.1 (K), D86.1 (K), D87.1 (K), D88.1 (K), D89.1 (K), D90.1 (K), U61.4; also elsewhere on the board
/IO Banks/Bank C/V_{IO_OUT}: D99.1 (K), J9.2, R176.2, R270.1, U57.B2 (OUT)
/IO Banks/Bank C/V_{IO}: C177.1, C178.1, C182.1, C183.1, C188.1, C189.1, C195.1, C196.1, R174.4, R176.1, U50.6 (VCCB), U51.6 (VCCB), U53.6 (VCCB), U54.6 (VCCB), U55.6 (VCCB), U56.6 (VCCB), U57.A1 (EN), U57.B1 (IN), U59.6 (VCCB), U60.6 (VCCB), U61.1 (+)
/IO Banks/Bank C/V_{SENSE}: J9.1, U58.8 (Vbus)
/IO Banks/Bank C/Vin+: C185.1, R173.2, U58.10 (Vin+)
/IO Banks/Bank C/Vin-: C185.2, R175.2, U58.9 (Vin-)
/IO Banks/Bank C/X0: R178.1, U50.3 (A)
/IO Banks/Bank C/X1: R179.1, U53.3 (A)
/IO Banks/Bank C/X2: R180.1, U55.3 (A)
/IO Banks/Bank C/X3: R181.1, U59.3 (A)
/IO Banks/Bank C/X4: R182.1, U51.3 (A)
/IO Banks/Bank C/X5: R183.1, U54.3 (A)
/IO Banks/Bank C/X6: R184.1, U56.3 (A)
/IO Banks/Bank C/X7: R185.1, U60.3 (A)
/IO Banks/Bank C/Y0: R186.1, U50.4 (B)
/IO Banks/Bank C/Y1: R187.1, U53.4 (B)
/IO Banks/Bank C/Y2: R188.1, U55.4 (B)
/IO Banks/Bank C/Y3: R189.1, U59.4 (B)
/IO Banks/Bank C/Y4: R190.1, U51.4 (B)
/IO Banks/Bank C/Y5: R191.1, U54.4 (B)
/IO Banks/Bank C/Y6: R192.1, U56.4 (B)
/IO Banks/Bank C/Y7: R193.1, U60.4 (B)
/IO Banks/Bank C/Z0: D98.1 (K), J9.3, R186.2, R194.1
/IO Banks/Bank C/Z1: D91.1 (K), J9.5, R187.2, R195.1
/IO Banks/Bank C/Z2: D97.1 (K), J9.7, R188.2, R196.1
/IO Banks/Bank C/Z3: D92.1 (K), J9.9, R189.2, R197.1
/IO Banks/Bank C/Z4: D93.1 (K), J9.11, R190.2, R198.1
/IO Banks/Bank C/Z5: D96.1 (K), J9.13, R191.2, R199.1
/IO Banks/Bank C/Z6: D94.1 (K), J9.15, R192.2, R200.1
/IO Banks/Bank C/Z7: D95.1 (K), J9.17, R193.2, R201.1
/IO Banks/Bank D/PG: D100.2 (A), R210.2, U64.2 (PG)
/IO Banks/Bank D/VIO_EN: D101.1, R211.2, TP20.1 (1_1), U64.7 (EN)
/IO Banks/Bank D/V_{CLAMP}: D102.1 (K), D103.1 (K), D104.1 (K), D105.1 (K), D106.1 (K), D107.1 (K), D108.1 (K), D109.1 (K), D110.1 (K), U73.4; also elsewhere on the board
/IO Banks/Bank D/V_{IO_OUT}: D119.1 (K), J10.2, R218.2, R271.1, U69.B2 (OUT)
/IO Banks/Bank D/V_{IO}: C202.1, C203.1, C207.1, C208.1, C213.1, C214.1, C220.1, C221.1, R216.4, R218.1, U62.6 (VCCB), U63.6 (VCCB), U65.6 (VCCB), U66.6 (VCCB), U67.6 (VCCB), U68.6 (VCCB), U69.A1 (EN), U69.B1 (IN), U71.6 (VCCB), U72.6 (VCCB), U73.1 (+)
/IO Banks/Bank D/V_{SENSE}: J10.1, U70.8 (Vbus)
/IO Banks/Bank D/Vin+: C210.1, R215.2, U70.10 (Vin+)
/IO Banks/Bank D/Vin-: C210.2, R217.2, U70.9 (Vin-)
/IO Banks/Bank D/X0: R220.1, U62.3 (A)
/IO Banks/Bank D/X1: R221.1, U65.3 (A)
/IO Banks/Bank D/X2: R222.1, U67.3 (A)
/IO Banks/Bank D/X3: R223.1, U71.3 (A)
/IO Banks/Bank D/X4: R224.1, U63.3 (A)
/IO Banks/Bank D/X5: R225.1, U66.3 (A)
/IO Banks/Bank D/X6: R226.1, U68.3 (A)
/IO Banks/Bank D/X7: R227.1, U72.3 (A)
/IO Banks/Bank D/Y0: R228.1, U62.4 (B)
/IO Banks/Bank D/Y1: R229.1, U65.4 (B)
/IO Banks/Bank D/Y2: R230.1, U67.4 (B)
/IO Banks/Bank D/Y3: R231.1, U71.4 (B)
/IO Banks/Bank D/Y4: R232.1, U63.4 (B)
/IO Banks/Bank D/Y5: R233.1, U66.4 (B)
/IO Banks/Bank D/Y6: R234.1, U68.4 (B)
/IO Banks/Bank D/Y7: R235.1, U72.4 (B)
/IO Banks/Bank D/Z0: D118.1 (K), J10.3, R228.2, R236.1
/IO Banks/Bank D/Z1: D111.1 (K), J10.5, R229.2, R237.1
/IO Banks/Bank D/Z2: D117.1 (K), J10.7, R230.2, R238.1
/IO Banks/Bank D/Z3: D112.1 (K), J10.9, R231.2, R239.1
/IO Banks/Bank D/Z4: D113.1 (K), J10.11, R232.2, R240.1
/IO Banks/Bank D/Z5: D116.1 (K), J10.13, R233.2, R241.1
/IO Banks/Bank D/Z6: D114.1 (K), J10.15, R234.2, R242.1
/IO Banks/Bank D/Z7: D115.1 (K), J10.17, R235.2, R243.1
/IO Banks/C.DIR0: U50.5 (DIR); also elsewhere on the board
/IO Banks/C.DIR1: U53.5 (DIR); also elsewhere on the board
/IO Banks/C.DIR2: U55.5 (DIR); also elsewhere on the board
/IO Banks/C.DIR3: U59.5 (DIR); also elsewhere on the board
/IO Banks/C.DIR4: U51.5 (DIR); also elsewhere on the board
/IO Banks/C.DIR5: U54.5 (DIR); also elsewhere on the board
/IO Banks/C.DIR6: U56.5 (DIR); also elsewhere on the board
/IO Banks/C.DIR7: U60.5 (DIR); also elsewhere on the board
/IO Banks/C.P0: R202.2; also elsewhere on the board
/IO Banks/C.P1: R203.2; also elsewhere on the board
/IO Banks/C.P2: R204.2; also elsewhere on the board
/IO Banks/C.P3: R205.2; also elsewhere on the board
/IO Banks/C.P4: R206.2; also elsewhere on the board
/IO Banks/C.P5: R207.2; also elsewhere on the board
/IO Banks/C.P6: R208.2; also elsewhere on the board
/IO Banks/C.P7: R209.2; also elsewhere on the board
/IO Banks/C.Q0: R178.2; also elsewhere on the board
/IO Banks/C.Q1: R179.2; also elsewhere on the board
/IO Banks/C.Q2: R180.2; also elsewhere on the board
/IO Banks/C.Q3: R181.2; also elsewhere on the board
/IO Banks/C.Q4: R182.2; also elsewhere on the board
/IO Banks/C.Q5: R183.2; also elsewhere on the board
/IO Banks/C.Q6: R184.2; also elsewhere on the board
/IO Banks/C.Q7: R185.2; also elsewhere on the board
/IO Banks/D.DIR0: U62.5 (DIR); also elsewhere on the board
/IO Banks/D.DIR1: U65.5 (DIR); also elsewhere on the board
/IO Banks/D.DIR2: U67.5 (DIR); also elsewhere on the board
/IO Banks/D.DIR3: U71.5 (DIR); also elsewhere on the board
/IO Banks/D.DIR4: U63.5 (DIR); also elsewhere on the board
/IO Banks/D.DIR5: U66.5 (DIR); also elsewhere on the board
/IO Banks/D.DIR6: U68.5 (DIR); also elsewhere on the board
/IO Banks/D.DIR7: U72.5 (DIR); also elsewhere on the board
/IO Banks/D.P0: R244.2; also elsewhere on the board
/IO Banks/D.P1: R245.2; also elsewhere on the board
/IO Banks/D.P2: R246.2; also elsewhere on the board
/IO Banks/D.P3: R247.2; also elsewhere on the board
/IO Banks/D.P4: R248.2; also elsewhere on the board
/IO Banks/D.P5: R249.2; also elsewhere on the board
/IO Banks/D.P6: R250.2; also elsewhere on the board
/IO Banks/D.P7: R251.2; also elsewhere on the board
/IO Banks/D.Q0: R220.2; also elsewhere on the board
/IO Banks/D.Q1: R221.2; also elsewhere on the board
/IO Banks/D.Q2: R222.2; also elsewhere on the board
/IO Banks/D.Q3: R223.2; also elsewhere on the board
/IO Banks/D.Q4: R224.2; also elsewhere on the board
/IO Banks/D.Q5: R225.2; also elsewhere on the board
/IO Banks/D.Q6: R226.2; also elsewhere on the board
/IO Banks/D.Q7: R227.2; also elsewhere on the board
/IO Banks/V_{SET_B}: R129.2, R130.1, U40.1 (FB); also elsewhere on the board
/IO Banks/V_{SET_C}: R171.2, R172.1, U52.1 (FB); also elsewhere on the board
/IO Banks/V_{SET_D}: R213.2, R214.1, U64.1 (FB); also elsewhere on the board
/SCL: U46.1 (A1), U46.5 (SCL), U58.1 (A1), U58.5 (SCL), U70.1 (A1), U70.2 (A0), U70.5 (SCL); also elsewhere on the board
/SDA: U46.4 (SDA), U58.2 (A0), U58.4 (SDA), U70.4 (SDA); also elsewhere on the board
/~ALERT: D61.2, D81.2, D101.2; also elsewhere on the board
GND: C149.2, C150.1, C151.1, C152.2, C153.2, C154.1, C155.1, C156.2, C157.2, C158.2, C159.2, C161.1, C162.1, C163.2, C164.2, C165.2, C166.2, C167.2, C168.1, C169.1, C170.2, C171.2, C172.2, C174.2, C175.1, C176.1, C177.2, C178.2, C179.1, C180.1, C181.2, C182.2, C183.2, C184.2, C186.1, C187.1, C188.2, C189.2, C190.2, C191.2, C192.2, C193.1, C194.1, C195.2, C196.2, C197.2, C199.2, C200.1, C201.1, C202.2, C203.2, C204.1, C205.1, C206.2, C207.2, C208.2, C209.2, C211.1, C212.1, C213.2, C214.2, C215.2, C216.2, C217.2, C218.1, C219.1, C220.2, C221.2, C222.2, D60.1 (K), D71.2 (A), D72.2 (A), D73.2 (A), D74.2 (A), D75.2 (A), D76.2 (A), D77.2 (A), D78.2 (A), D79.2 (A), D80.1 (K), D91.2 (A), D92.2 (A), D93.2 (A), D94.2 (A), D95.2 (A), D96.2 (A), D97.2 (A), D98.2 (A), D99.2 (A), D100.1 (K), D111.2 (A), D112.2 (A), D113.2 (A), D114.2 (A), D115.2 (A), D116.2 (A), D117.2 (A), D118.2 (A), D119.2 (A), J8.4, J8.6, J8.8, J8.10, J8.12, J8.14, J8.16, J8.18, J9.4, J9.6, J9.8, J9.10, J9.12, J9.14, J9.16, J9.18, J10.4, J10.6, J10.8, J10.10, J10.12, J10.14, J10.16, J10.18, R128.2, R130.2, R170.2, R172.2, R212.2, R214.2, R269.2, R270.2, R271.2, U38.2 (GND), U39.2 (GND), U40.5 (GND), U41.2 (GND), U42.2 (GND), U43.2 (GND), U44.2 (GND), U45.C2 (GND), U46.7 (GND), U47.2 (GND), U48.2 (GND), U49.2 (V-), U50.2 (GND), U51.2 (GND), U52.5 (GND), U53.2 (GND), U54.2 (GND), U55.2 (GND), U56.2 (GND), U57.C2 (GND), U58.7 (GND), U59.2 (GND), U60.2 (GND), U61.2 (V-), U62.2 (GND), U63.2 (GND), U64.5 (GND), U65.2 (GND), U66.2 (GND), U67.2 (GND), U68.2 (GND), U69.C2 (GND), U70.7 (GND), U71.2 (GND), U72.2 (GND), U73.2 (V-); also elsewhere on the board
LS_3V3: C150.2, C151.2, C154.2, C155.2, C161.2, C162.2, C168.2, C169.2, C175.2, C176.2, C179.2, C180.2, C186.2, C187.2, C193.2, C194.2, C200.2, C201.2, C204.2, C205.2, C211.2, C212.2, C218.2, C219.2, U38.1 (VCCA), U39.1 (VCCA), U41.1 (VCCA), U42.1 (VCCA), U43.1 (VCCA), U44.1 (VCCA), U47.1 (VCCA), U48.1 (VCCA), U50.1 (VCCA), U51.1 (VCCA), U53.1 (VCCA), U54.1 (VCCA), U55.1 (VCCA), U56.1 (VCCA), U59.1 (VCCA), U60.1 (VCCA), U62.1 (VCCA), U63.1 (VCCA), U65.1 (VCCA), U66.1 (VCCA), U67.1 (VCCA), U68.1 (VCCA), U71.1 (VCCA), U72.1 (VCCA); also elsewhere on the board
unnamed 454: D62.2 (A), R135.2, U49.3 (-); also elsewhere on the board
unnamed: D63.2 (A), R152.2, R160.1
unnamed: D64.2 (A), R153.2, R161.1
unnamed: D65.2 (A), R154.2, R162.1
unnamed: D66.2 (A), R155.2, R163.1
unnamed: D67.2 (A), R156.2, R164.1
unnamed: D68.2 (A), R157.2, R165.1
unnamed: D69.2 (A), R158.2, R166.1
unnamed: D70.2 (A), R159.2, R167.1
unnamed 463: D82.2 (A), R177.2, U61.3 (-); also elsewhere on the board
unnamed: D83.2 (A), R194.2, R202.1
unnamed: D84.2 (A), R195.2, R203.1
unnamed: D85.2 (A), R196.2, R204.1
unnamed: D86.2 (A), R197.2, R205.1
unnamed: D87.2 (A), R198.2, R206.1
unnamed: D88.2 (A), R199.2, R207.1
unnamed: D89.2 (A), R200.2, R208.1
unnamed: D90.2 (A), R201.2, R209.1
unnamed 472: D102.2 (A), R219.2, U73.3 (-); also elsewhere on the board
unnamed: D103.2 (A), R236.2, R244.1
unnamed: D104.2 (A), R237.2, R245.1
unnamed: D105.2 (A), R238.2, R246.1
unnamed: D106.2 (A), R239.2, R247.1
unnamed: D107.2 (A), R240.2, R248.1
unnamed: D108.2 (A), R241.2, R249.1
unnamed: D109.2 (A), R242.2, R250.1
unnamed: D110.2 (A), R243.2, R251.1
unnamed: R131.1, R132.2
unnamed: R132.3, R133.1
unnamed: R173.1, R174.2
unnamed: R174.3, R175.1
unnamed: R215.1, R216.2
unnamed: R216.3, R217.1
unnamed: R128.1, U40.8 (S-CONF)
unnamed: L8.1, U40.4 (SW)
unnamed: C156.1, C159.1, L8.2, R129.1, R132.1, U40.3 (VOS)
unnamed: C167.1, U45.A2 (Gate)
unnamed: D61.3, TP22.1 (1_1), U46.3 (~Alert)
unnamed: R170.1, U52.8 (S-CONF)
unnamed: L9.1, U52.4 (SW)
unnamed: C181.1, C184.1, L9.2, R171.1, R174.1, U52.3 (VOS)
unnamed: C192.1, U57.A2 (Gate)
unnamed: D81.3, TP23.1 (1_1), U58.3 (~Alert)
unnamed: R212.1, U64.8 (S-CONF)
unnamed: L10.1, U64.4 (SW)
unnamed: C206.1, C209.1, L10.2, R213.1, R216.1, U64.3 (VOS)
unnamed: C217.1, U69.A2 (Gate)
unnamed: D101.3, TP24.1 (1_1), U70.3 (~Alert)

Notes on the sheet:
S-CONF: 1MHz fSW, fPWM, output dischg
Output reverse-current/voltage blocking.
{DIR[0..7] Y[0..7]}
Output dschg.
Vio LED
Keep same resistor value as for green status LED.
PG doen't work when injecting current.
Populate in case of emergency or if we can't source this IC.
