tachiniererin/glasgow/hardware/boards/glasgow/revD1/glasgow.kicad_pcb

## KiCad design hardware/boards/glasgow/revD1/glasgow.kicad_pcb (continued)

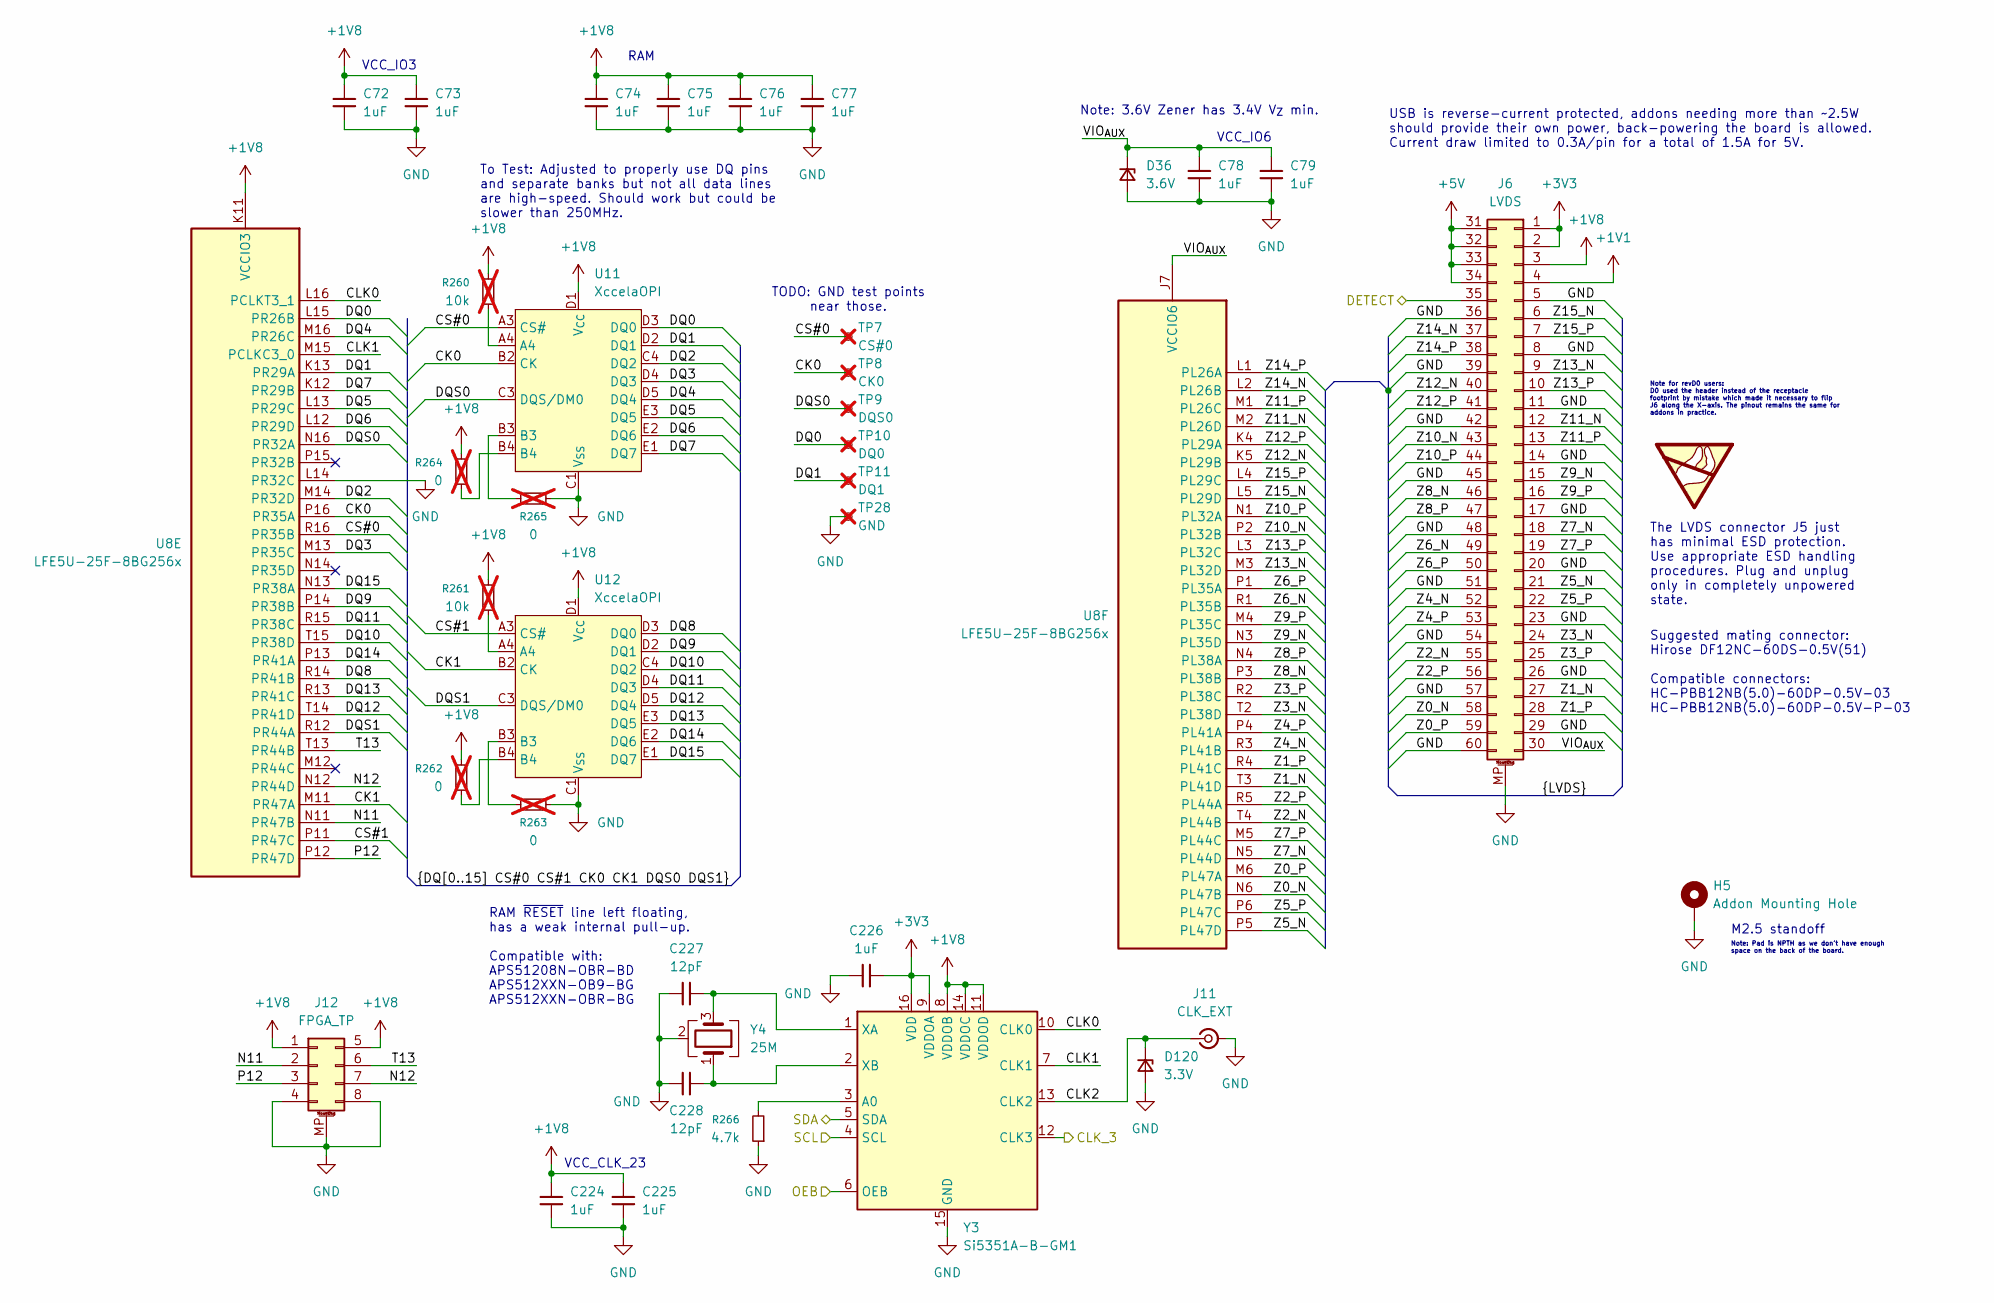
[picture p8: schematic ram_lvds.kicad_sch, FPGA - RAM and LVDS]

Parts:
C72, C73, C78, C79, C224, C225, C226: 1uF; C_0201_0603Metric; MPN CL03A105MO3NRNH; LCSC C307385
C74, C75, C76, C77: 1uF; C_0402_1005Metric; MPN CL05A105KA5NQNC; LCSC C52923
C227, C228: 12pF; C_0402_1005Metric; MPN 0402CG120J500NT; LCSC C1547
D36: 3.6V; D_SOD-523; MPN BZX584C3V6; LCSC C22395574
D120: 3.3V; D_0201_0603Metric; MPN TPD1E04U04DPLR-TP; LCSC C41408060
H5: Addon Mounting Hole; Mounting_Wuerth_WA-SMSI-M2.5_H5mm_9774050151; MPN 9774050151R; LCSC C5457026
J6: LVDS; Hirose_DF12NB_DF12E3.0-60DP-0.5V_2x30_P0.50mm_Vertical; MPN DF12NC(5.0)-60DP-0.5V(51); LCSC C3645041
J11: CLK_EXT; U.FL_Molex_MCRF_73412-0110_Vertical; MPN KH-IPEX-K501-29; LCSC C411563
J12: FPGA_TP; Hirose_BM29_BM29B0.6-4DS_2-0.35V; MPN BM29B0.6-4DS/2-0.35V(51); LCSC C3646565
R260, R261: 10k; R_0201_0603Metric; MPN RC0201FR-0710KL; LCSC C106225; not fitted
R262, R263, R264, R265: 0; R_0201_0603Metric; MPN RC0201FR-070RL; LCSC C106227; not fitted
R266: 4.7k; R_0201_0603Metric; MPN 0201WMF4701TEE; LCSC C270346
TP7: CS#0; TestPoint_Pad_D0.5mm; not fitted
TP8: CK0; TestPoint_Pad_D0.5mm; not fitted
TP9: DQS0; TestPoint_Pad_D0.5mm; not fitted
TP10: DQ0; TestPoint_Pad_D0.5mm; not fitted
TP11: DQ1; TestPoint_Pad_D0.5mm; not fitted
TP28: GND; TestPoint_Pad_D0.5mm; not fitted
U8: LFE5U-25F-8BG256x; BGA-256_14.0x14.0mm_Layout16x16_P0.8mm_Ball0.45mm_Pad0.32mm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; MPN LFE5U-25F-6BG256C; LCSC C1521614
U11, U12: XccelaOPI; BGA-24_6x8mm_Layout5x5_P1.0mm; MPN APS51208N-OBR-BD
Y3: Si5351A-B-GM1; QFN-16-1EP_3x3mm_P0.5mm_EP1.75x1.75mm; MPN SI5351A-B-GM1; LCSC C3609352
Y4: 25M; Crystal_SMD_3225-4Pin_3.2x2.5mm; MPN X322512MSB4SI; LCSC C9002

Connections:
+1V1: J6.4; also elsewhere on the board
+1V8: C72.1, C73.1, C74.1, C75.1, C76.1, C77.1, C224.1, C225.1, J6.3, J12.1, J12.5, R260.1, R261.1, R262.2, R264.2, U8.K11 (VCCIO3), U8.L11 (VCCIO3), U11.D1 (V_{CC}), U11.E4 (V_{CC}), U12.D1 (V_{CC}), U12.E4 (V_{CC}), Y3.8 (VDDOB), Y3.11 (VDDOD), Y3.14 (VDDOC); also elsewhere on the board
+3V3: C226.2, J6.1, J6.2, Y3.9 (VDDOA), Y3.16 (VDD); also elsewhere on the board
+5V: J6.31, J6.32, J6.33, J6.34; also elsewhere on the board
/FPGA/CLK_3: Y3.12 (CLK3); also elsewhere on the board
/FPGA/OEB: Y3.6 (OEB); also elsewhere on the board
/FPGA/RAM + LVDS/CK0: TP8.1 (1_1), U8.P16 (PR35A), U11.B2 (CK)
/FPGA/RAM + LVDS/CK1: U8.M11 (PR47A), U12.B2 (CK)
/FPGA/RAM + LVDS/CLK0: U8.L16 (PCLKT3_1), Y3.10 (CLK0)
/FPGA/RAM + LVDS/CLK1: U8.M15 (PCLKC3_0), Y3.7 (CLK1)
/FPGA/RAM + LVDS/CLK2: D120.1 (K), J11.1 (In), Y3.13 (CLK2)
/FPGA/RAM + LVDS/CS#0: TP7.1 (1_1), U8.R16 (PR35B), U11.A3 (CS#)
/FPGA/RAM + LVDS/CS#1: U8.P11 (PR47C), U12.A3 (CS#)
/FPGA/RAM + LVDS/DETECT: J6.35; also elsewhere on the board
/FPGA/RAM + LVDS/DQ0: TP10.1 (1_1), U8.L15 (PR26B), U11.D3 (DQ0)
/FPGA/RAM + LVDS/DQ1: TP11.1 (1_1), U8.K13 (PR29A), U11.D2 (DQ1)
/FPGA/RAM + LVDS/DQ2: U8.M14 (PR32D), U11.C4 (DQ2)
/FPGA/RAM + LVDS/DQ3: U8.M13 (PR35C), U11.D4 (DQ3)
/FPGA/RAM + LVDS/DQ4: U8.M16 (PR26C), U11.D5 (DQ4)
/FPGA/RAM + LVDS/DQ5: U8.L13 (PR29C), U11.E3 (DQ5)
/FPGA/RAM + LVDS/DQ6: U8.L12 (PR29D), U11.E2 (DQ6)
/FPGA/RAM + LVDS/DQ7: U8.K12 (PR29B), U11.E1 (DQ7)
/FPGA/RAM + LVDS/DQ8: U8.R14 (PR41B), U12.D3 (DQ0)
/FPGA/RAM + LVDS/DQ9: U8.P14 (PR38B), U12.D2 (DQ1)
/FPGA/RAM + LVDS/DQ10: U8.T15 (PR38D), U12.C4 (DQ2)
/FPGA/RAM + LVDS/DQ11: U8.R15 (PR38C), U12.D4 (DQ3)
/FPGA/RAM + LVDS/DQ12: U8.T14 (PR41D), U12.D5 (DQ4)
/FPGA/RAM + LVDS/DQ13: U8.R13 (PR41C), U12.E3 (DQ5)
/FPGA/RAM + LVDS/DQ14: U8.P13 (PR41A), U12.E2 (DQ6)
/FPGA/RAM + LVDS/DQ15: U8.N13 (PR38A), U12.E1 (DQ7)
/FPGA/RAM + LVDS/DQS0: TP9.1 (1_1), U8.N16 (PR32A), U11.C3 (DQS/DM0)
/FPGA/RAM + LVDS/DQS1: U8.R12 (PR44A), U12.C3 (DQS/DM0)
/FPGA/RAM + LVDS/N11: J12.2, U8.N11 (PR47B)
/FPGA/RAM + LVDS/N12: J12.7, U8.N12 (PR44D)
/FPGA/RAM + LVDS/P12: J12.3, U8.P12 (PR47D)
/FPGA/RAM + LVDS/T13: J12.6, U8.T13 (PR44B)
/FPGA/RAM + LVDS/VIO_{AUX}: C78.1, C79.1, D36.1 (K), J6.30, U8.J6 (VCCIO6), U8.J7 (VCCIO6)
/FPGA/RAM + LVDS/Z0_N: J6.58, U8.N6 (PL47B)
/FPGA/RAM + LVDS/Z0_P: J6.59, U8.M6 (PL47A)
/FPGA/RAM + LVDS/Z1_N: J6.27, U8.T3 (PL41D)
/FPGA/RAM + LVDS/Z1_P: J6.28, U8.R4 (PL41C)
/FPGA/RAM + LVDS/Z2_N: J6.55, U8.T4 (PL44B)
/FPGA/RAM + LVDS/Z2_P: J6.56, U8.R5 (PL44A)
/FPGA/RAM + LVDS/Z3_N: J6.24, U8.T2 (PL38D)
/FPGA/RAM + LVDS/Z3_P: J6.25, U8.R2 (PL38C)
/FPGA/RAM + LVDS/Z4_N: J6.52, U8.R3 (PL41B)
/FPGA/RAM + LVDS/Z4_P: J6.53, U8.P4 (PL41A)
/FPGA/RAM + LVDS/Z5_N: J6.21, U8.P5 (PL47D)
/FPGA/RAM + LVDS/Z5_P: J6.22, U8.P6 (PL47C)
/FPGA/RAM + LVDS/Z6_N: J6.49, U8.R1 (PL35B)
/FPGA/RAM + LVDS/Z6_P: J6.50, U8.P1 (PL35A)
/FPGA/RAM + LVDS/Z7_N: J6.18, U8.N5 (PL44D)
/FPGA/RAM + LVDS/Z7_P: J6.19, U8.M5 (PL44C)
/FPGA/RAM + LVDS/Z8_N: J6.46, U8.P3 (PL38B)
/FPGA/RAM + LVDS/Z8_P: J6.47, U8.N4 (PL38A)
/FPGA/RAM + LVDS/Z9_N: J6.15, U8.N3 (PL35D)
/FPGA/RAM + LVDS/Z9_P: J6.16, U8.M4 (PL35C)
/FPGA/RAM + LVDS/Z10_N: J6.43, U8.P2 (PL32B)
/FPGA/RAM + LVDS/Z10_P: J6.44, U8.N1 (PL32A)
/FPGA/RAM + LVDS/Z11_N: J6.12, U8.M2 (PL26D)
/FPGA/RAM + LVDS/Z11_P: J6.13, U8.M1 (PL26C)
/FPGA/RAM + LVDS/Z12_N: J6.40, U8.K5 (PL29B)
/FPGA/RAM + LVDS/Z12_P: J6.41, U8.K4 (PL29A)
/FPGA/RAM + LVDS/Z13_N: J6.9, U8.M3 (PL32D)
/FPGA/RAM + LVDS/Z13_P: J6.10, U8.L3 (PL32C)
/FPGA/RAM + LVDS/Z14_N: J6.37, U8.L2 (PL26B)
/FPGA/RAM + LVDS/Z14_P: J6.38, U8.L1 (PL26A)
/FPGA/RAM + LVDS/Z15_N: J6.6, U8.L5 (PL29D)
/FPGA/RAM + LVDS/Z15_P: J6.7, U8.L4 (PL29C)
/SCL: Y3.4 (SCL); also elsewhere on the board
/SDA: Y3.5 (SDA); also elsewhere on the board
GND: C72.2, C73.2, C74.2, C75.2, C76.2, C77.2, C78.2, C79.2, C224.2, C225.2, C226.1, C227.1, C228.1, D36.2 (A), D120.2 (A), H5.1 (1_1), J6.5, J6.8, J6.11, J6.14, J6.17, J6.20, J6.23, J6.26, J6.29, J6.36, J6.39, J6.42, J6.45, J6.48, J6.51, J6.54, J6.57, J6.60, J6.MP (MountPin), J11.2 (Ext), J12.4, J12.8, J12.MP (MountPin), R263.2, R265.2, R266.1, TP28.1 (1_1), U8.L14 (PR32C), U11.C1 (V_{SS}), U11.E5 (V_{SS}), U12.C1 (V_{SS}), U12.E5 (V_{SS}), Y3.15 (GND), Y3.17 (GND), Y4.2 (G), Y4.4 (G); also elsewhere on the board
unnamed: R260.2, U11.A4
unnamed: R261.2, U12.A4
unnamed: R262.1, U12.B4
unnamed: R263.1, U12.B3
unnamed: R264.1, U11.B4
unnamed: R265.1, U11.B3
unnamed: R266.2, Y3.3 (A0)
unnamed: C227.2, Y3.1 (XA), Y4.3
unnamed: C228.2, Y3.2 (XB), Y4.1

Notes on the sheet:
Note: Pad is NPTH as we don't have enough space on the back of the board.
VCC_IO3
To Test: Adjusted to properly use DQ pins and separate banks but not all data lines are high-speed. Should work but could be slower than 250MHz.
VCC_CLK_23
Note for revD0 users: D0 used the header instead of the receptacle footprint by mistake which made it necessary to flip J6 along the X-axis. The pinout remains the same for addons in practice.
USB is reverse-current protected, addons needing more than ~2.5W should provide their own power, back-powering the board is allowed. Current draw limited to 0.3A/pin for a total of 1.5A for 5V.
The LVDS connector J5 just has minimal ESD protection. Use appropriate ESD handling procedures. Plug and unplug only in completely unpowered state.
Suggested mating connector: Hirose DF12NC-60DS-0.5V(51) Compatible connectors: HC-PBB12NB(5.0)-60DP-0.5V-03 HC-PBB12NB(5.0)-60DP-0.5V-P-03
M2.5 standoff
Note: 3.6V Zener has 3.4V V_{Z} min.
TODO: GND test points near those.
VCC_IO6
RAM
RAM ~{RESET} line left floating, has a weak internal pull-up. Compatible with: APS51208N-OBR-BD APS512XXN-OB9-BG APS512XXN-OBR-BG

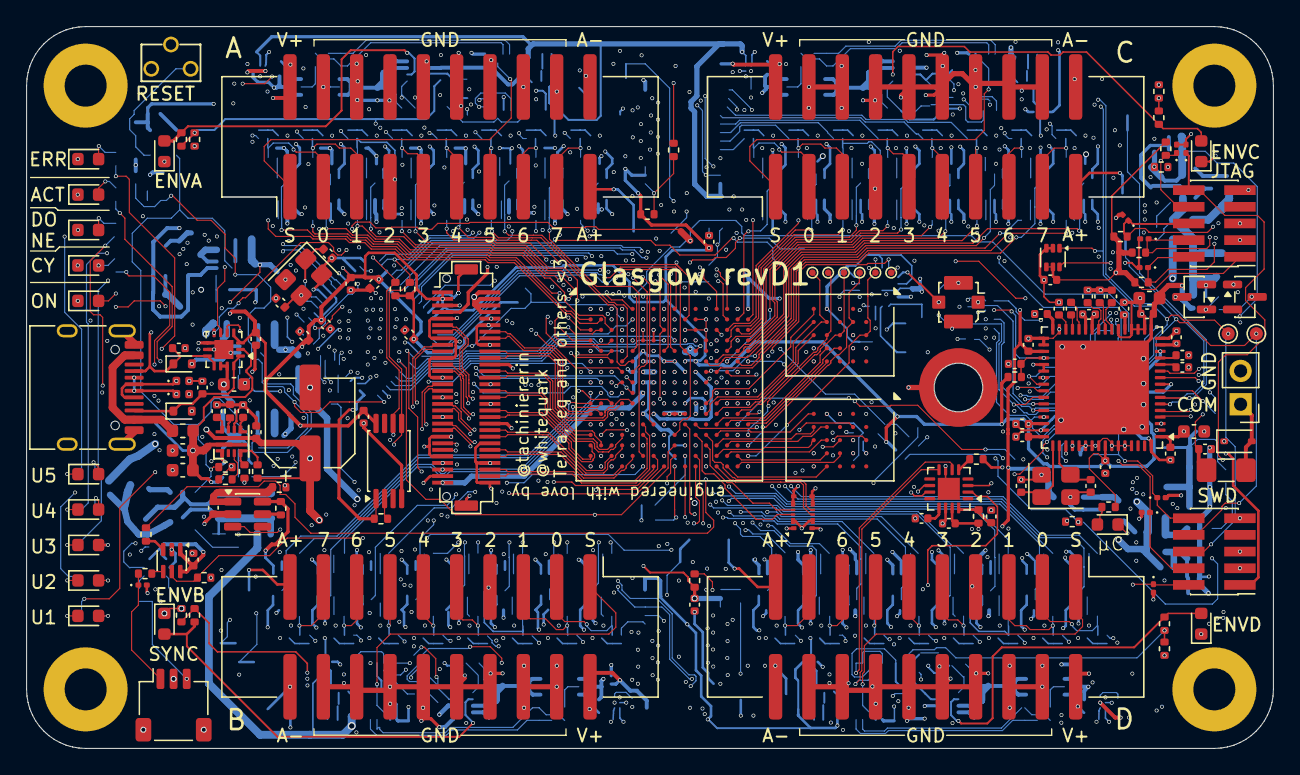
[picture p9: board glasgow.kicad_pcb from above]

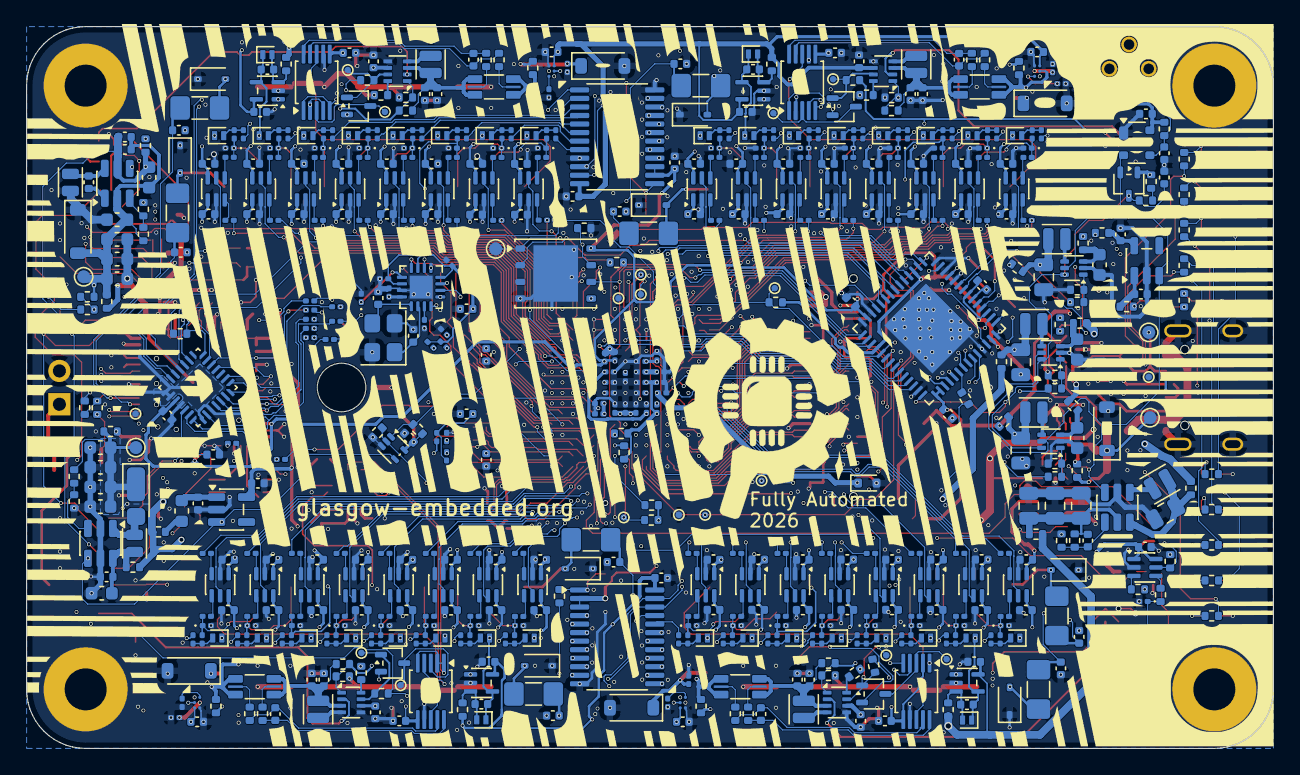
[picture p10: board glasgow.kicad_pcb from below]

Board: 6 copper layers, 95.0 x 55.0 mm, 782 parts (626 on the bottom side), 561 nets.

Other parts of the board:
C173, C198, C223: C_0402_1005Metric

Their connections:
/IO Banks/Bank B/V_{CLAMP}: C173.1; also elsewhere on the board
/IO Banks/Bank C/V_{CLAMP}: C198.1; also elsewhere on the board
/IO Banks/Bank D/V_{CLAMP}: C223.1; also elsewhere on the board
unnamed 454: C173.2; also elsewhere on the board
unnamed 463: C198.2; also elsewhere on the board
unnamed 472: C223.2; also elsewhere on the board
